dpduanpu/OncillaHardware/electronics/infrared-sensor/README.md

# Oncilla Infrared Camera

An Infrared Camera based on a Wii Sensor has been developed by Jonas Degrave for the Oncilla robot. However all work have been done through the collaborative website [123d circuits.io](http://http://123d.circuits.io/).

All schematics and PCB blueprint can be found [here](http://123d.circuits.io/circuits/47329-wii-v4-15#)
