dpduanpu/OncillaHardware/mechanics/oncilla/hip-front-new-right-2012-09-04.SLDASM

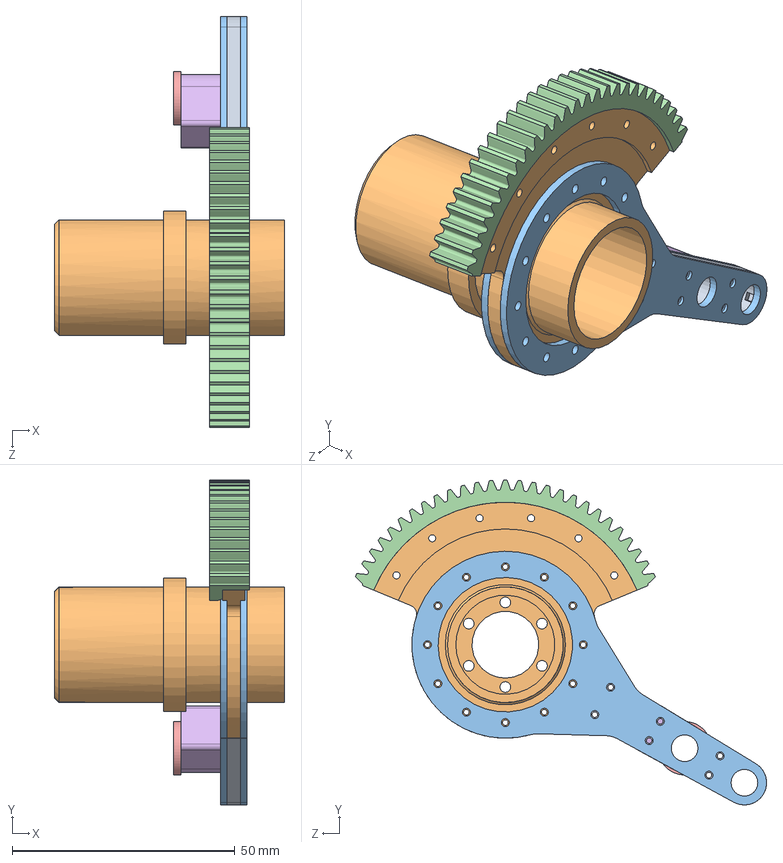
[picture p1: CAD file, 2014-03-28]
mechanics/oncilla/hip-front-new-right-2012-09-04.SLDASM
51.7 x 73.0 x 92.4 mm
abs-hip-front-2012-11-20
carbon-plat-hip-front x 2
Pom-plat-hip-front-04-03-13
Washer-d6p5-12
distancepiece_legsprings_011112_Mill_Pom
