dpduanpu/OncillaHardware/mechanics/oncilla/ASS-spring-diag-hind.sldasm

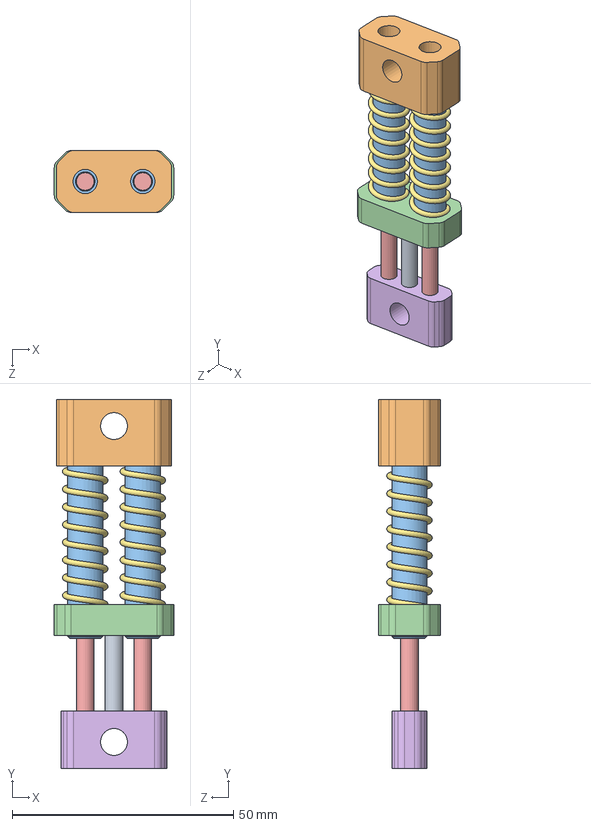
[picture p2: CAD file, 2014-03-28]
mechanics/oncilla/ASS-spring-diag-hind.sldasm
27.0 x 83.4 x 14.0 mm
al-slider-short-front
POM-cube-l2-lower
Pom1_d8-l44 x 2
double-slider
AL-D4-L50-Hind x 2
POM-cube-l2-upper
Spring_WM12-40 x 2
