dpduanpu/OncillaHardware/mechanics/oncilla/MirrorAssemL2-front.SLDASM

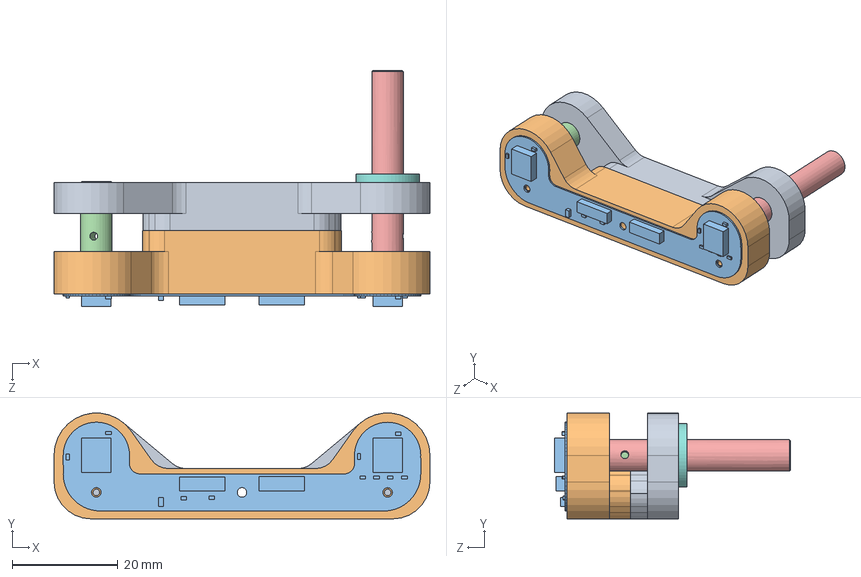
[picture p3: CAD file, 2014-03-28]
mechanics/oncilla/MirrorAssemL2-front.SLDASM
71.0 x 20.0 x 44.6 mm
Sym-POM-l2_v2-55mm-v3
Sym-ABS-l2_v2-55mm-v2
knee_encoder_front-ver-april18
pin-d6-l24
pin-d6-l33
Dia6x2p5 x 2
bush-d6-10 x 2
Washer-d6p5-12
