dpduanpu/OncillaHardware/mechanics/oncilla/Leg-Hind-Right.SLDASM

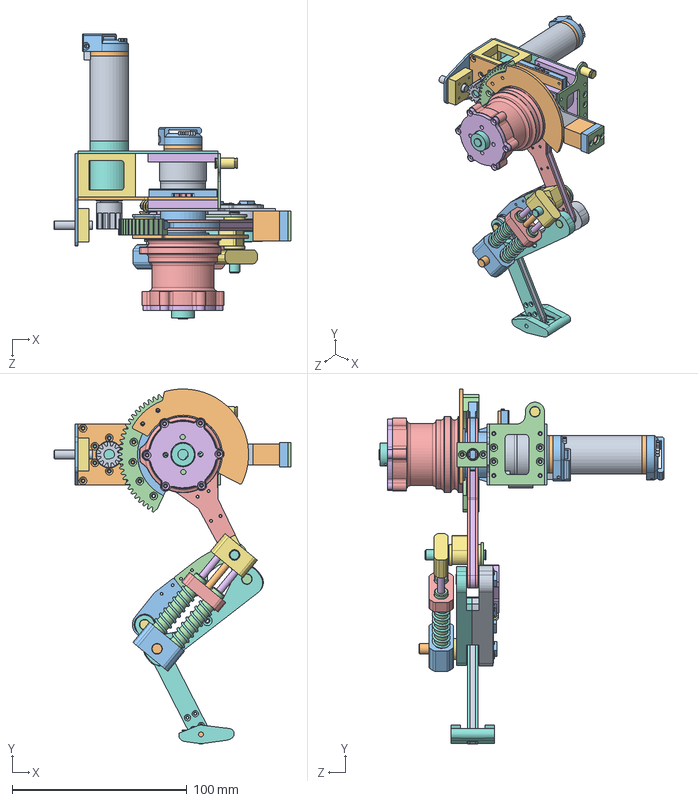
[picture p4: CAD file, 2014-03-28]
mechanics/oncilla/Leg-Hind-Right.SLDASM
135.3 x 202.9 x 162.9 mm
angle-fixation-POM-2012-11-08-bb2
angle-fixation-POM-BB-2012-11-08
carbon-1p5-cover-bb
bb-8x5x2p5 x 4
pom-holder
plate-side-4
clamp2
plate-side-1
N25_knee_motor_encoder
pom-bush-4x4
POM-fixation-abs-shoulde-rectangle
gearbox_MaxonHP22Ratio14 x 2
motor_Maxon90W4pole x 2
EncoderMotor x 2
MaxonCap_4march2013 x 2
RingGearN30
transmission-planetshell-4march2013-abs-print
LidPlanetGB
Planet_Revolving_FollowerN10h3mm x 4
Sun_DriverN10h4mm
N12_hip
Dia6x2p5 x 3
holder-encoder-hip
pcb_hip_encoder
M1-N12
SlipRing2
al_d6_1 x 2
Sym-l2-hind-65mm-v4
Sym-l2-hind-v4-65mm-inside
pin-d6-l33
knee_encoder_hind-ver-april18th
pin-d6-l24
bush-d6-10 x 2
bush-MDZB6-4-misumi x 2
Washer-d6p5-12 x 4
foot-print-mod1
Spring_RSF-1096R x 2
d3-l20
Part1-knee-mod3-hind
Part2-knee-mod3-hind
part2-knee-mod1
part4-knee-mod1 x 2
Spring_DF-1670
d5l35
lock washer for shafts_din x 2
washer-m3-6-3-1 x 4
abs-hip-front-2012-11-20
Hip_gear
carbon-plate-hip-hind x 2
Pom-plat-hip-hind-04-03-13
distancepiece_legsprings_011112_Mill_Pom
l3-sandwich-hind x 2
l3-sandwich-POM-hind
al-slider-short-front
POM-cube-l2-lower
Pom1_d8-l44 x 2
double-slider
AL-D4-L50-Hind x 2
POM-cube-l2-upper
Spring_WM12-40 x 2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
