dpduanpu/OncillaHardware/mechanics/oncilla/Assem1-knee-mod2-front.SLDASM

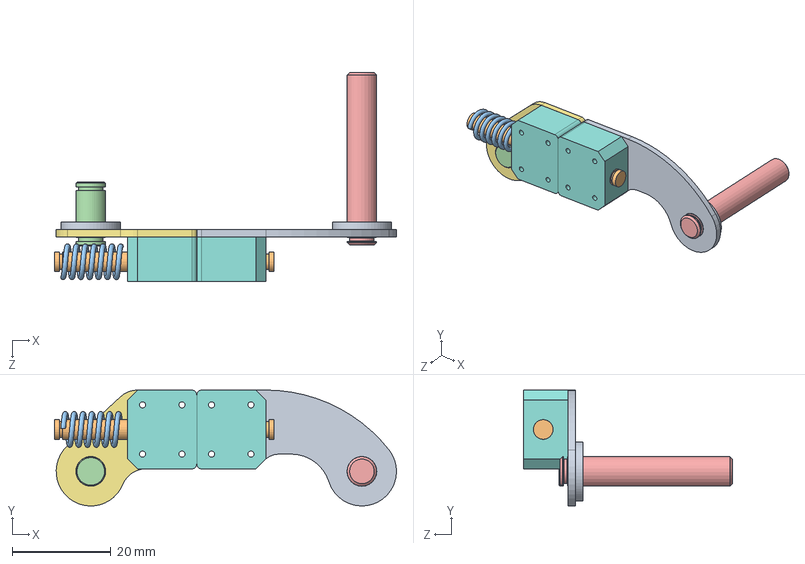
[picture p5: CAD file, 2014-03-28]
mechanics/oncilla/Assem1-knee-mod2-front.SLDASM
69.4 x 23.5 x 42.4 mm
Part2-knee-mod3-front
part2-knee-mod1
Spring_DF-1670
al_d6_1
d5l35
lock washer for shafts_din x 5
Part1-knee-mod3-front
part4-knee-mod1 x 2
Washer-d6p5-12 x 2
