dpduanpu/OncillaHardware/mechanics/oncilla/Assem1^ASS-spring-diag-hind.SLDASM

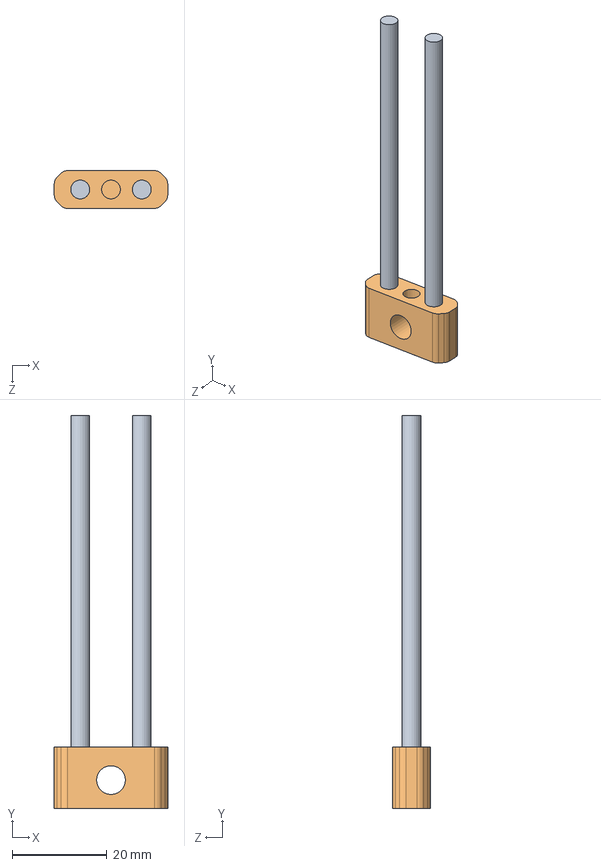
[picture p6: CAD file, 2014-03-28]
mechanics/oncilla/Assem1^ASS-spring-diag-hind.SLDASM
24.0 x 83.0 x 8.00 mm
AL-D4-L50-Hind x 2
POM-cube-l2-upper
