dpduanpu/OncillaHardware/mechanics/oncilla/hip-front-new-left-2012-09-04.SLDASM

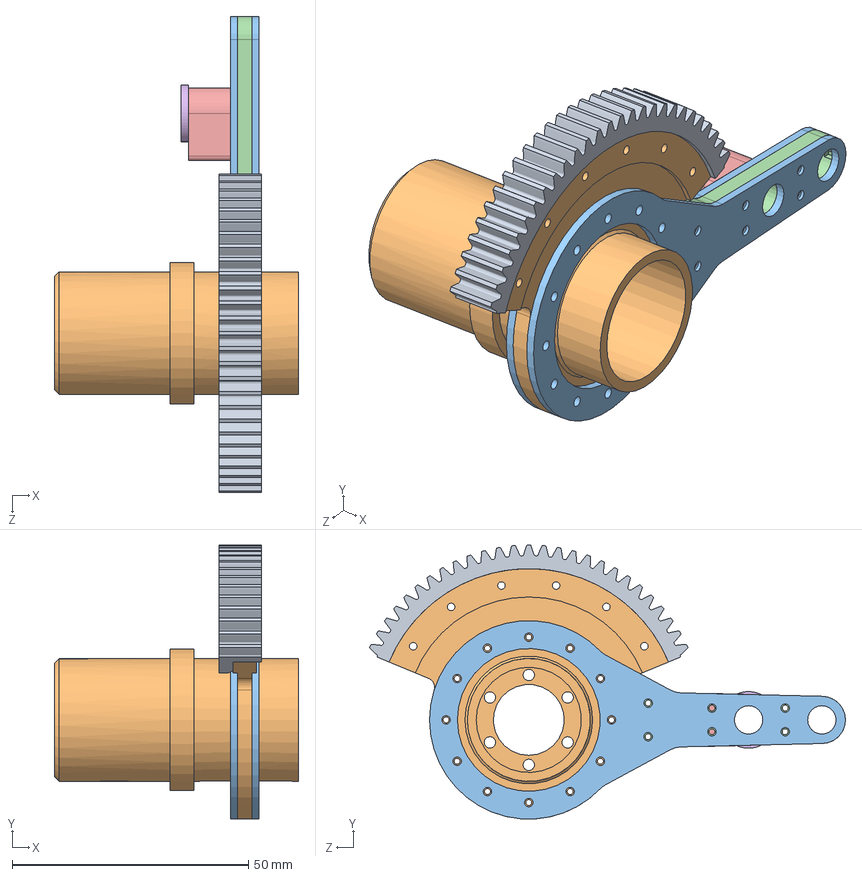
[picture p7: CAD file, 2014-03-28]
mechanics/oncilla/hip-front-new-left-2012-09-04.SLDASM
51.7 x 58.0 x 100.7 mm
abs-hip-front-2012-11-20
carbon-plat-hip-front x 2
Hip_gear
Pom-plat-hip-front-04-03-13
distancepiece_legsprings_011112_Mill_Pom
Washer-d6p5-12
