dpduanpu/OncillaHardware/mechanics/oncilla/clamp_new.SLDASM

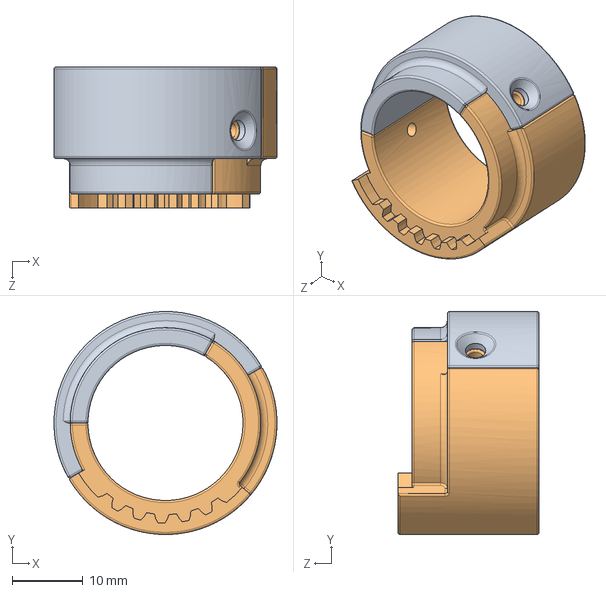
[picture p8: CAD file, 2014-03-28]
mechanics/oncilla/clamp_new.SLDASM
31.6 x 31.6 x 20.0 mm
clamp_lower
clamp_upper
