dpduanpu/OncillaHardware/mechanics/oncilla/bb-fixation-diagonal1.sldasm

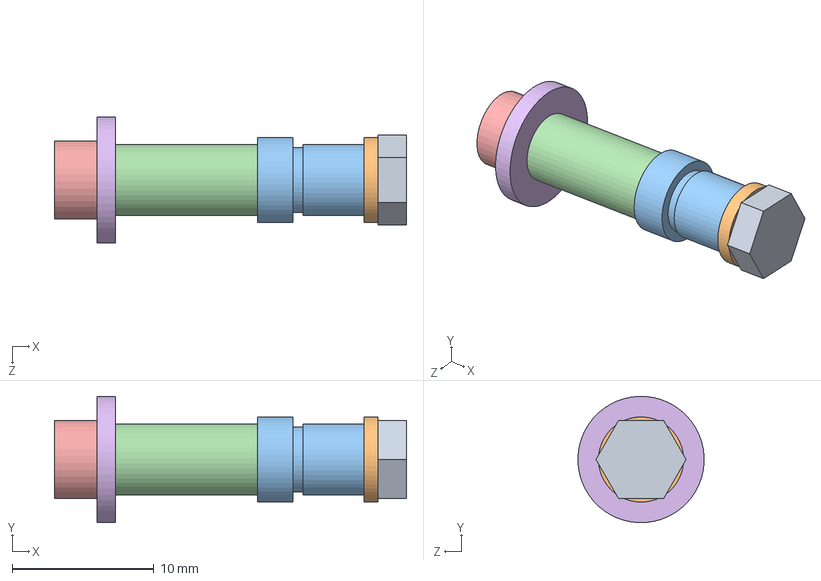
[picture p9: CAD file, 2014-03-28]
mechanics/oncilla/bb-fixation-diagonal1.sldasm
24.8 x 8.90 x 8.89 mm
m3-shorthead
washer-m3-6-3-1
d5-d6-alu-b2p5-b5
axis-hip-l10-PM-20120918
M3L14-BN3-DIN912-ISO4762
washer-m3-douter8p9-width1p3
