dpduanpu/OncillaHardware/mechanics/oncilla/force-setup.SLDASM

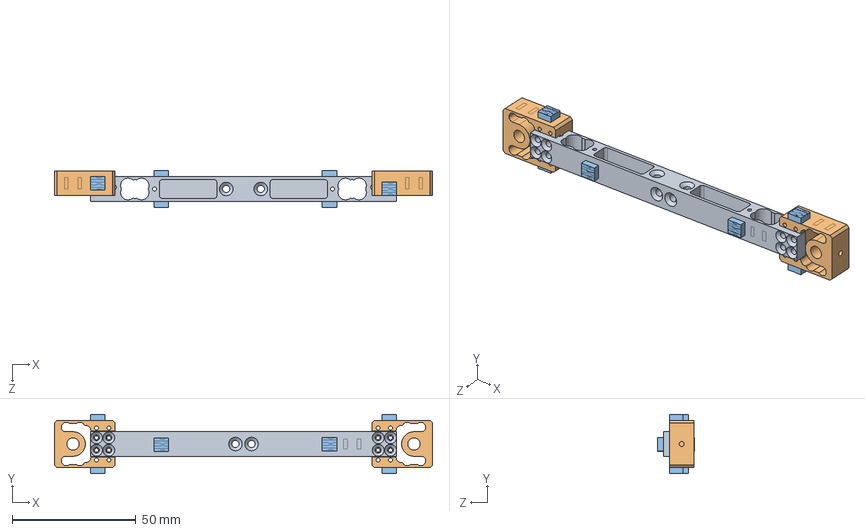
[picture p10: CAD file, 2014-03-28]
mechanics/oncilla/force-setup.SLDASM
153.0 x 24.0 x 15.0 mm
load-cell-alu-beam-force-horizontal-2012-08-25
load-cell-alu-y-force-beam x 2
fr4-0p8-pcb-bridge-force-sensor x 8
