dpduanpu/OncillaHardware/mechanics/oncilla/carbon-l3-sandwich.SLDASM

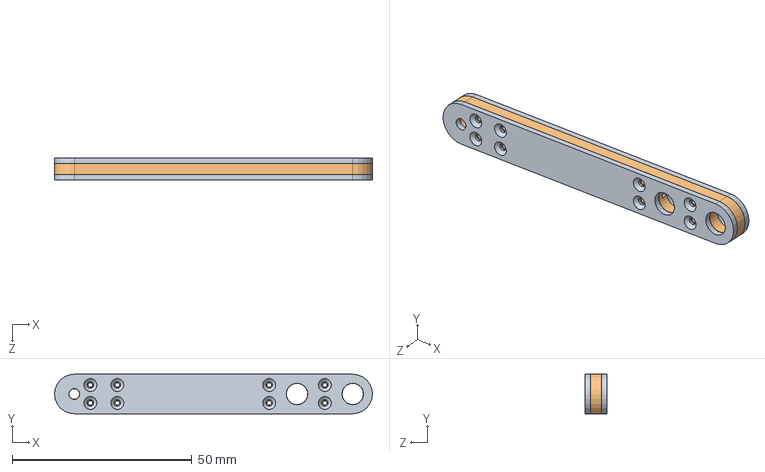
[picture p11: CAD file, 2014-03-28]
mechanics/oncilla/carbon-l3-sandwich.SLDASM
88.5 x 11.0 x 6.00 mm
l3-sandwich x 2
l3-sandwich_pom
