dpduanpu/OncillaHardware/mechanics/oncilla/hip-hind-new-right-2012-09-05.SLDASM

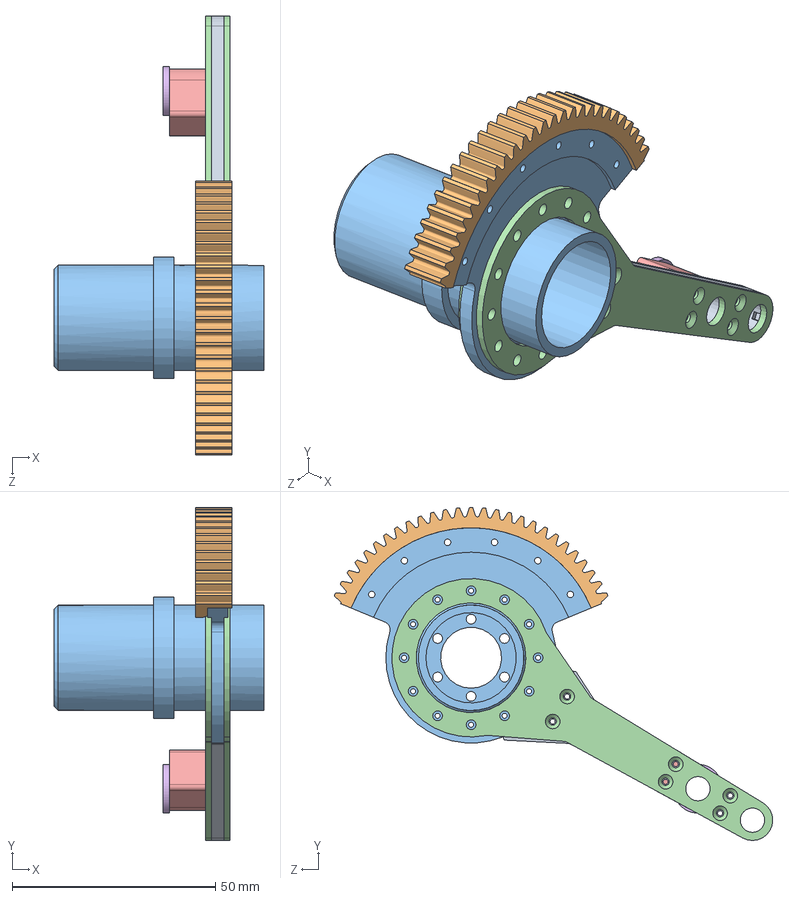
[picture p12: CAD file, 2014-03-28]
mechanics/oncilla/hip-hind-new-right-2012-09-05.SLDASM
51.7 x 82.0 x 108.0 mm
abs-hip-front-2012-11-20
Hip_gear
carbon-plate-hip-hind x 2
Pom-plat-hip-hind-04-03-13
distancepiece_legsprings_011112_Mill_Pom
Washer-d6p5-12
