dpduanpu/OncillaHardware/mechanics/oncilla/MotorGearbox_Maxon90W22HP14.SLDASM

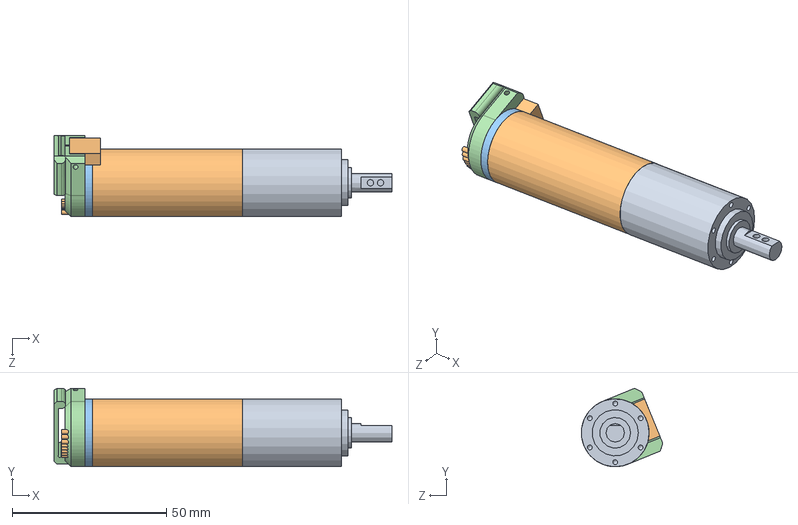
[picture p13: CAD file, 2014-03-28]
mechanics/oncilla/MotorGearbox_Maxon90W22HP14.SLDASM
109.6 x 25.4 x 26.4 mm
gearbox_MaxonHP22Ratio14
motor_Maxon90W4pole
EncoderMotor
MaxonCap_4march2013
