dpduanpu/OncillaHardware/mechanics/oncilla/force-assembly-front.SLDASM

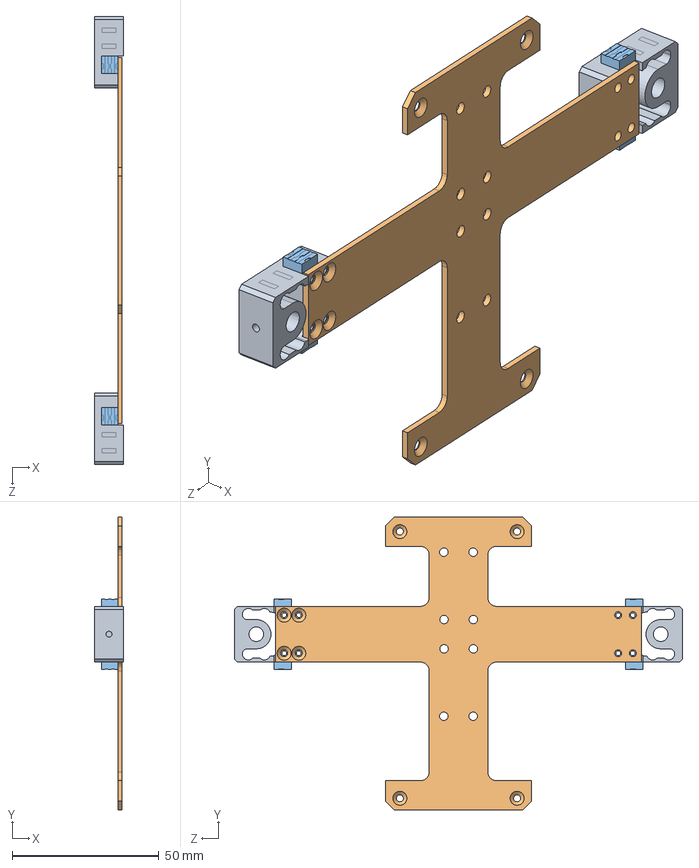
[picture p14: CAD file, 2014-03-28]
mechanics/oncilla/force-assembly-front.SLDASM
10.0 x 100.0 x 153.0 mm
load-cell-alu-y-force-beam-outside x 2
Part55-front
fr4-0p8-pcb-bridge-force-sensor x 4
