dpduanpu/OncillaHardware/mechanics/oncilla/Assem1-knee-mod1-hind.SLDASM

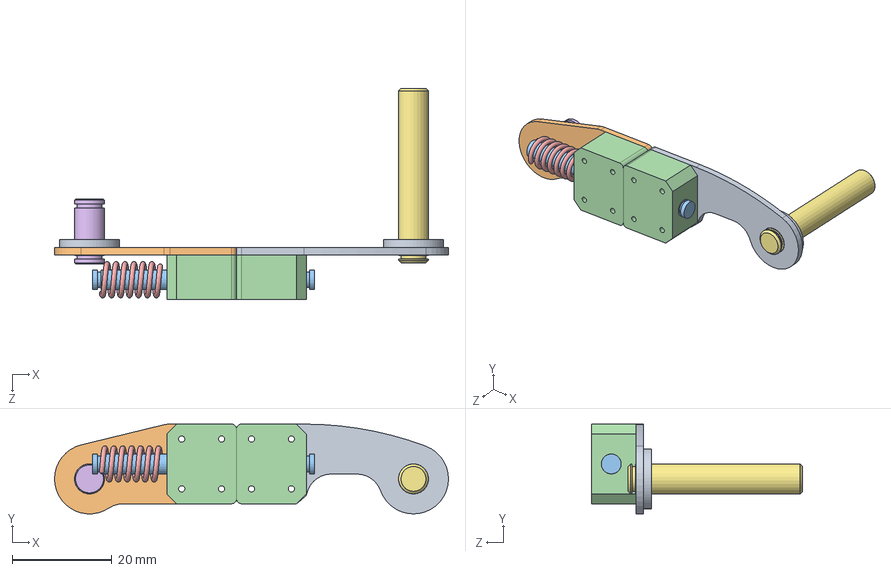
[picture p15: CAD file, 2014-03-28]
mechanics/oncilla/Assem1-knee-mod1-hind.SLDASM
79.0 x 18.0 x 42.4 mm
Part2-knee-mod3-hind
Part1-knee-mod3-hind
part2-knee-mod1
part4-knee-mod1 x 2
Spring_DF-1670
al_d6_1
d5l35
lock washer for shafts_din x 4
Washer-d6p5-12 x 2
