dpduanpu/OncillaHardware/mechanics/oncilla/ShoulderRHL.sldasm

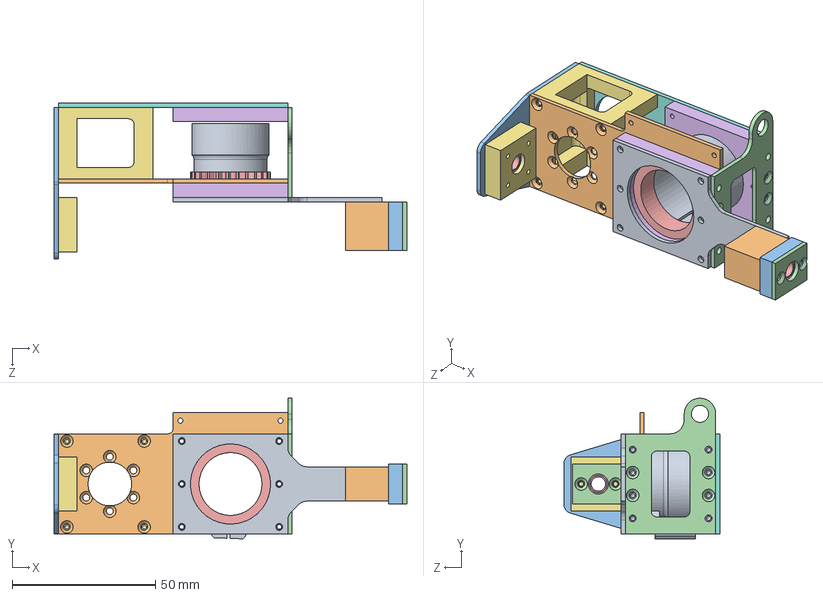
[picture p16: CAD file, 2014-03-28]
mechanics/oncilla/ShoulderRHL.sldasm
123.3 x 49.2 x 54.5 mm
angle-fixation-POM-2012-11-08-bb2
angle-fixation-POM-BB-2012-11-08
carbon-1p5-cover-bb
bb-8x5x2p5 x 4
pom-holder
plate-side-4
clamp2
plate-side-1
N25_knee_motor_encoder
pom-bush-4x4
POM-fixation-abs-shoulde-rectangle
