dpduanpu/OncillaHardware/mechanics/oncilla/trunk-assembly.SLDASM

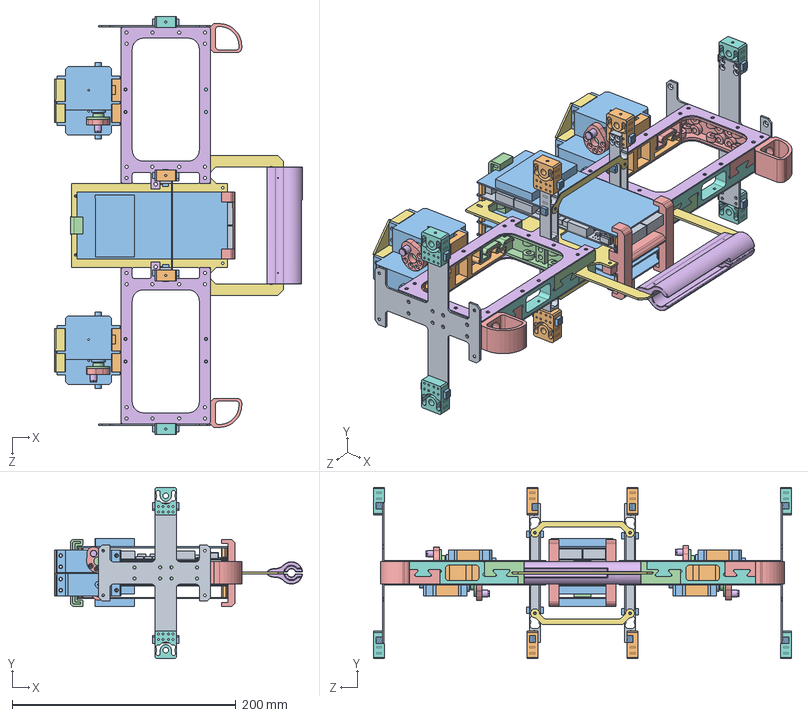
[picture p17: CAD file, 2014-03-28]
mechanics/oncilla/trunk-assembly.SLDASM
221.7 x 153.0 x 374.0 mm
load-cell-alu-beam-force-horizontal-2012-08-25 x 2
load-cell-alu-y-force-beam x 4
fr4-0p8-pcb-bridge-force-sensor x 24
abs-connector-mid-front-hind x 2
abs-column-outside x 2
al-back-left x 4
frame-temp
load-cell-alu-y-force-beam-outside x 4
Part55-front x 2
abs-servo-connectors-z-version2 x 2
kondo-krs-2350-ics-asp-2012-02-16 x 4
horn-servo-puppy x 4
holder-ServoHorn-03052012-abs x 4
al_d5_8p5 x 4
Mirrorabs-servo-connectors-z-version2-down x 2
NOTMirrorabs_zwing x 2
hex-standoff-m2p5-15SLDPRT x 10
simple_motordrive x 4
POM-support-PCB
abs-pcb-holder-top-2012-11-16
handle6_withBattery
carbon-thin-stripes-2012-05-09 x 2
