dpduanpu/OncillaHardware/mechanics/oncilla/hip-hind-new-left-2012-09-05.SLDASM

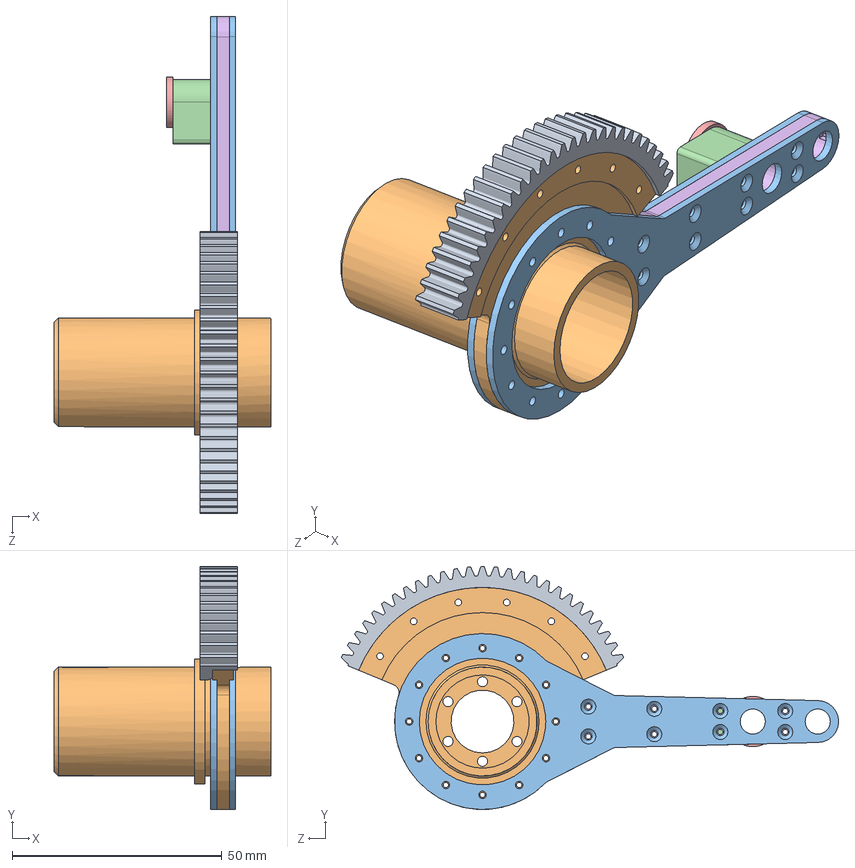
[picture p18: CAD file, 2014-03-28]
mechanics/oncilla/hip-hind-new-left-2012-09-05.SLDASM
51.7 x 58.0 x 118.7 mm
abs-hip-front-2012-11-20
Hip_gear
carbon-plate-hip-hind x 2
distancepiece_legsprings_011112_Mill_Pom
Washer-d6p5-12
Pom-plat-hip-hind-04-03-13
