dpduanpu/OncillaHardware/mechanics/oncilla/Leg-Fore-Right.SLDASM

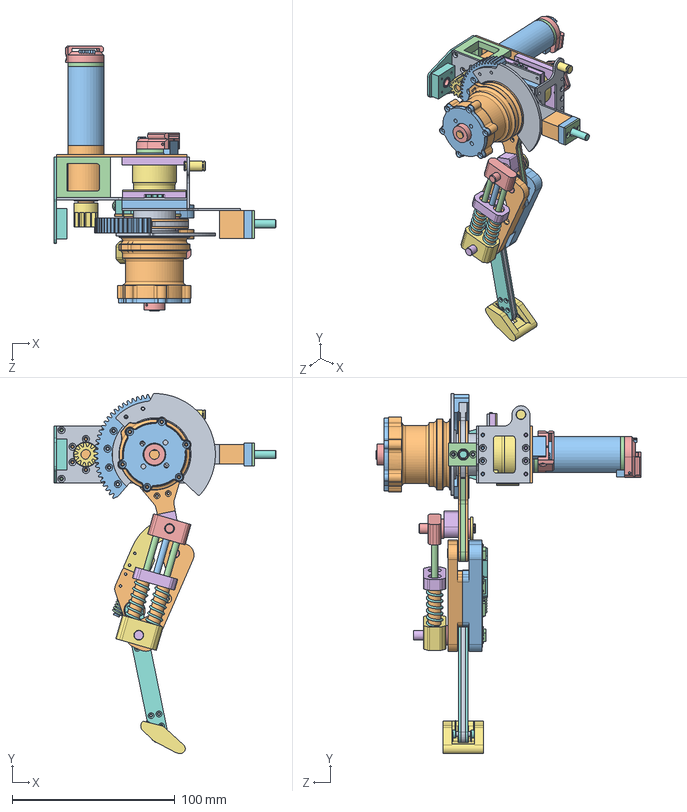
[picture p20: CAD file, 2014-03-28]
mechanics/oncilla/Leg-Fore-Right.SLDASM
136.3 x 221.4 x 162.9 mm
plate-side-1
gearbox_MaxonHP22Ratio14 x 2
motor_Maxon90W4pole x 2
EncoderMotor x 2
MaxonCap_4march2013 x 2
pom-bush-4x4
clamp2
plate-side-4
pom-holder
Dia6x2p5 x 3
holder-encoder-hip
pcb_hip_encoder
M1-N12
angle-fixation-POM-2012-11-08-bb2
angle-fixation-POM-BB-2012-11-08
carbon-1p5-cover-bb
bb-8x5x2p5 x 4
N25_knee_motor_encoder
N12_hip
axis-l25-dia5
RingGearN30
transmission-planetshell-4march2013-abs-print
LidPlanetGB
Planet_Revolving_FollowerN10h3mm x 4
Sun_DriverN10h4mm
SlipRing2
al_d6_1 x 2
POM-fixation-abs-shoulde-rectangle
abs-hip-front-2012-11-20
carbon-plat-hip-front x 2
Pom-plat-hip-front-04-03-13
Washer-d6p5-12 x 4
distancepiece_legsprings_011112_Mill_Pom
foot-print-mod1
Spring_RSF-1096R x 2
d3-l20
Part1-knee-mod3-front
part2-knee-mod1
Spring_DF-1670
d5l35
lock washer for shafts_din x 4
Part2-knee-mod3-front
part4-knee-mod1 x 2
washer-m3-6-3-1 x 4
Sym-POM-l2_v2-55mm-v3
Sym-ABS-l2_v2-55mm-v2
knee_encoder_front-ver-april18
pin-d6-l24
pin-d6-l33
bush-d6-10 x 2
l3-sandwich x 2
l3-sandwich_pom
POM-D8-L34 x 2
AL-D4-L29-front
AL-D4-L50-front x 2
POM-cube-l2-upper
double-slider
POM-cube-l2-lower
Spring_RDF-1799 x 2
cableshield
