dpduanpu/OncillaHardware/mechanics/oncilla/Assem3-servo-with-horn.sldasm

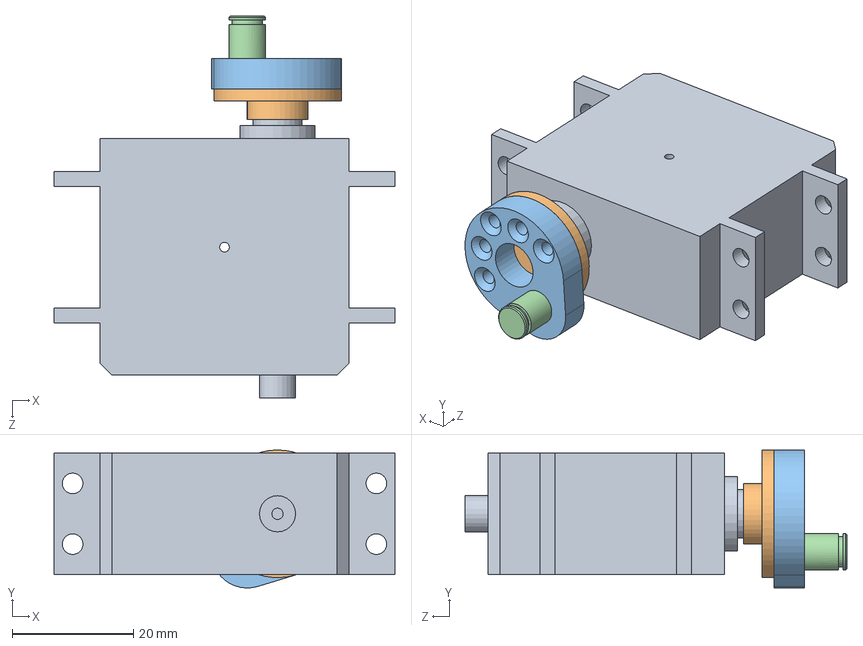
[picture p21: CAD file, 2014-03-28]
mechanics/oncilla/Assem3-servo-with-horn.sldasm
56.1 x 22.7 x 62.9 mm
kondo-krs-2350-ics-asp-2012-02-16
horn-servo-puppy
holder-ServoHorn-03052012-abs
al_d5_8p5
