dpduanpu/OncillaHardware/mechanics/oncilla/RB110-assembly.SLDASM

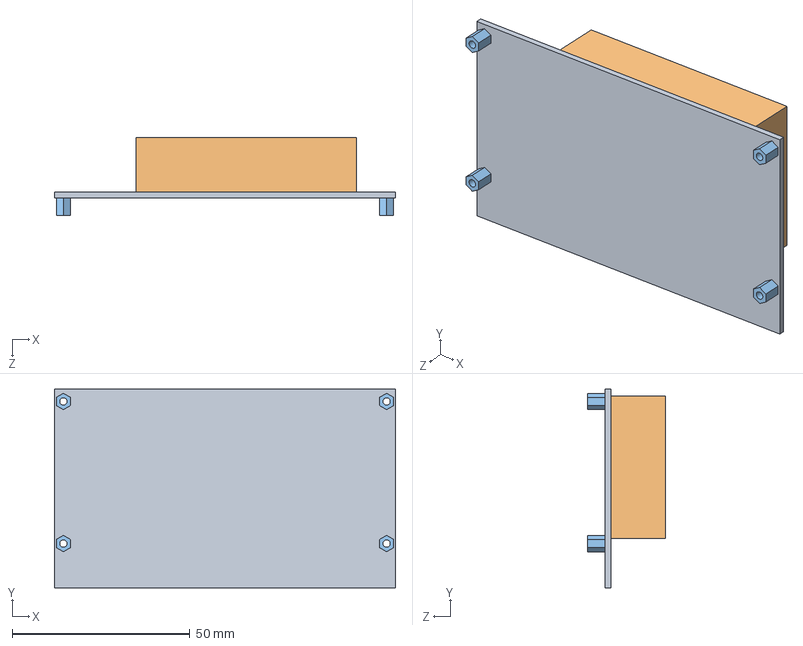
[picture p22: CAD file, 2014-03-28]
mechanics/oncilla/RB110-assembly.SLDASM
96.0 x 56.0 x 22.0 mm
BaseBoardRB110
GraCaRB110
DistancePieceM2p5D5L5mm x 4
