dpduanpu/OncillaHardware/mechanics/oncilla/l3-sandwich-hind.SLDASM

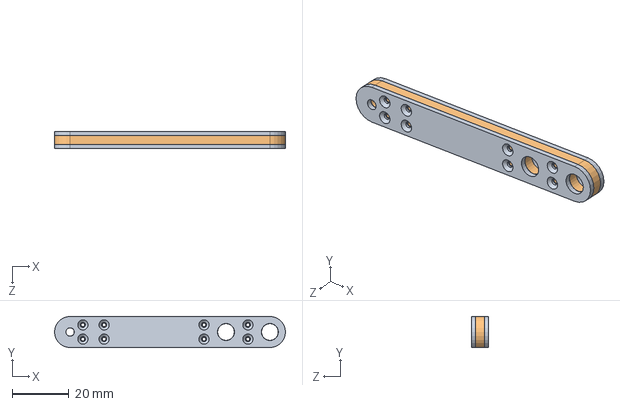
[picture p23: CAD file, 2014-03-28]
mechanics/oncilla/l3-sandwich-hind.SLDASM
81.5 x 11.0 x 6.00 mm
l3-sandwich-hind x 2
l3-sandwich-POM-hind
