dpduanpu/OncillaHardware/mechanics/oncilla/MirrorAssemL2-hind-print1.SLDASM

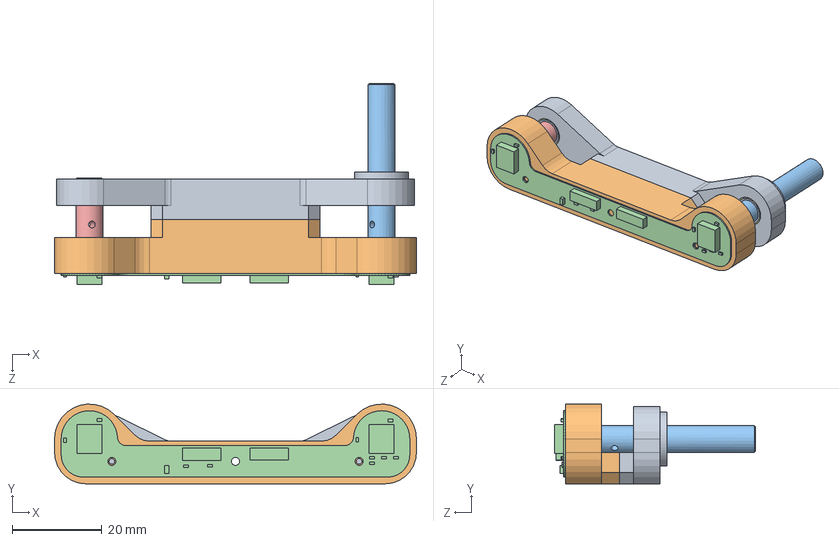
[picture p24: CAD file, 2014-03-28]
mechanics/oncilla/MirrorAssemL2-hind-print1.SLDASM
80.5 x 17.7 x 44.6 mm
Sym-l2-hind-65mm-v4
Sym-l2-hind-v4-65mm-inside
pin-d6-l33
knee_encoder_hind-ver-april18th
pin-d6-l24
bush-d6-10 x 2
bush-MDZB6-4-misumi x 2
Dia6x2p5 x 2
Washer-d6p5-12
