dpduanpu/OncillaHardware/mechanics/oncilla/hip-encoder.SLDASM

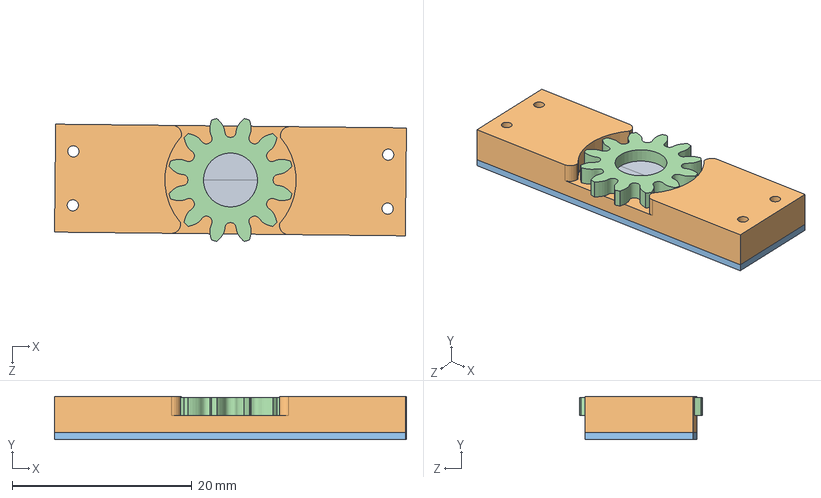
[picture p26: CAD file, 2014-03-28]
mechanics/oncilla/hip-encoder.SLDASM
39.1 x 4.80 x 13.7 mm
Dia6x2p5
holder-encoder-hip
pcb_hip_encoder
M1-N12
