dpduanpu/OncillaHardware/mechanics/oncilla/Assem1-knee-mod1-hind-mirror.SLDASM

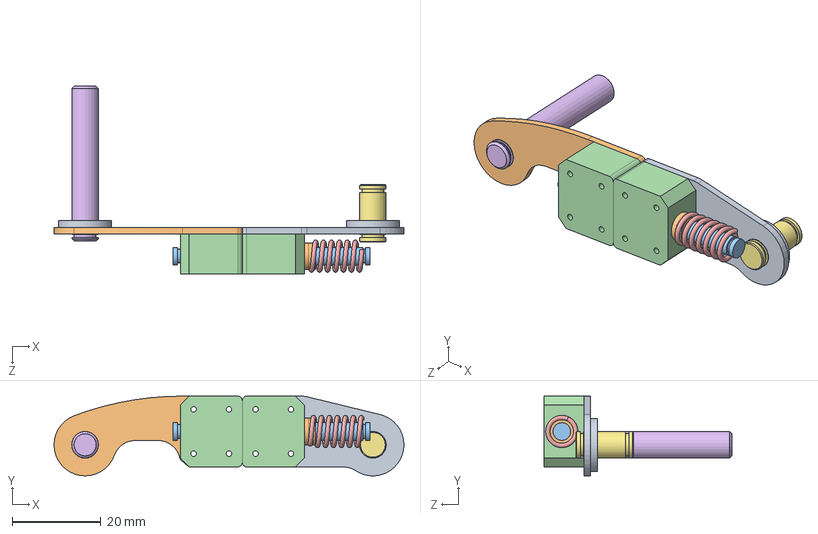
[picture p27: CAD file, 2014-03-28]
mechanics/oncilla/Assem1-knee-mod1-hind-mirror.SLDASM
79.0 x 18.0 x 42.4 mm
Part1-knee-mod3-hind
Part2-knee-mod3-hind
part2-knee-mod1
part4-knee-mod1 x 2
Spring_DF-1670
d5l35
al_d6_1
lock washer for shafts_din x 2
Washer-d6p5-12 x 2
washer-m3-6-3-1 x 4
