dpduanpu/OncillaHardware/mechanics/oncilla/ASS-spring-diag-front_Left.SLDASM

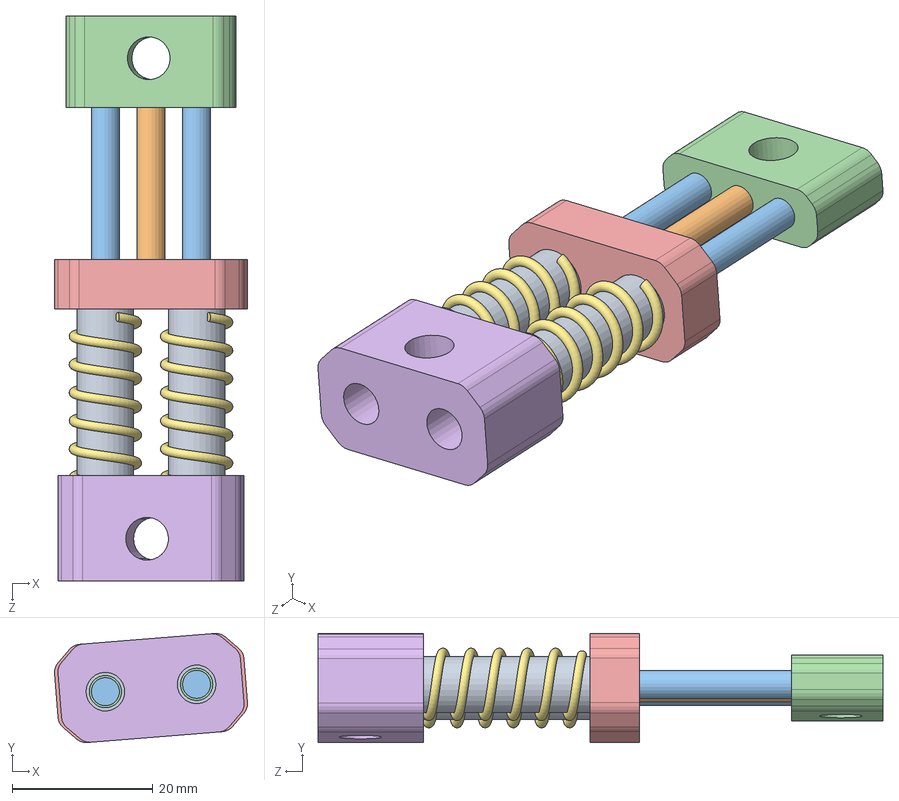
[picture p28: CAD file, 2014-03-28]
mechanics/oncilla/ASS-spring-diag-front_Left.SLDASM
27.4 x 15.5 x 80.3 mm
POM-D8-L34 x 2
AL-D4-L29-front
AL-D4-L50-front x 2
POM-cube-l2-upper
double-slider
POM-cube-l2-lower
Spring_RDF-1799 x 2
