dpduanpu/OncillaHardware/mechanics/oncilla/trunk-handle.SLDASM

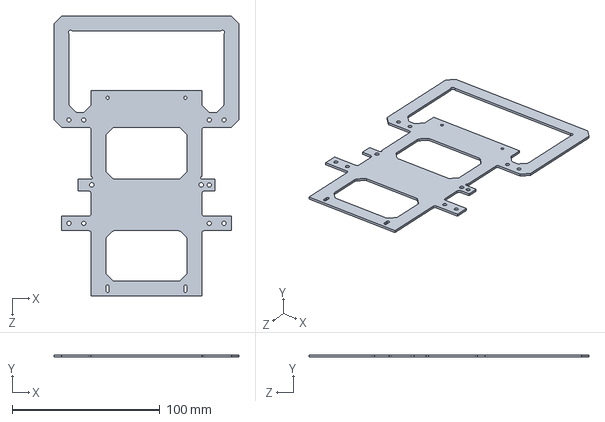
[picture p29: CAD file, 2014-03-28]
mechanics/oncilla/trunk-handle.SLDASM
125.0 x 1.60 x 189.6 mm
