dpduanpu/OncillaHardware/mechanics/oncilla/Foot_assembly.sldasm

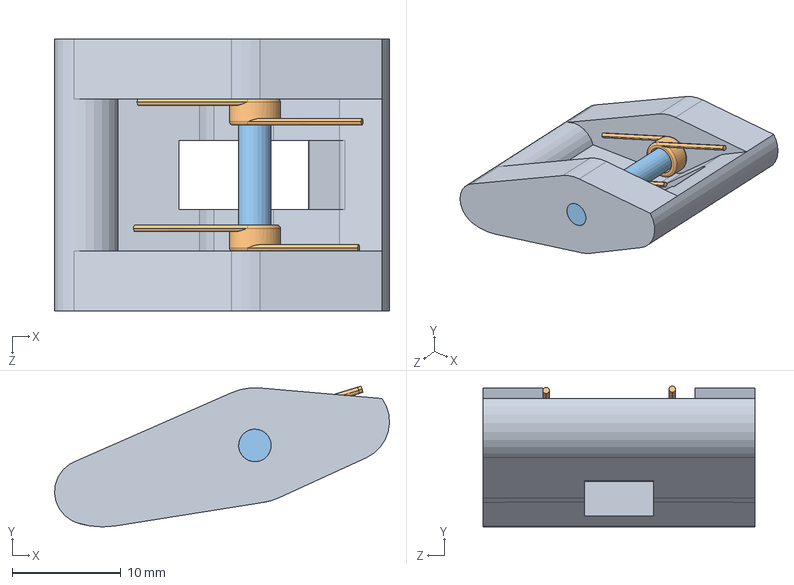
[picture p30: CAD file, 2014-03-28]
mechanics/oncilla/Foot_assembly.sldasm
30.8 x 13.0 x 25.0 mm
foot-print-mod1
Spring_RSF-1096R x 2
d3-l20
