dpduanpu/OncillaHardware/mechanics/oncilla/AssemL2-hind-print.SLDASM

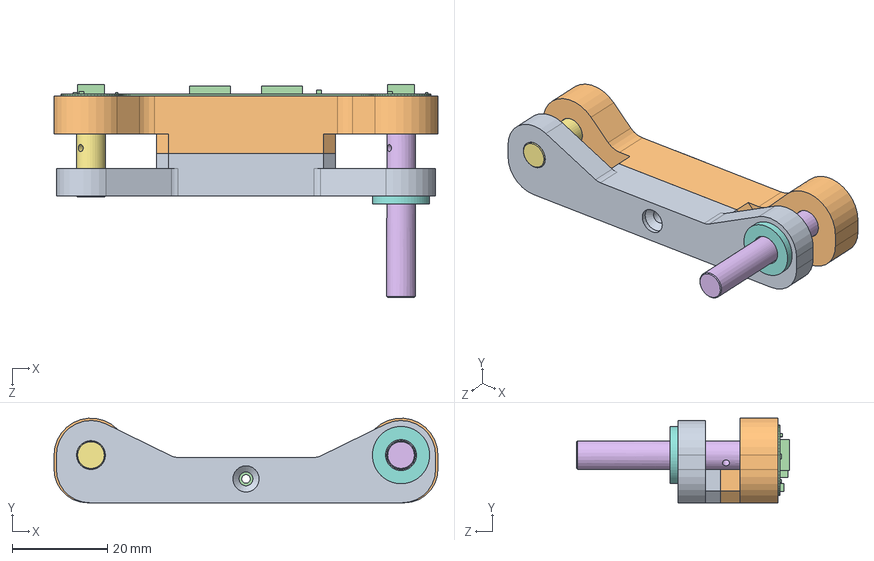
[picture p31: CAD file, 2014-03-28]
mechanics/oncilla/AssemL2-hind-print.SLDASM
80.5 x 17.7 x 44.6 mm
l2-hind-65mm-v4
l2-hind-v4-65mm-inside
Dia6x2p5 x 2
knee_encoder_hind-ver-april18th
bush-d6-10 x 2
pin-d6-l33
pin-d6-l24
Washer-d6p5-12
