dpduanpu/OncillaHardware/mechanics/oncilla/motordriver-v3-assembly.SLDASM

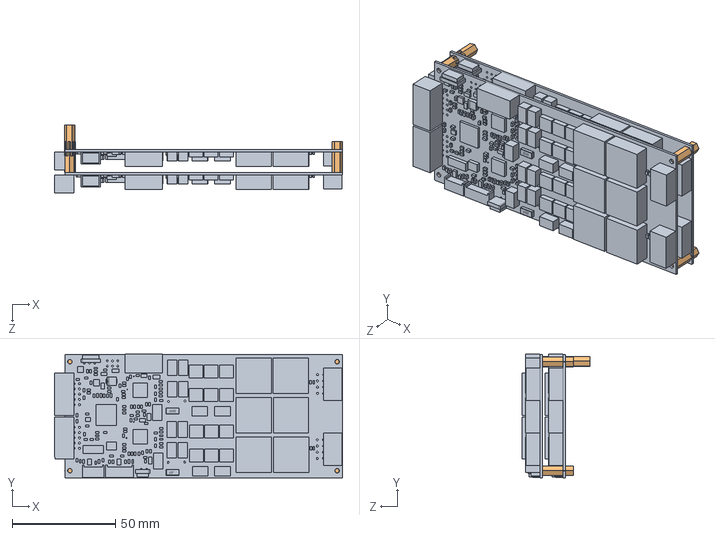
[picture p32: CAD file, 2014-03-28]
mechanics/oncilla/motordriver-v3-assembly.SLDASM
139.3 x 59.9 x 33.0 mm
motordriver_v3 x 2
hex-standoff-m2p5-15SLDPRT x 5
