dpduanpu/OncillaHardware/mechanics/oncilla/planet-GB-4to1.SLDASM

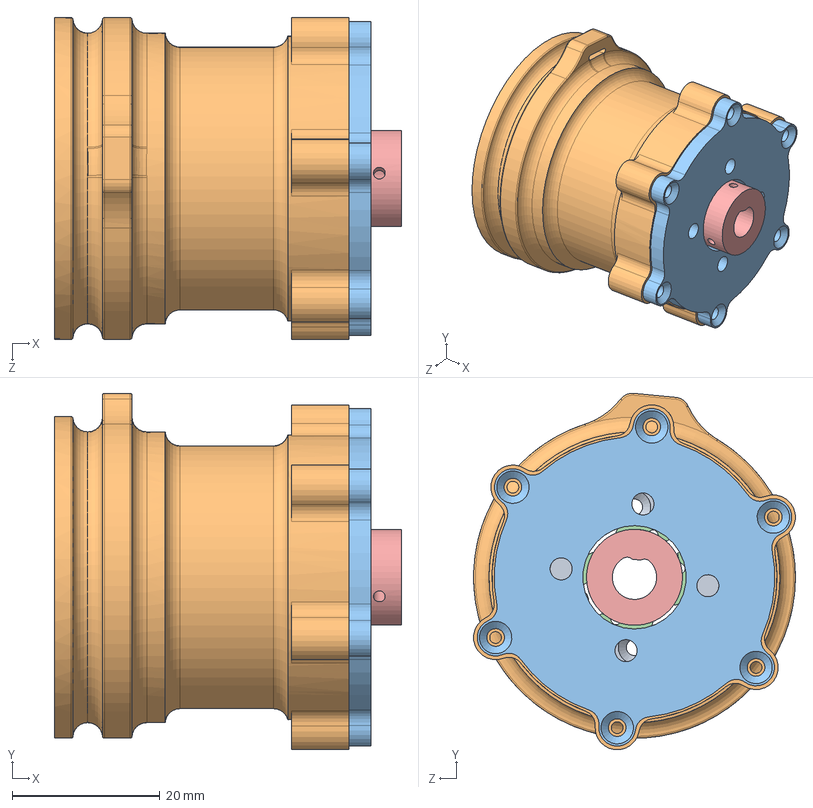
[picture p33: CAD file, 2014-03-28]
mechanics/oncilla/planet-GB-4to1.SLDASM
47.0 x 48.3 x 43.6 mm
RingGearN30
transmission-planetshell-4march2013-abs-print
LidPlanetGB
Planet_Revolving_FollowerN10h3mm x 4
Sun_DriverN10h4mm
