dpduanpu/OncillaHardware/mechanics/oncilla/pair-servo.SLDASM

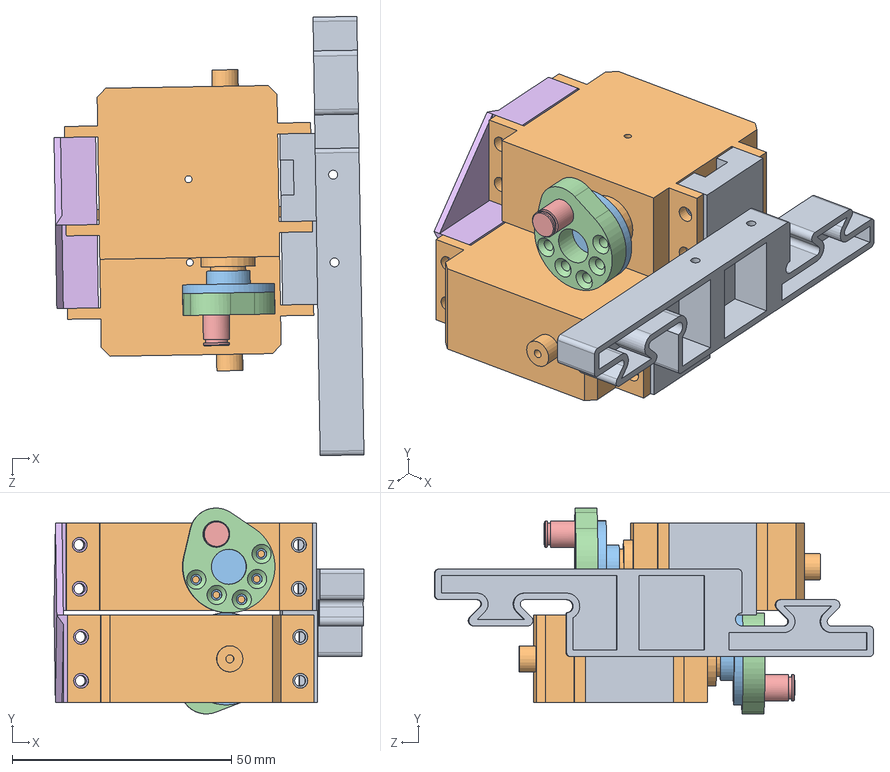
[picture p34: CAD file, 2014-03-28]
mechanics/oncilla/pair-servo.SLDASM
70.7 x 46.9 x 100.1 mm
abs-servo-connectors-z-version2
kondo-krs-2350-ics-asp-2012-02-16 x 2
horn-servo-puppy x 2
holder-ServoHorn-03052012-abs x 2
al_d5_8p5 x 2
Mirrorabs-servo-connectors-z-version2-down
