dpduanpu/OncillaHardware/mechanics/oncilla/PowerBoardAssembly.SLDASM

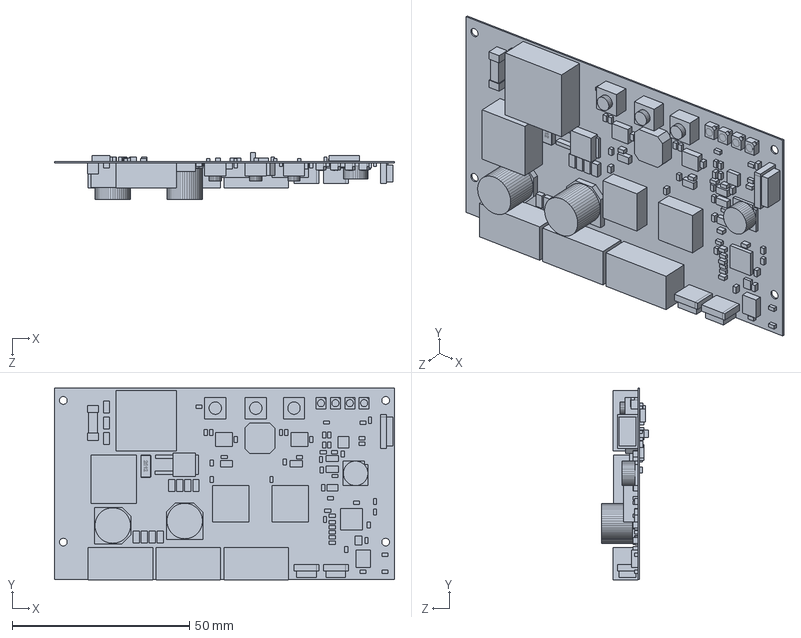
[picture p35: CAD file, 2014-03-28]
mechanics/oncilla/PowerBoardAssembly.SLDASM
96.0 x 54.2 x 13.2 mm
