dpduanpu/OncillaHardware/mechanics/oncilla/leg-FL.SLDASM

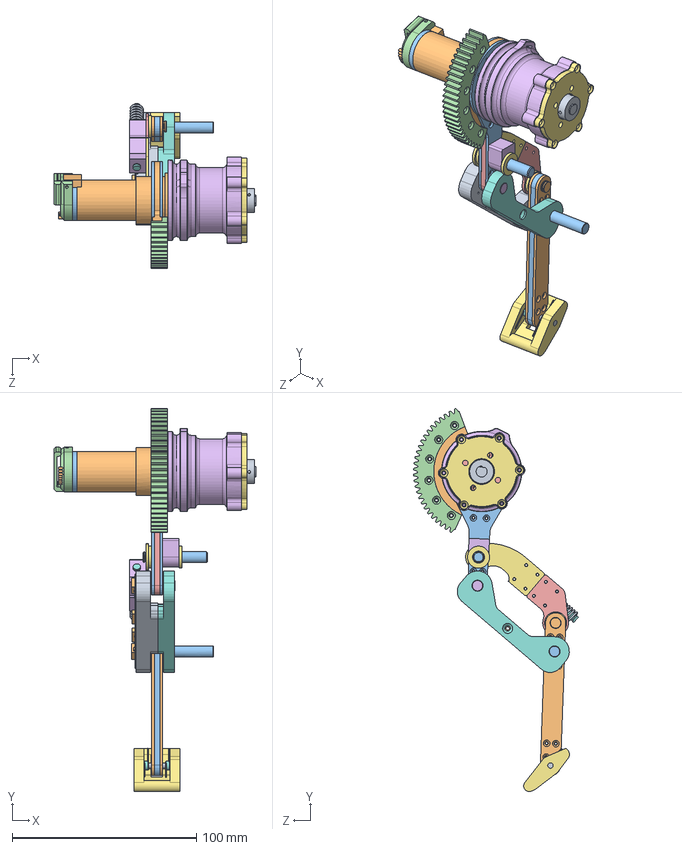
[picture p36: CAD file, 2014-03-23]
mechanics/oncilla/leg-FL.SLDASM
109.6 x 207.9 x 89.6 mm
gearbox_MaxonHP22Ratio14
motor_Maxon90W4pole
EncoderMotor
MaxonCap_4march2013
RingGearN30
transmission-planetshell-4march2013-abs-print
LidPlanetGB
Planet_Revolving_FollowerN10h3mm x 4
Sun_DriverN10h4mm
abs-hip-front-2012-11-20
carbon-plat-hip-front x 2
Hip_gear
Pom-plat-hip-front-04-03-13
distancepiece_legsprings_011112_Mill_Pom
Washer-d6p5-12 x 3
POM-l2_v2-55mm-v3
ABS-l2_v2-55mm-v2
knee_encoder_front-ver-april18
pin-d6-l33
Dia6x2p5 x 2
bush-d6-10 x 2
pin-d6-l24
Part2-knee-mod3-front
part2-knee-mod1
Spring_DF-1670
al_d6_1
d5l35
lock washer for shafts_din x 5
Part1-knee-mod3-front
part4-knee-mod1 x 2
foot-print-mod1
Spring_RSF-1096R x 2
d3-l20
l3-sandwich x 2
l3-sandwich_pom
SlipRing2
