dpduanpu/OncillaHardware/mechanics/oncilla/hip-front-new-2012-09-04.SLDASM

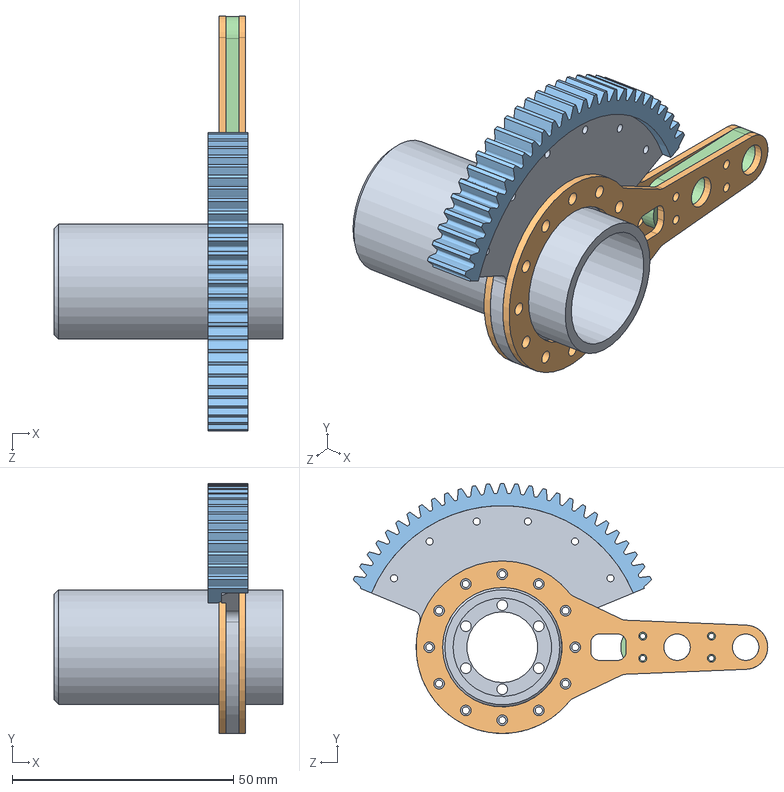
[picture p37: CAD file, 2014-03-23]
mechanics/oncilla/hip-front-new-2012-09-04.SLDASM
51.7 x 56.5 x 93.7 mm
abs-hip-front-2012-09-04
carbon-plat-hip-front x 2
hip-front-fudder
