dpduanpu/OncillaHardware/mechanics/oncilla/kondo-krs-2350-ics-asp-2012-02-16.SLDPRT

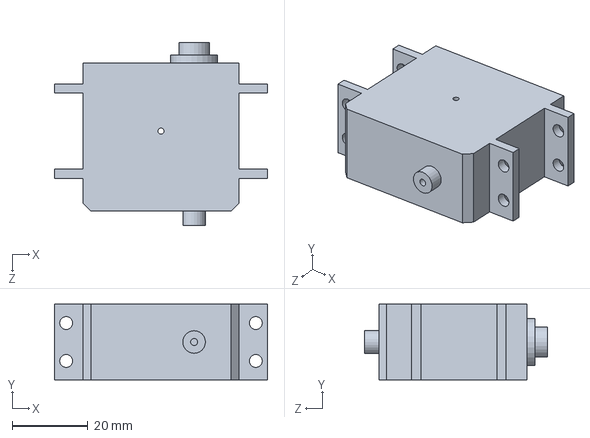
[picture p38: CAD file, 2014-03-28]
mechanics/oncilla/kondo-krs-2350-ics-asp-2012-02-16.SLDPRT
56.1 x 20.0 x 48.1 mm
