dpduanpu/OncillaHardware/mechanics/oncilla/abs-cover-inside.SLDPRT

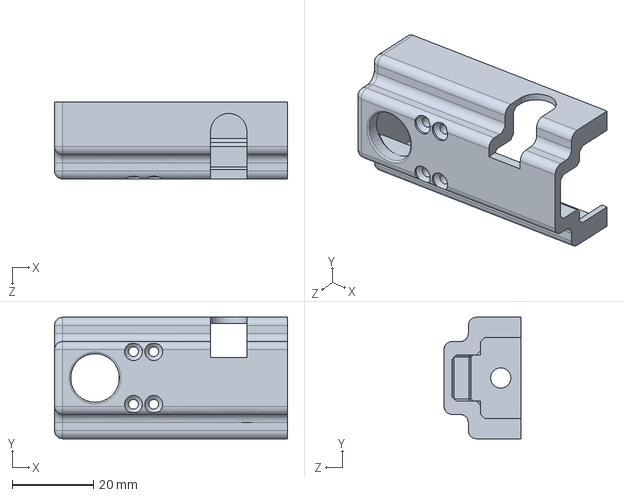
[picture p39: CAD file, 2014-03-28]
mechanics/oncilla/abs-cover-inside.SLDPRT
57.5 x 30.0 x 19.0 mm
