dpduanpu/OncillaHardware/mechanics/oncilla/Part55-front.SLDPRT

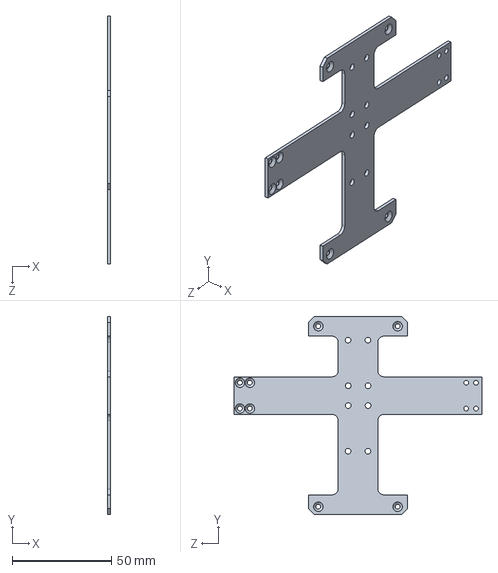
[picture p40: CAD file, 2014-03-28]
mechanics/oncilla/Part55-front.SLDPRT
1.50 x 100.0 x 125.0 mm
