dpduanpu/OncillaHardware/mechanics/oncilla/abs-column-outside.SLDPRT

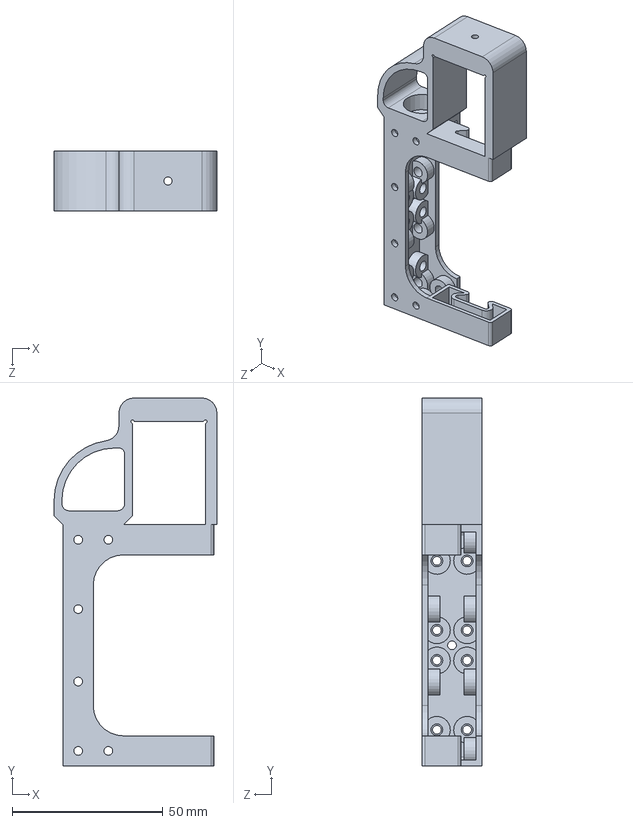
[picture p41: CAD file, 2014-03-28]
mechanics/oncilla/abs-column-outside.SLDPRT
54.0 x 122.0 x 20.0 mm
