dpduanpu/OncillaHardware/mechanics/oncilla/Pom-plat-hip-front-04-03-13.SLDPRT

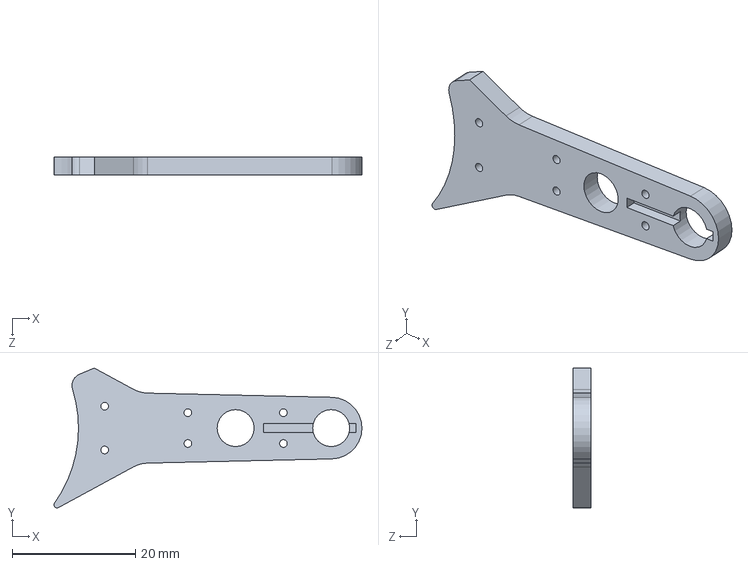
[picture p42: CAD file, 2014-03-28]
mechanics/oncilla/Pom-plat-hip-front-04-03-13.SLDPRT
50.0 x 22.7 x 3.00 mm
