dpduanpu/OncillaHardware/mechanics/oncilla/l2-hind-v4-65mm-inside.SLDPRT

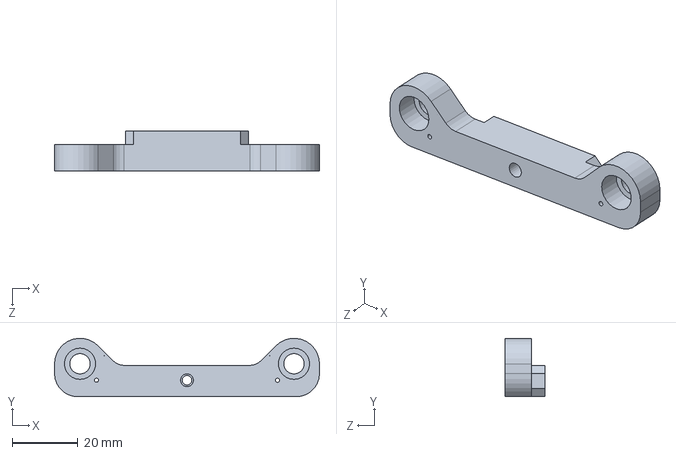
[picture p43: CAD file, 2014-03-28]
mechanics/oncilla/l2-hind-v4-65mm-inside.SLDPRT
80.5 x 17.7 x 12.0 mm
