dpduanpu/OncillaHardware/mechanics/oncilla/Sym-POM-l2_v2-55mm-v3.SLDPRT

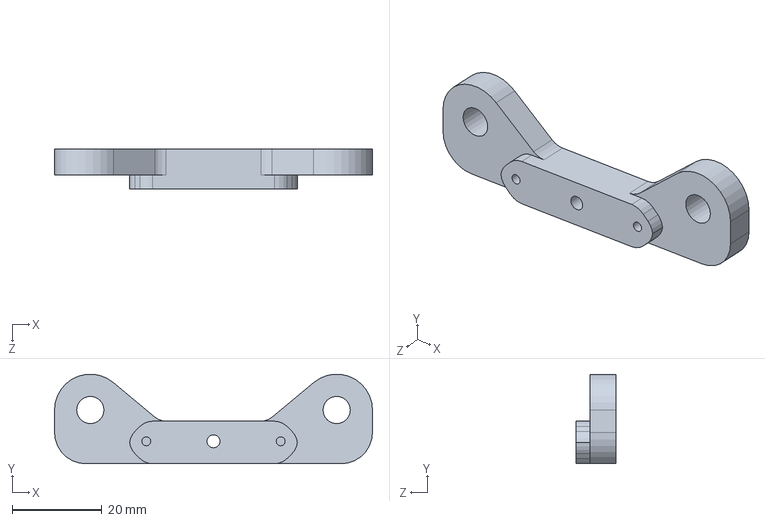
[picture p44: CAD file, 2014-03-28]
mechanics/oncilla/Sym-POM-l2_v2-55mm-v3.SLDPRT
71.0 x 20.0 x 9.00 mm
