dpduanpu/OncillaHardware/mechanics/oncilla/al-back-left.SLDPRT

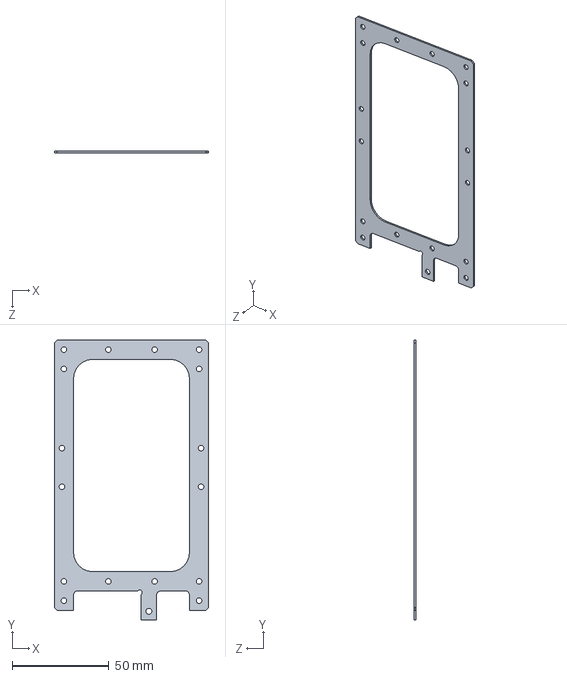
[picture p45: CAD file, 2014-03-28]
mechanics/oncilla/al-back-left.SLDPRT
80.0 x 145.0 x 1.00 mm
