dpduanpu/OncillaHardware/mechanics/oncilla/Mirrorabs-servo-connectors-z-version2-down.SLDPRT

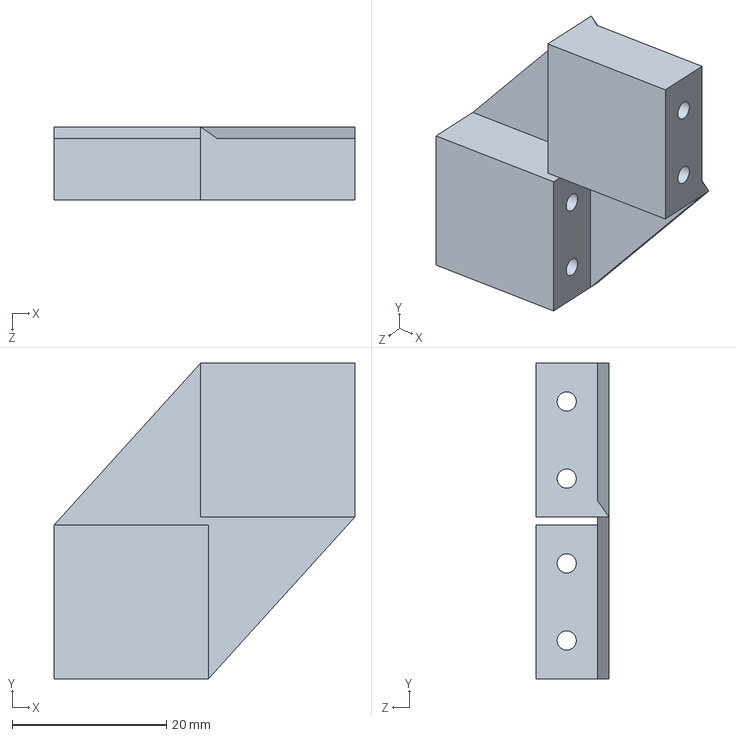
[picture p46: CAD file, 2014-03-28]
mechanics/oncilla/Mirrorabs-servo-connectors-z-version2-down.SLDPRT
39.0 x 41.0 x 9.50 mm
