dpduanpu/OncillaHardware/mechanics/oncilla/Sym-l2-hind-65mm-v4.SLDPRT

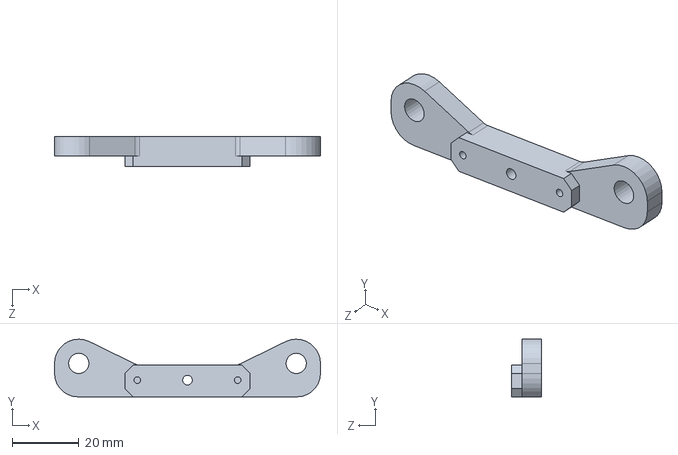
[picture p47: CAD file, 2014-03-28]
mechanics/oncilla/Sym-l2-hind-65mm-v4.SLDPRT
79.5 x 17.2 x 9.00 mm
