dpduanpu/OncillaHardware/mechanics/oncilla/Pom-plat-hip-hind-04-03-13.SLDPRT

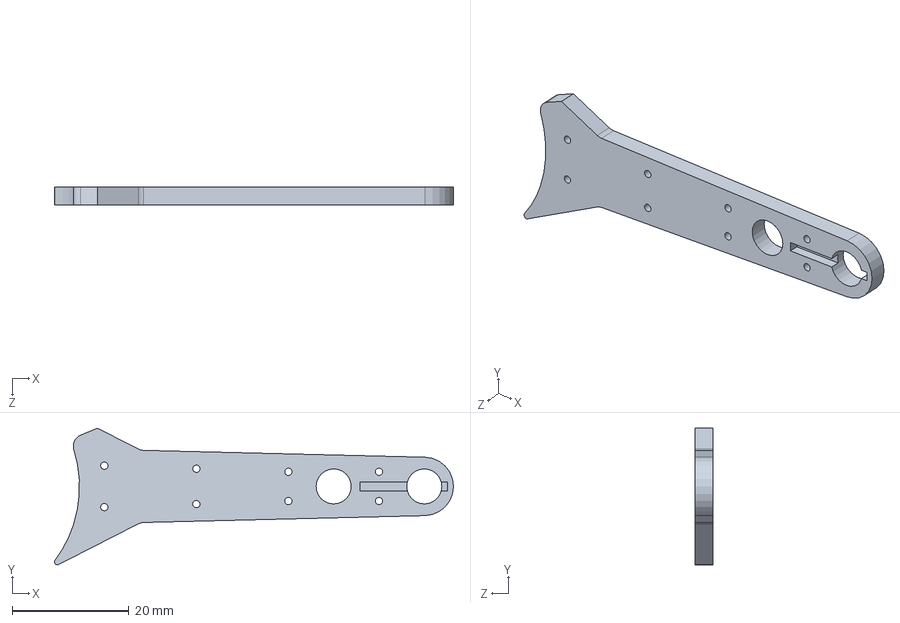
[picture p48: CAD file, 2014-03-28]
mechanics/oncilla/Pom-plat-hip-hind-04-03-13.SLDPRT
68.3 x 23.4 x 3.00 mm
