dpduanpu/OncillaHardware/mechanics/oncilla/NOTMirrorabs_zwing.SLDPRT

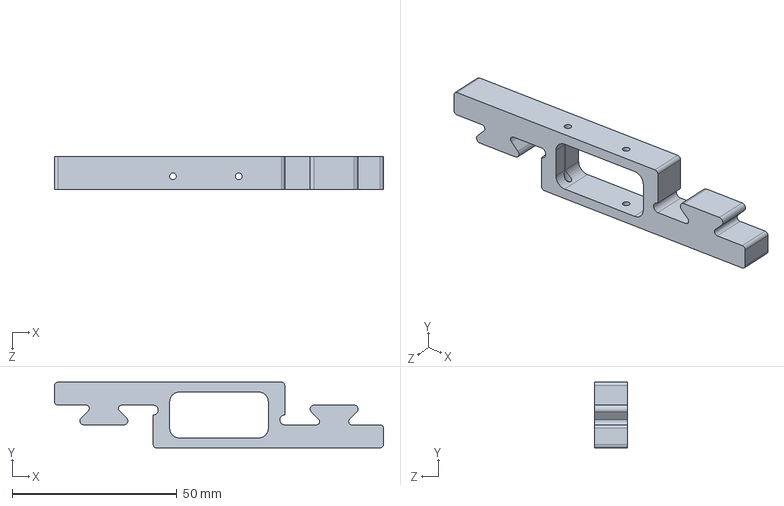
[picture p49: CAD file, 2014-03-28]
mechanics/oncilla/NOTMirrorabs_zwing.SLDPRT
100.0 x 20.0 x 10.0 mm
