dpduanpu/OncillaHardware/mechanics/oncilla/GraCaRB110.SLDPRT

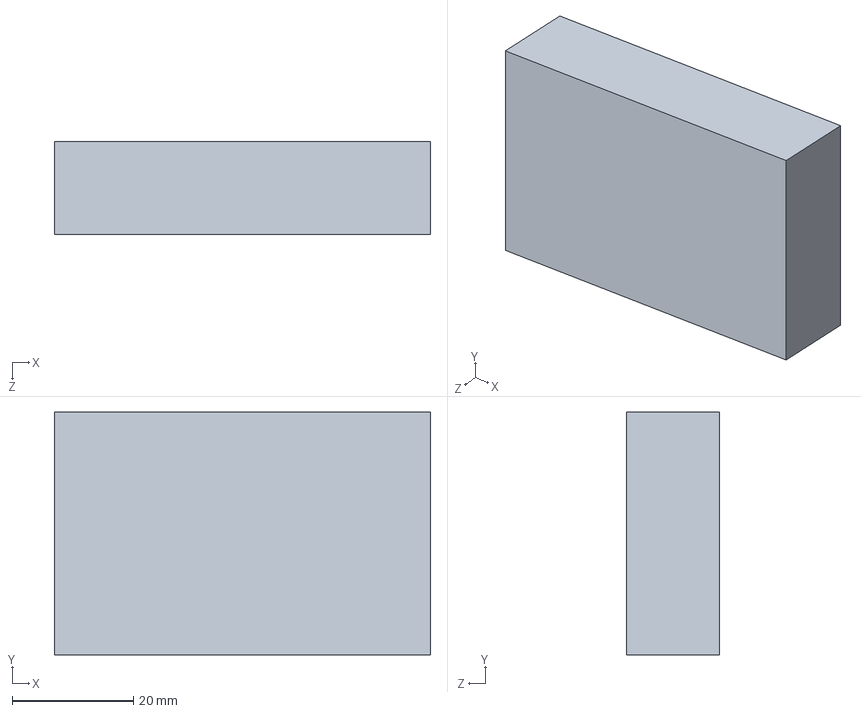
[picture p50: CAD file, 2014-03-28]
mechanics/oncilla/GraCaRB110.SLDPRT
62.0 x 40.1 x 15.4 mm
