dpduanpu/OncillaHardware/mechanics/oncilla/POM-support-PCB.SLDPRT

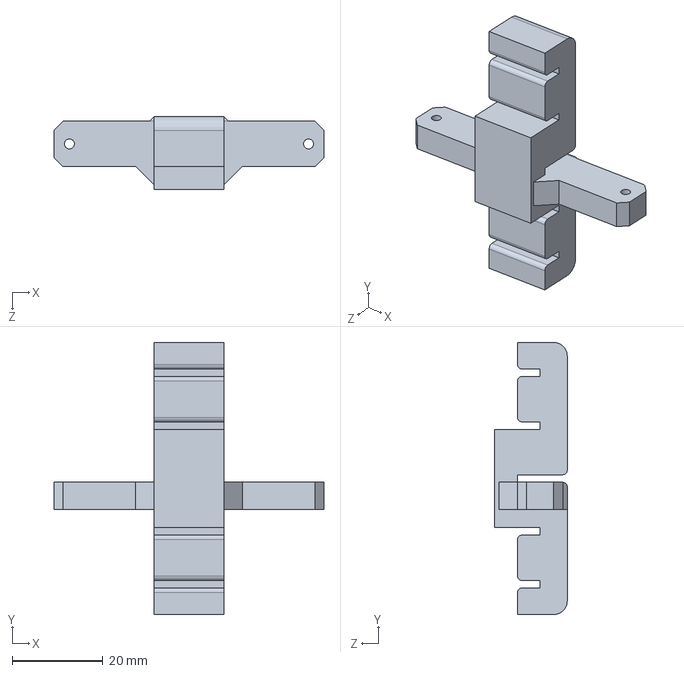
[picture p51: CAD file, 2014-03-28]
mechanics/oncilla/POM-support-PCB.SLDPRT
59.5 x 60.0 x 16.0 mm
