dpduanpu/OncillaHardware/mechanics/oncilla/abs-hip-front-2012-11-20.SLDPRT

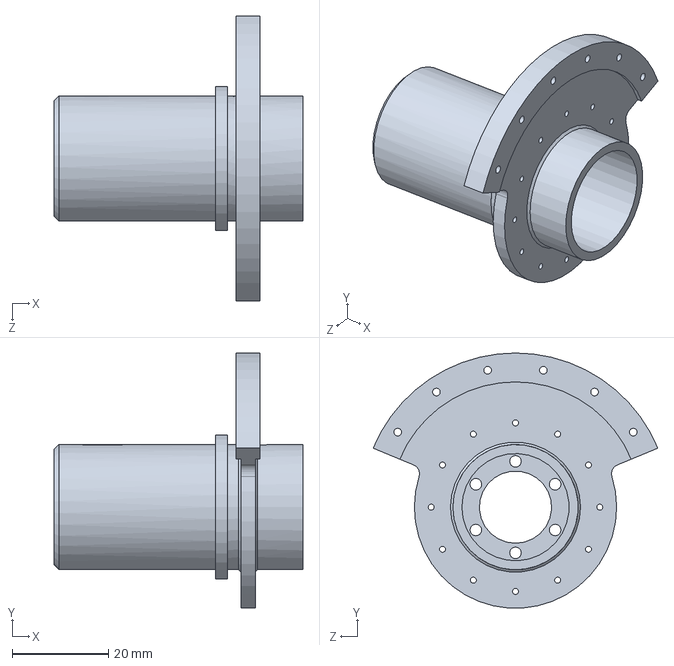
[picture p52: CAD file, 2014-03-28]
mechanics/oncilla/abs-hip-front-2012-11-20.SLDPRT
51.7 x 52.9 x 59.1 mm
