dpduanpu/OncillaHardware/mechanics/oncilla/battery_Kokam-LiPoly1800mAh(30c)Pack3s_11,1V.SLDPRT

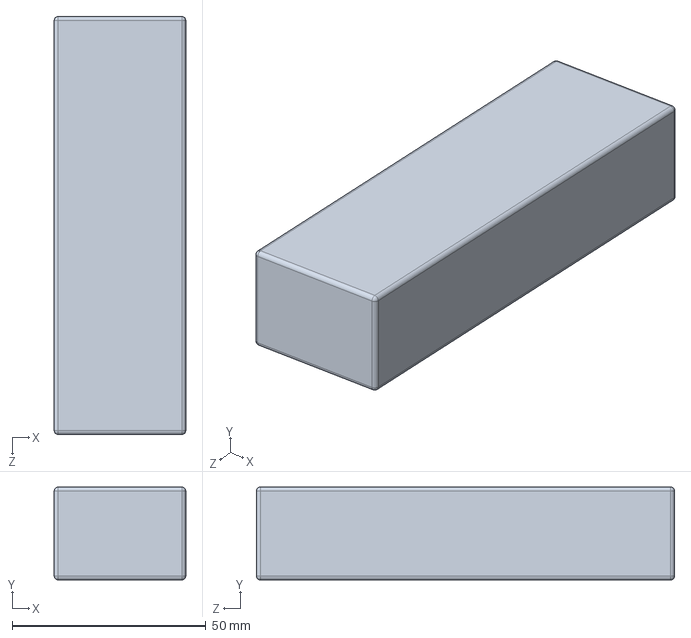
[picture p53: CAD file, 2014-03-28]
mechanics/oncilla/battery_Kokam-LiPoly1800mAh(30c)Pack3s_11,1V.SLDPRT
34.0 x 24.0 x 108.0 mm
