dpduanpu/OncillaHardware/mechanics/oncilla/RingGearN30.SLDPRT

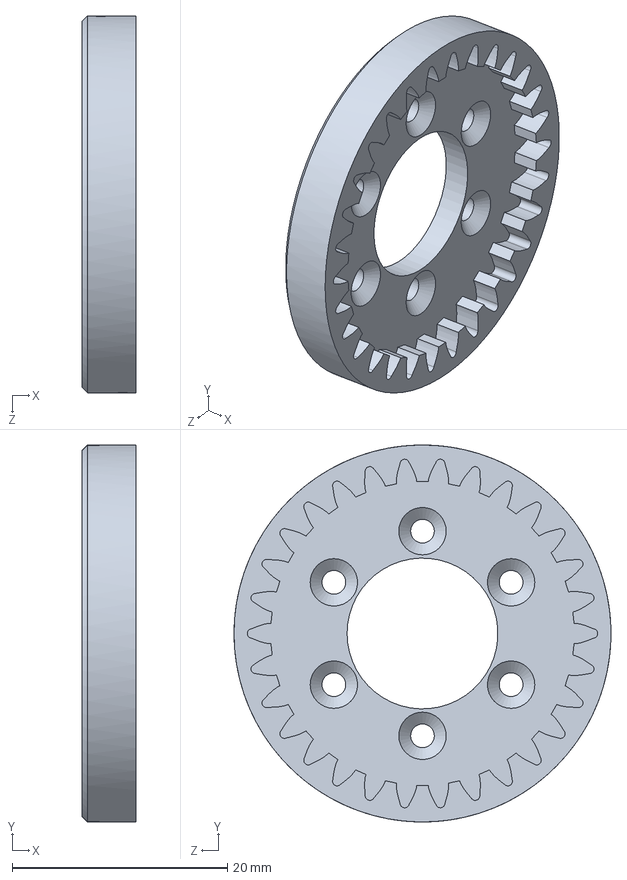
[picture p54: CAD file, 2014-03-28]
mechanics/oncilla/RingGearN30.SLDPRT
5.00 x 35.0 x 35.0 mm
