dpduanpu/OncillaHardware/mechanics/oncilla/ABS-l2_v2-55mm-v2.SLDPRT

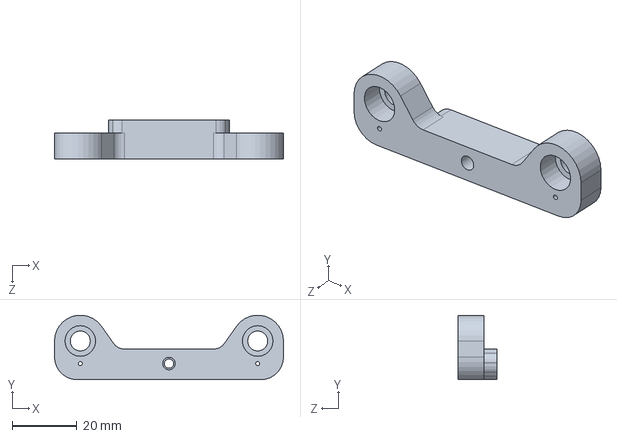
[picture p55: CAD file, 2014-03-28]
mechanics/oncilla/ABS-l2_v2-55mm-v2.SLDPRT
71.0 x 20.0 x 12.0 mm
