dpduanpu/OncillaHardware/mechanics/oncilla/Part1-knee-mod3-hind.SLDPRT

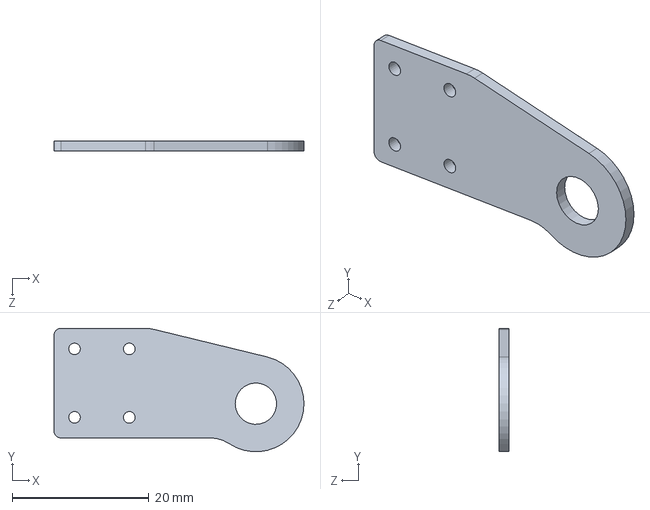
[picture p56: CAD file, 2014-03-23]
mechanics/oncilla/Part1-knee-mod3-hind.SLDPRT
36.5 x 18.0 x 1.50 mm
