dpduanpu/OncillaHardware/mechanics/oncilla/holder-ServoHorn-03052012-abs.SLDPRT

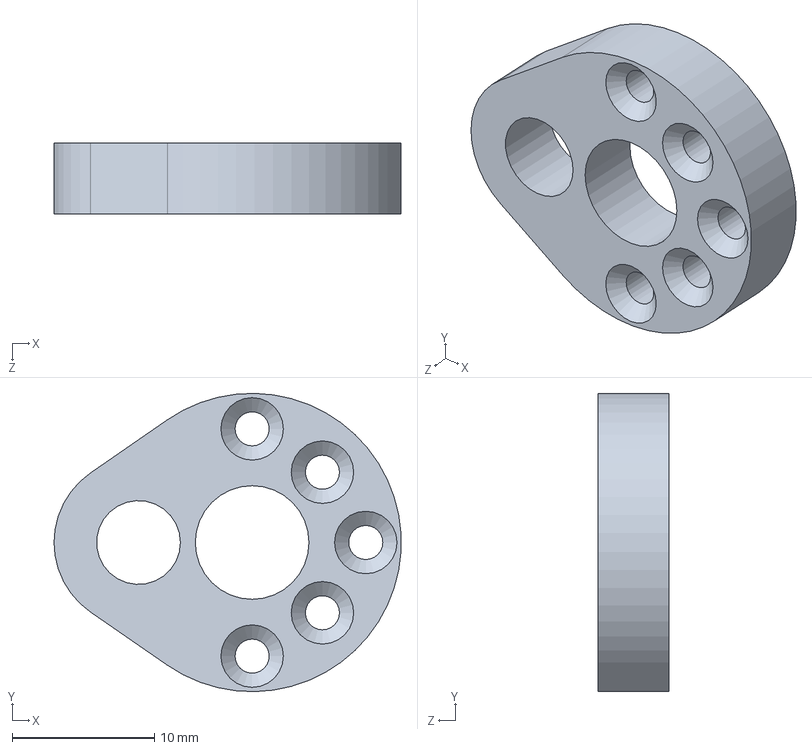
[picture p57: CAD file, 2014-03-23]
mechanics/oncilla/holder-ServoHorn-03052012-abs.SLDPRT
24.4 x 21.0 x 5.00 mm
