dpduanpu/OncillaHardware/mechanics/oncilla/part2-knee-mod1.SLDPRT

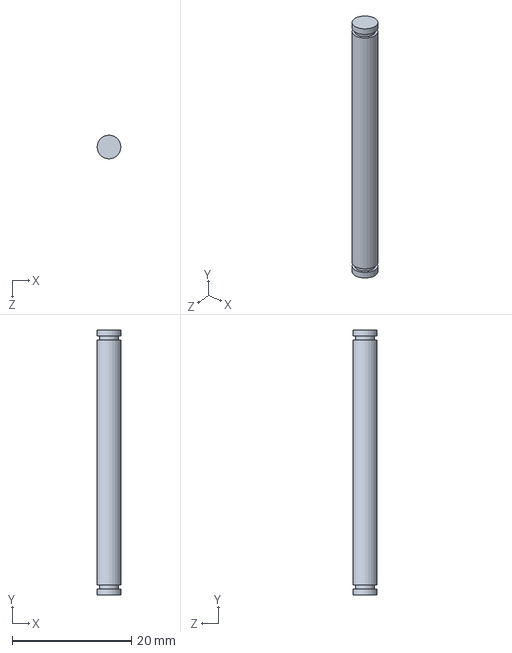
[picture p58: CAD file, 2014-03-23]
mechanics/oncilla/part2-knee-mod1.SLDPRT
4.00 x 44.5 x 4.00 mm
