dpduanpu/OncillaHardware/mechanics/oncilla/Hip_gear.SLDPRT

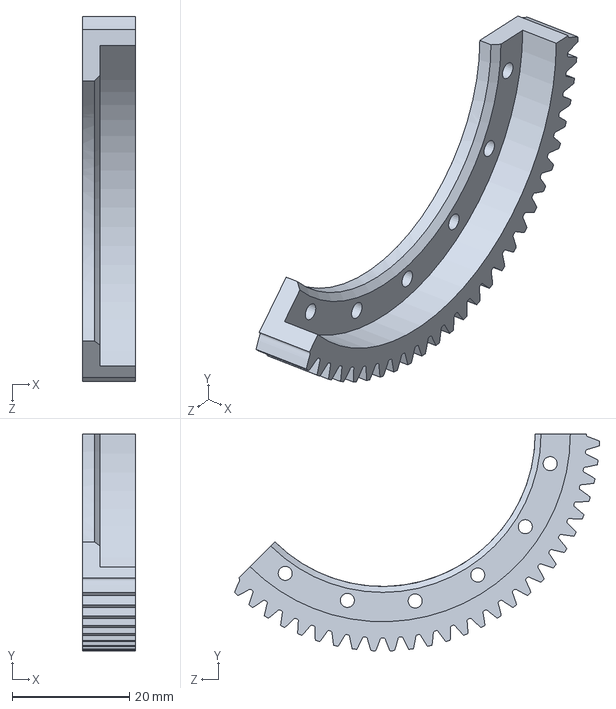
[picture p59: CAD file, 2014-03-23]
mechanics/oncilla/Hip_gear.SLDPRT
9.00 x 37.0 x 62.3 mm
