dpduanpu/OncillaHardware/mechanics/oncilla/carbon-plate-hip-hind.SLDPRT

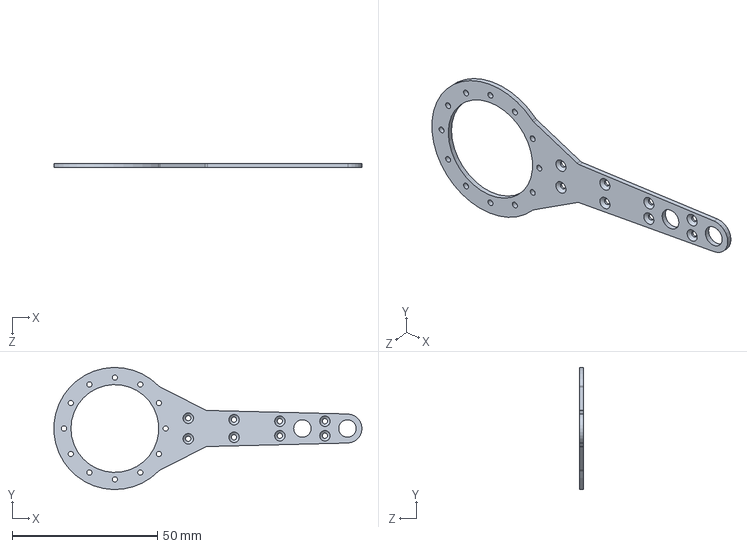
[picture p60: CAD file, 2014-03-23]
mechanics/oncilla/carbon-plate-hip-hind.SLDPRT
105.9 x 42.0 x 1.50 mm
