dpduanpu/OncillaHardware/mechanics/oncilla/al_d6_1.SLDPRT

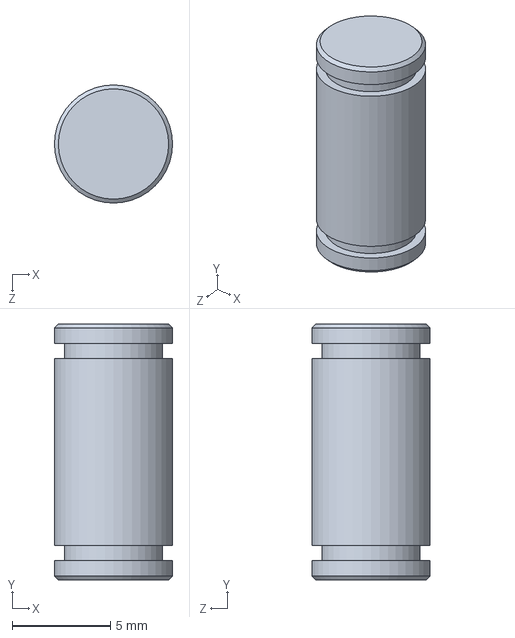
[picture p61: CAD file, 2014-03-23]
mechanics/oncilla/al_d6_1.SLDPRT
6.00 x 13.0 x 6.00 mm
