dpduanpu/OncillaHardware/mechanics/oncilla/carbon-plat-hip-front.SLDPRT

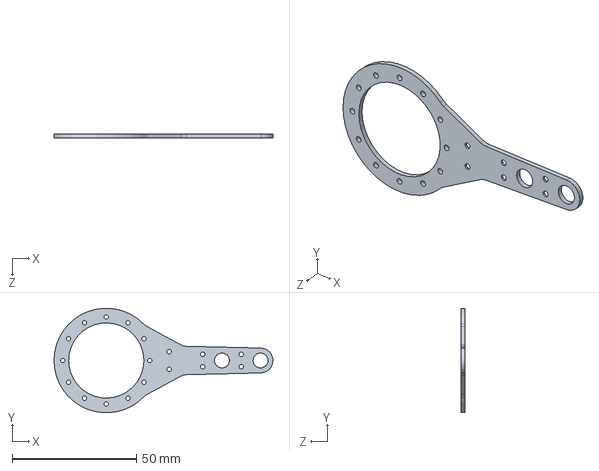
[picture p62: CAD file, 2014-03-23]
mechanics/oncilla/carbon-plat-hip-front.SLDPRT
88.0 x 41.9 x 1.50 mm
