dpduanpu/OncillaHardware/mechanics/oncilla/d5l35.SLDPRT

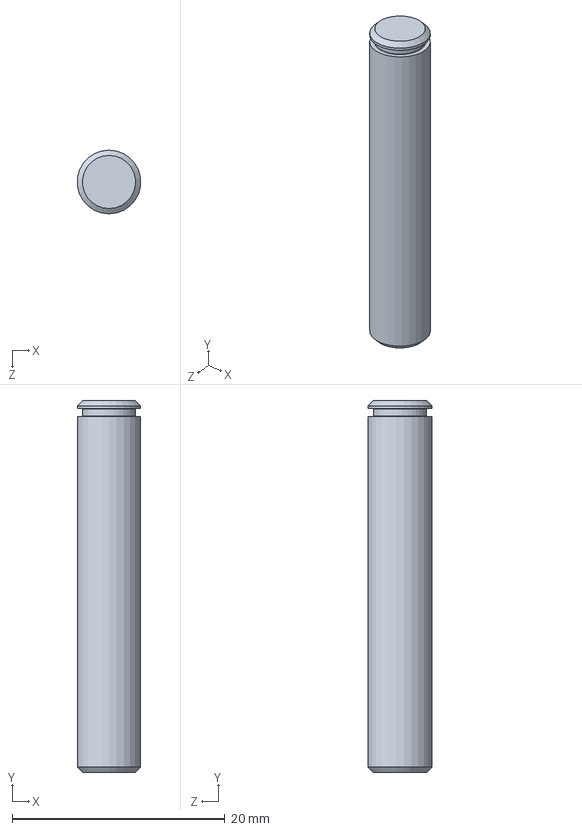
[picture p63: CAD file, 2014-03-23]
mechanics/oncilla/d5l35.SLDPRT
5.96 x 35.0 x 6.00 mm
