dpduanpu/OncillaHardware/mechanics/oncilla/Spring_RDF-1799.SLDPRT

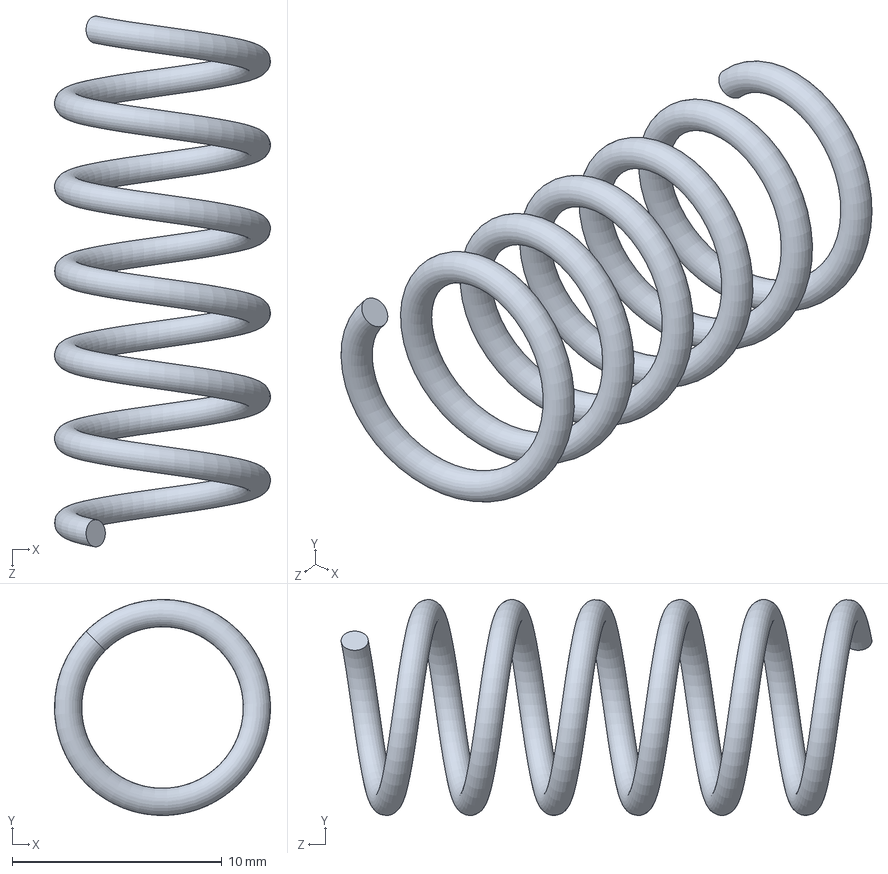
[picture p64: CAD file, 2014-03-23]
mechanics/oncilla/Spring_RDF-1799.SLDPRT
10.3 x 10.3 x 25.3 mm
