dpduanpu/OncillaHardware/mechanics/oncilla/DistancePieceM2p5D5L5mm.SLDPRT

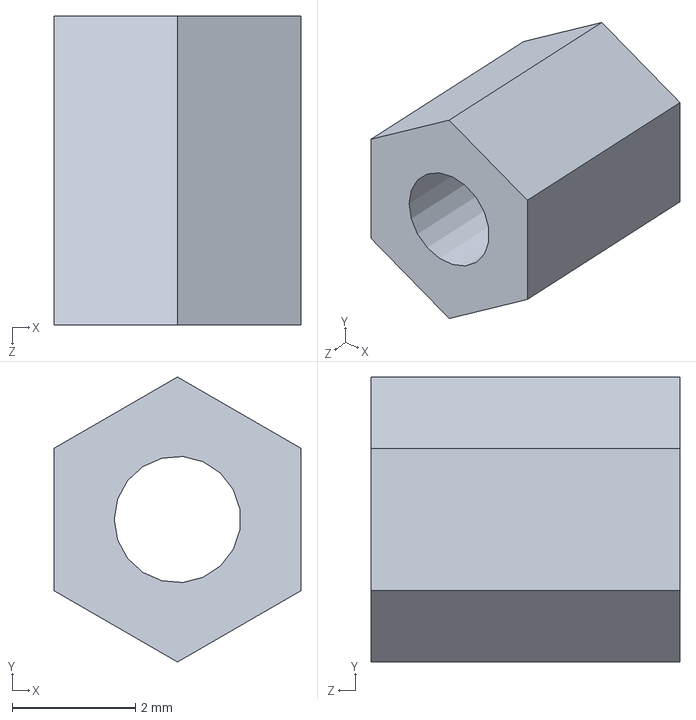
[picture p65: CAD file, 2014-03-23]
mechanics/oncilla/DistancePieceM2p5D5L5mm.SLDPRT
4.00 x 4.62 x 5.00 mm
