dpduanpu/OncillaHardware/mechanics/oncilla/Spring_DF-1670.SLDPRT

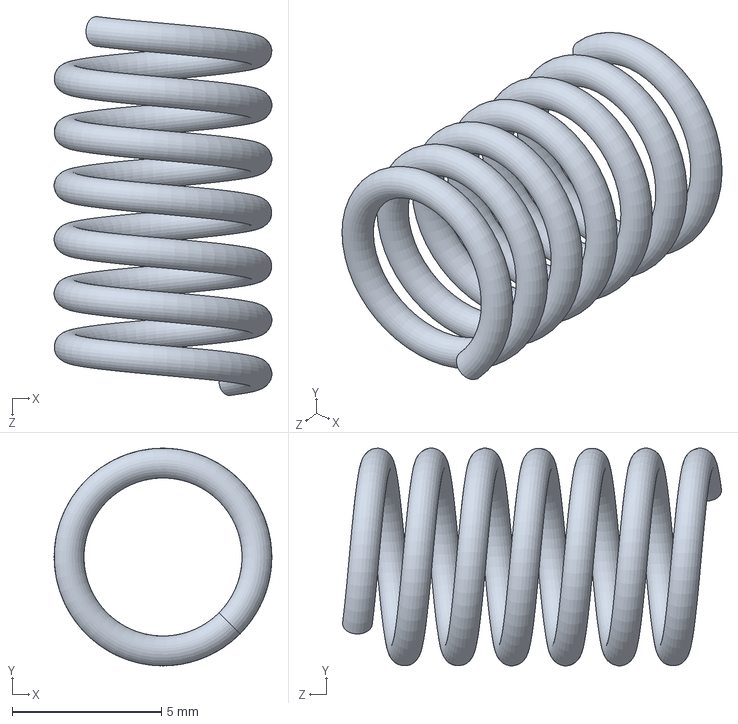
[picture p66: CAD file, 2014-03-23]
mechanics/oncilla/Spring_DF-1670.SLDPRT
7.29 x 7.29 x 12.7 mm
