dpduanpu/OncillaHardware/mechanics/oncilla/handle6_withBattery.SLDPRT

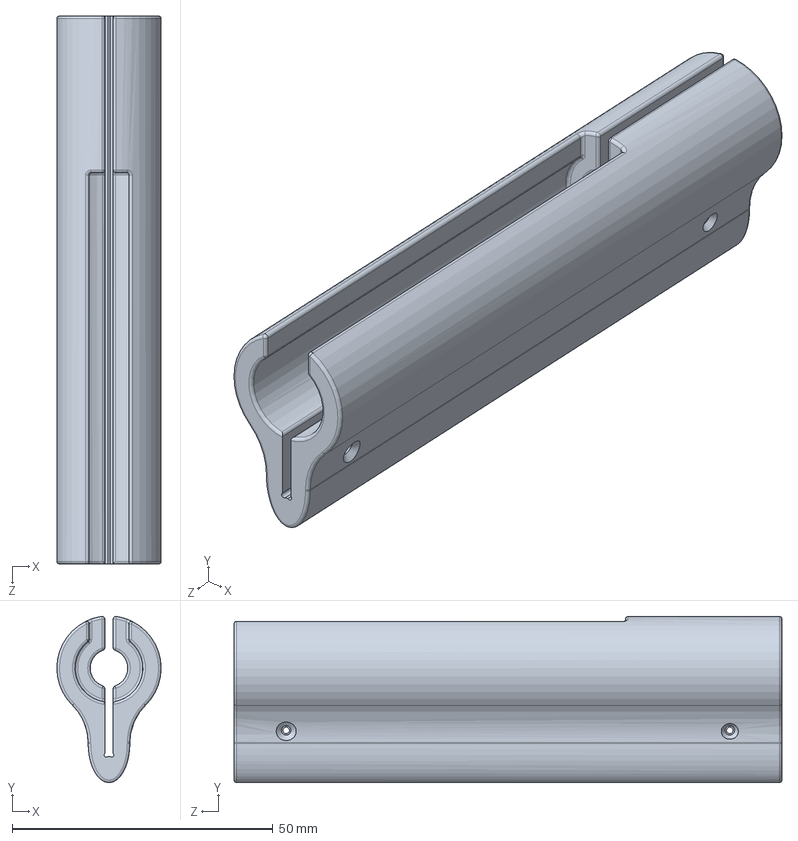
[picture p67: CAD file, 2014-03-23]
mechanics/oncilla/handle6_withBattery.SLDPRT
20.0 x 31.8 x 105.0 mm
