dpduanpu/OncillaHardware/mechanics/oncilla/carbon-thin-stripes-2012-05-09.SLDPRT

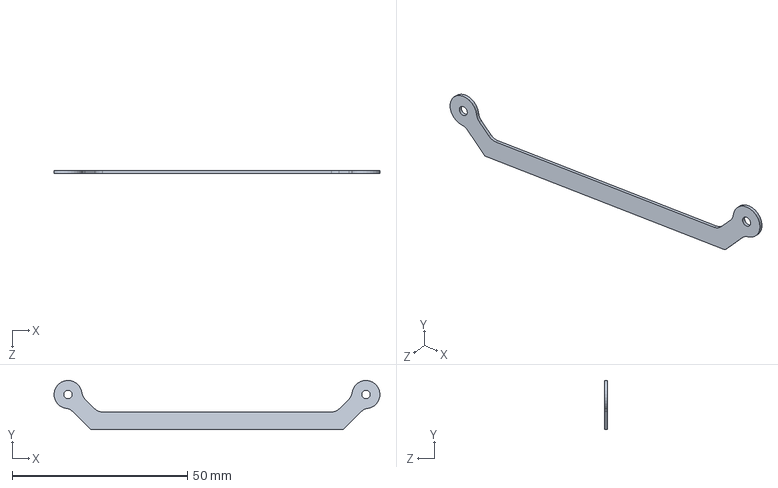
[picture p68: CAD file, 2014-03-23]
mechanics/oncilla/carbon-thin-stripes-2012-05-09.SLDPRT
93.0 x 14.0 x 0.8 mm
