dpduanpu/OncillaHardware/mechanics/oncilla/abs-pcb-holder-top-2012-11-16.SLDPRT

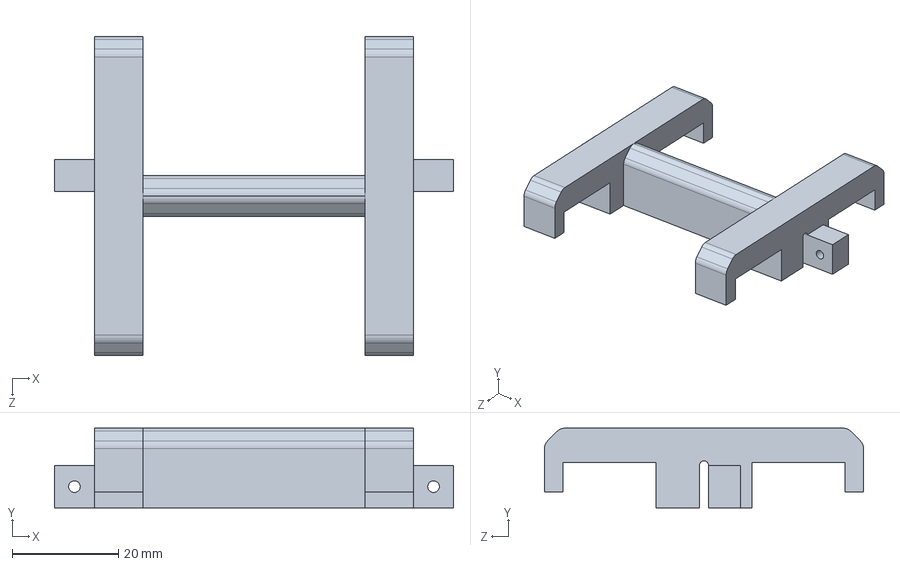
[picture p69: CAD file, 2014-03-23]
mechanics/oncilla/abs-pcb-holder-top-2012-11-16.SLDPRT
75.0 x 15.0 x 60.0 mm
