dpduanpu/OncillaHardware/mechanics/oncilla/d3-l20.SLDPRT

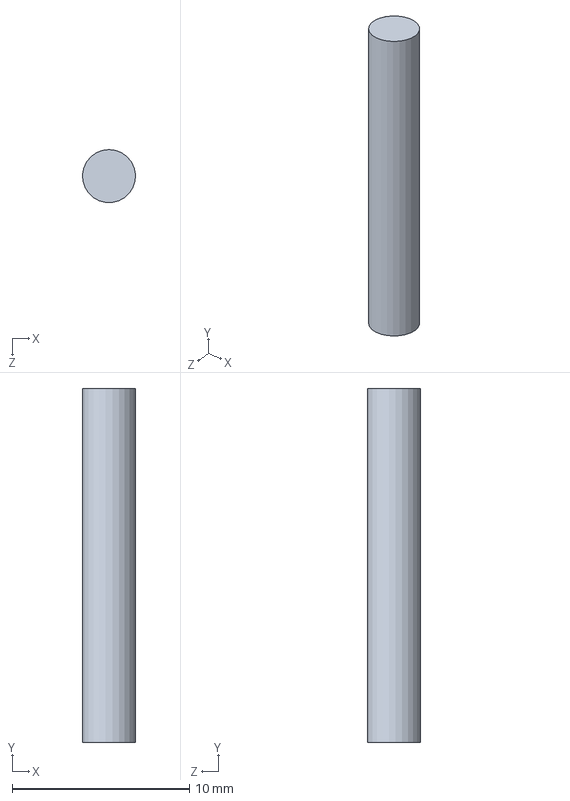
[picture p70: CAD file, 2014-03-23]
mechanics/oncilla/d3-l20.SLDPRT
2.99 x 20.0 x 2.99 mm
