dpduanpu/OncillaHardware/mechanics/oncilla/Part2-knee-mod3-hind.SLDPRT

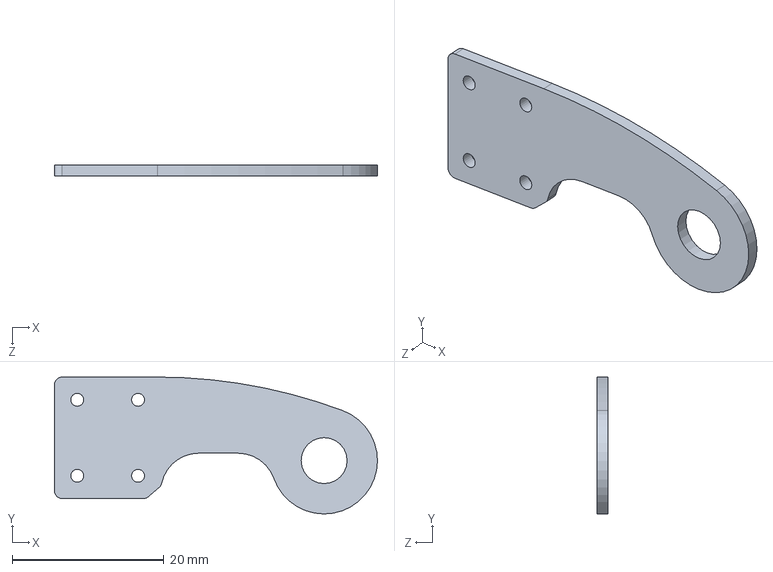
[picture p71: CAD file, 2014-03-23]
mechanics/oncilla/Part2-knee-mod3-hind.SLDPRT
42.5 x 18.0 x 1.50 mm
