dpduanpu/OncillaHardware/mechanics/oncilla/l3-sandwich.SLDPRT

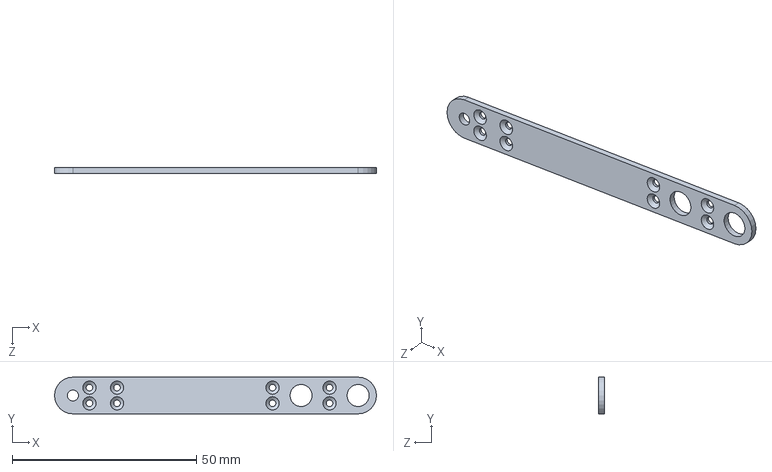
[picture p72: CAD file, 2014-03-23]
mechanics/oncilla/l3-sandwich.SLDPRT
87.5 x 10.0 x 1.50 mm
