dpduanpu/OncillaHardware/mechanics/oncilla/l3-sandwich_pom.SLDPRT

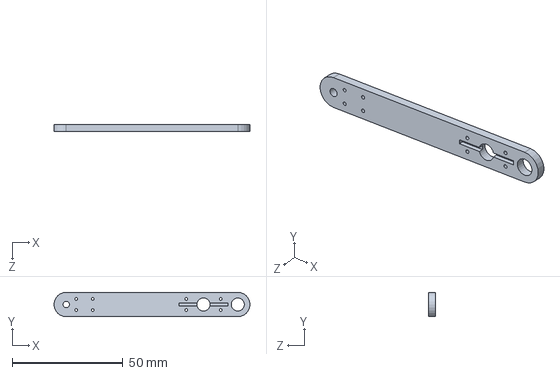
[picture p73: CAD file, 2014-03-23]
mechanics/oncilla/l3-sandwich_pom.SLDPRT
88.5 x 11.0 x 3.00 mm
