dpduanpu/OncillaHardware/mechanics/oncilla/POM-cube-l2-upper.SLDPRT

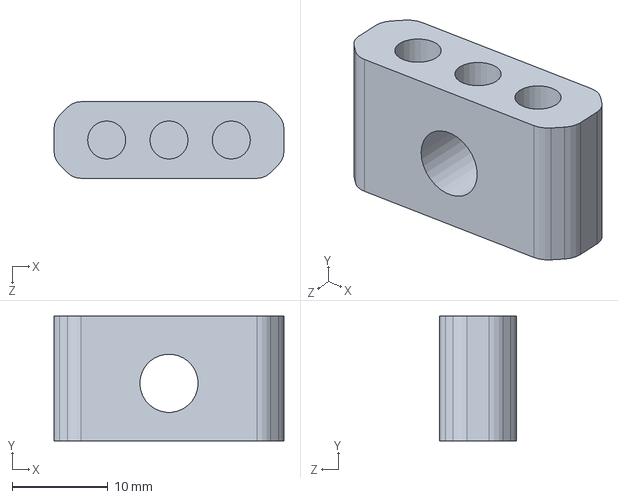
[picture p74: CAD file, 2014-03-23]
mechanics/oncilla/POM-cube-l2-upper.SLDPRT
24.0 x 13.0 x 8.00 mm
