dpduanpu/OncillaHardware/mechanics/oncilla/LidPlanetGB.SLDPRT

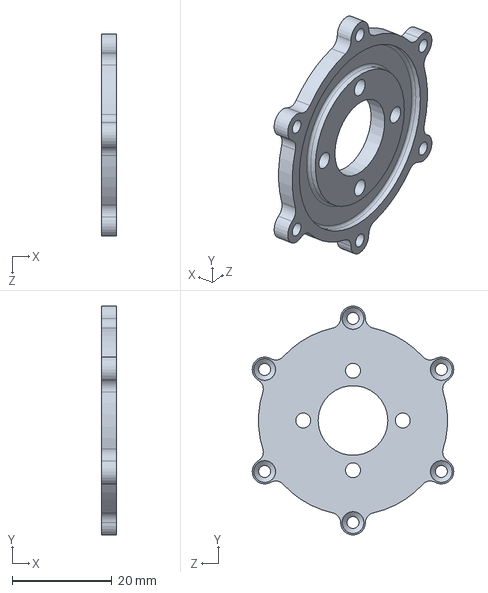
[picture p75: CAD file, 2014-03-23]
mechanics/oncilla/LidPlanetGB.SLDPRT
3.00 x 46.0 x 40.5 mm
