dpduanpu/OncillaHardware/mechanics/oncilla/motordriver_v3.SLDPRT

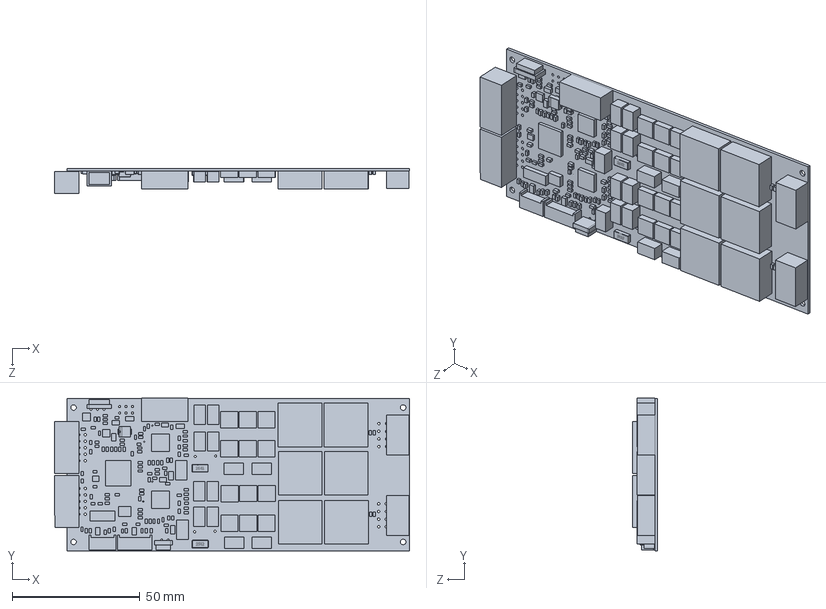
[picture p76: CAD file, 2014-03-23]
mechanics/oncilla/motordriver_v3.SLDPRT
139.2 x 59.9 x 9.92 mm
