dpduanpu/OncillaHardware/mechanics/oncilla/l3-sandwich-POM-hind.SLDPRT

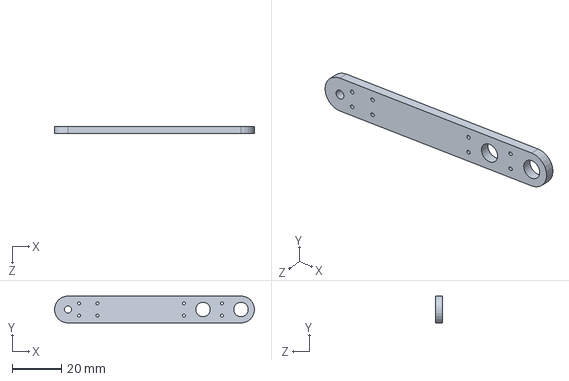
[picture p77: CAD file, 2014-03-23]
mechanics/oncilla/l3-sandwich-POM-hind.SLDPRT
81.5 x 11.0 x 3.00 mm
