dpduanpu/OncillaHardware/mechanics/oncilla/d5-d6-alu-b2p5-b5.SLDPRT

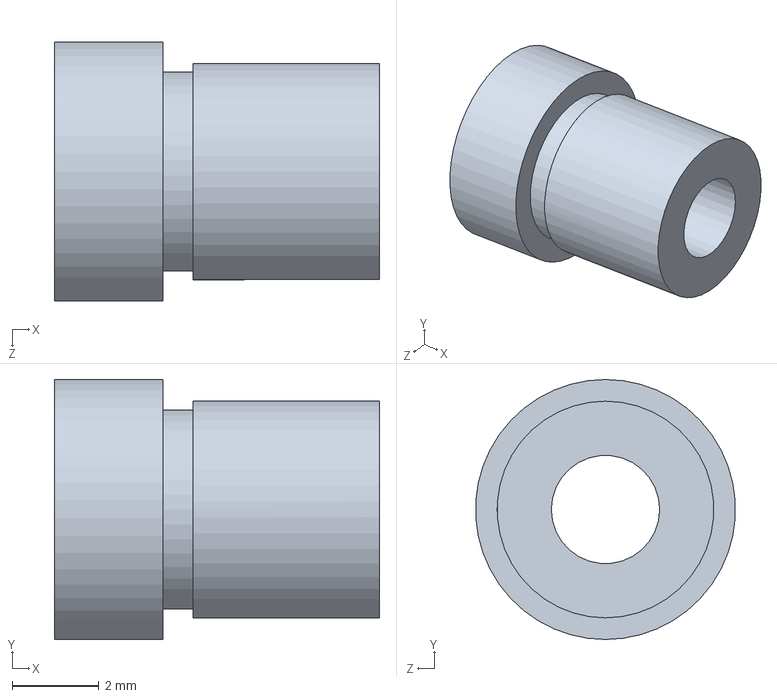
[picture p78: CAD file, 2014-03-23]
mechanics/oncilla/d5-d6-alu-b2p5-b5.SLDPRT
7.50 x 6.00 x 5.99 mm
