dpduanpu/OncillaHardware/mechanics/oncilla/al-slider-short-front.SLDPRT

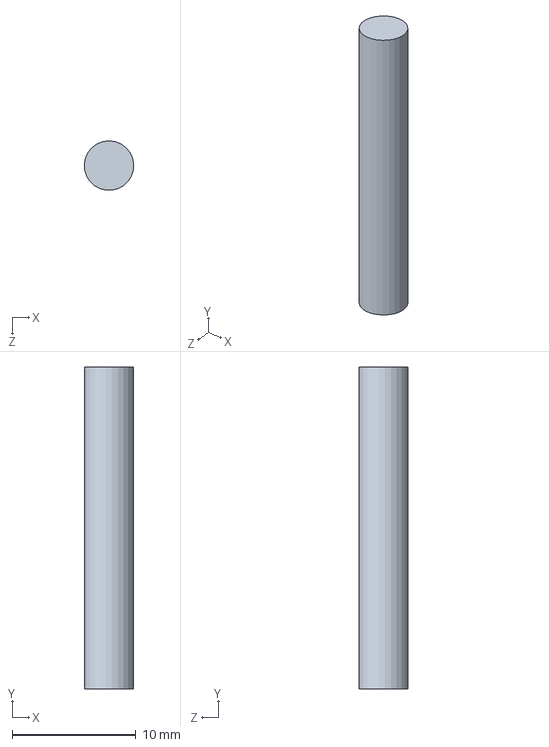
[picture p79: CAD file, 2014-03-23]
mechanics/oncilla/al-slider-short-front.SLDPRT
3.99 x 26.0 x 3.98 mm
