dpduanpu/OncillaHardware/mechanics/oncilla/N12_M1.05.SLDPRT

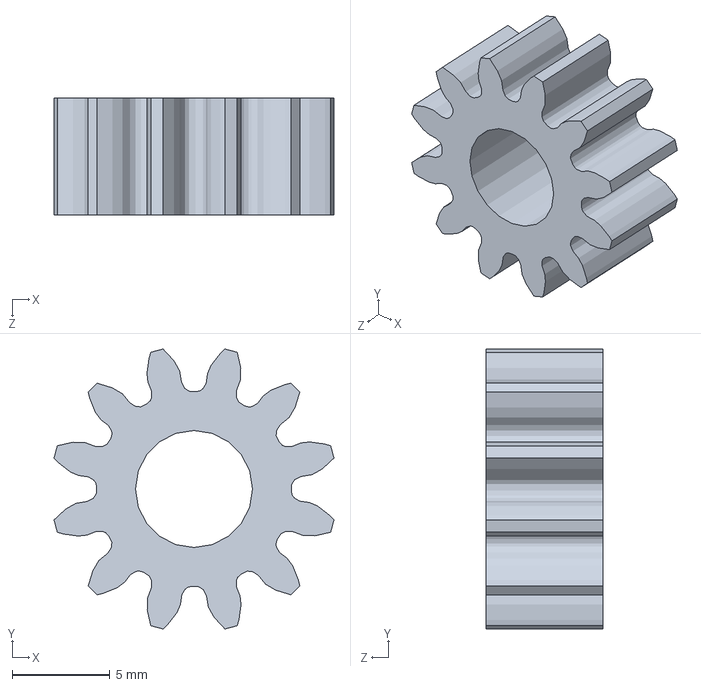
[picture p80: CAD file, 2014-03-23]
mechanics/oncilla/N12_M1.05.SLDPRT
14.4 x 14.4 x 6.00 mm
