dpduanpu/OncillaHardware/mechanics/oncilla/POM-cube-l2-lower.SLDPRT

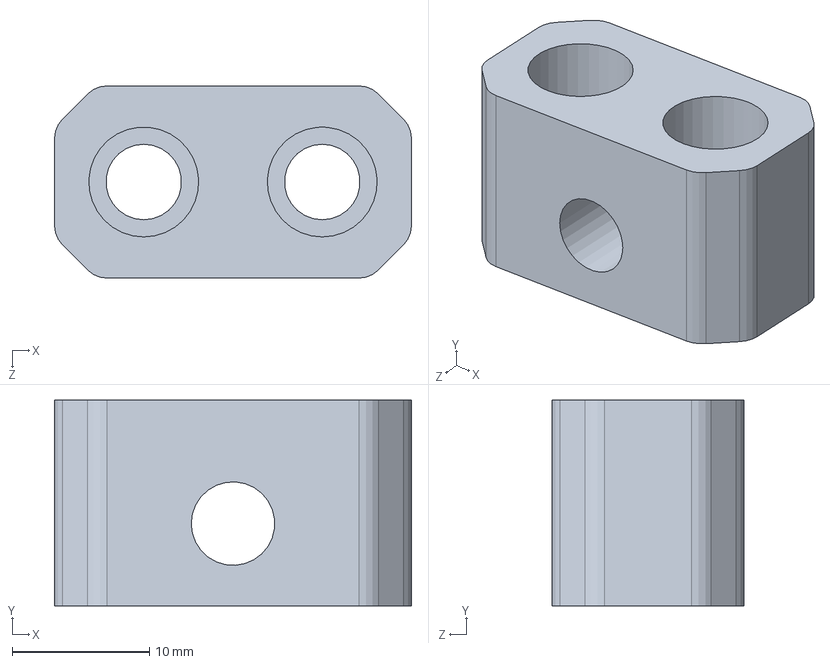
[picture p81: CAD file, 2014-03-23]
mechanics/oncilla/POM-cube-l2-lower.SLDPRT
26.0 x 15.0 x 14.0 mm
