dpduanpu/OncillaHardware/mechanics/oncilla/60s.SLDPRT

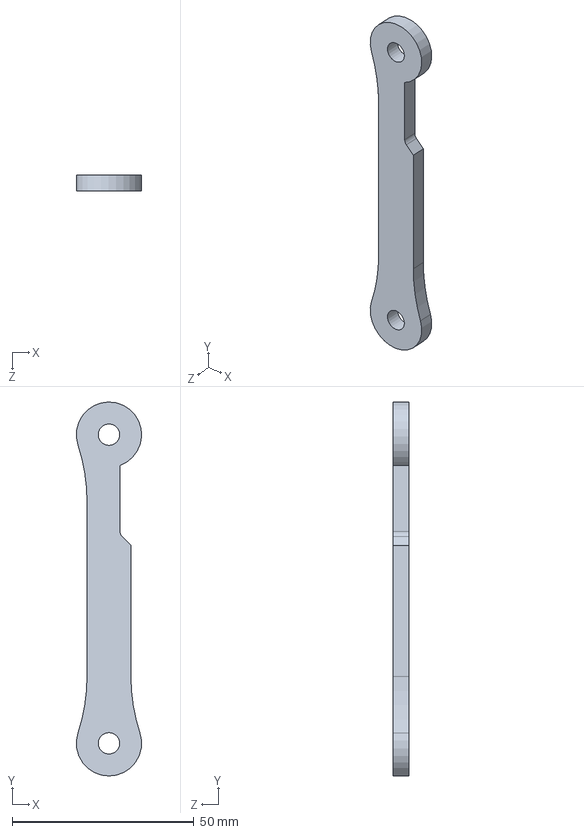
[picture p82: CAD file, 2014-03-23]
mechanics/oncilla/60s.SLDPRT
18.0 x 103.0 x 4.50 mm
