dpduanpu/OncillaHardware/mechanics/oncilla/Pom1_d8-l44.SLDPRT

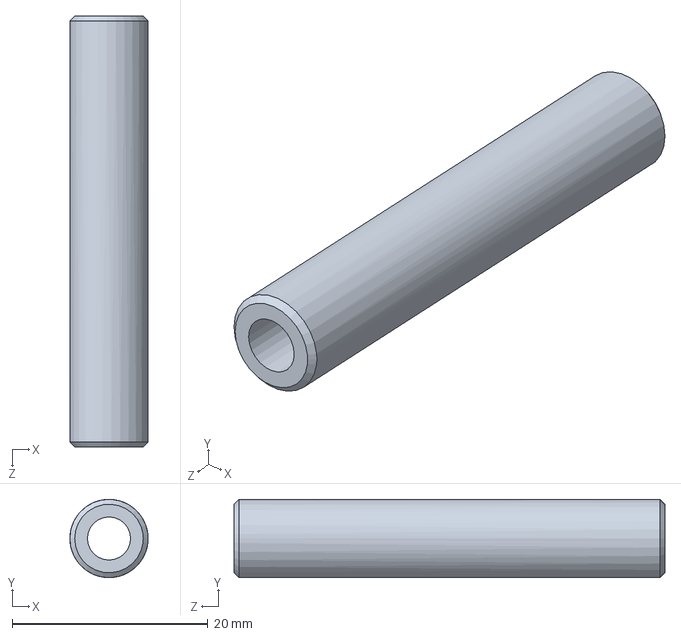
[picture p83: CAD file, 2014-03-23]
mechanics/oncilla/Pom1_d8-l44.SLDPRT
8.00 x 7.99 x 44.0 mm
