dpduanpu/OncillaHardware/mechanics/oncilla/m3-shorthead.SLDPRT

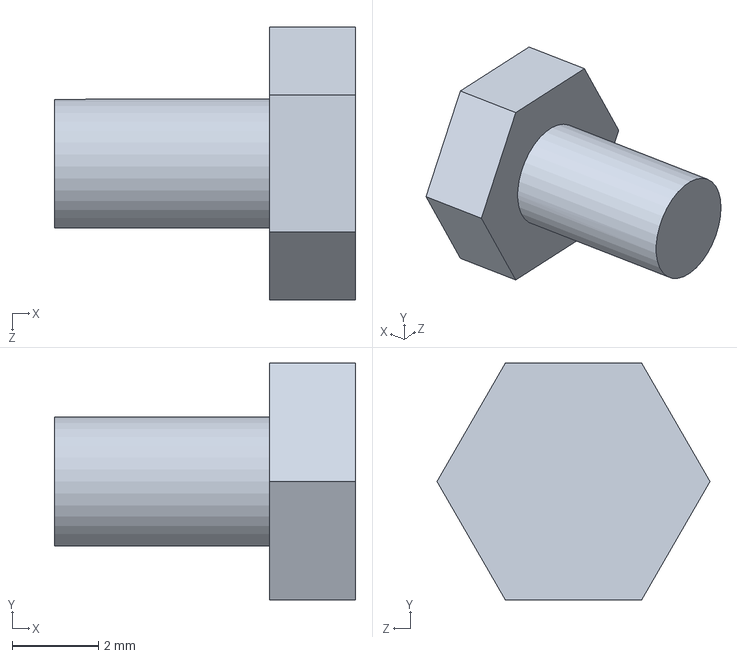
[picture p84: CAD file, 2014-03-23]
mechanics/oncilla/m3-shorthead.SLDPRT
7.00 x 5.50 x 6.35 mm
