dpduanpu/OncillaHardware/mechanics/oncilla/pin-d6-l24.SLDPRT

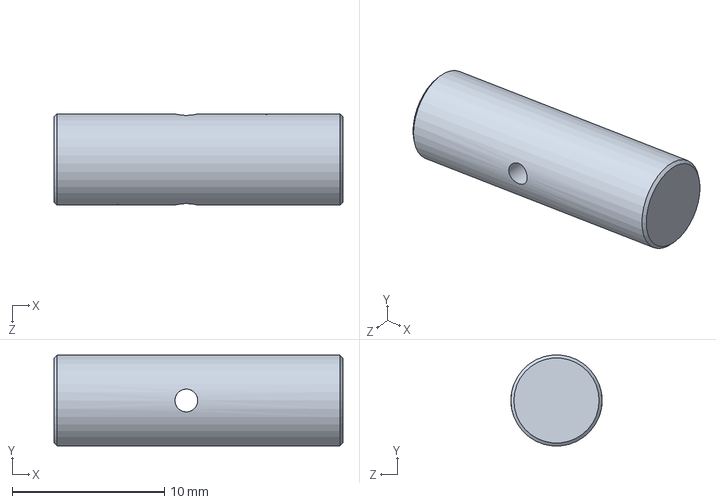
[picture p85: CAD file, 2014-03-23]
mechanics/oncilla/pin-d6-l24.SLDPRT
19.0 x 5.97 x 6.00 mm
