dpduanpu/OncillaHardware/mechanics/oncilla/POM-D8-L34.SLDPRT

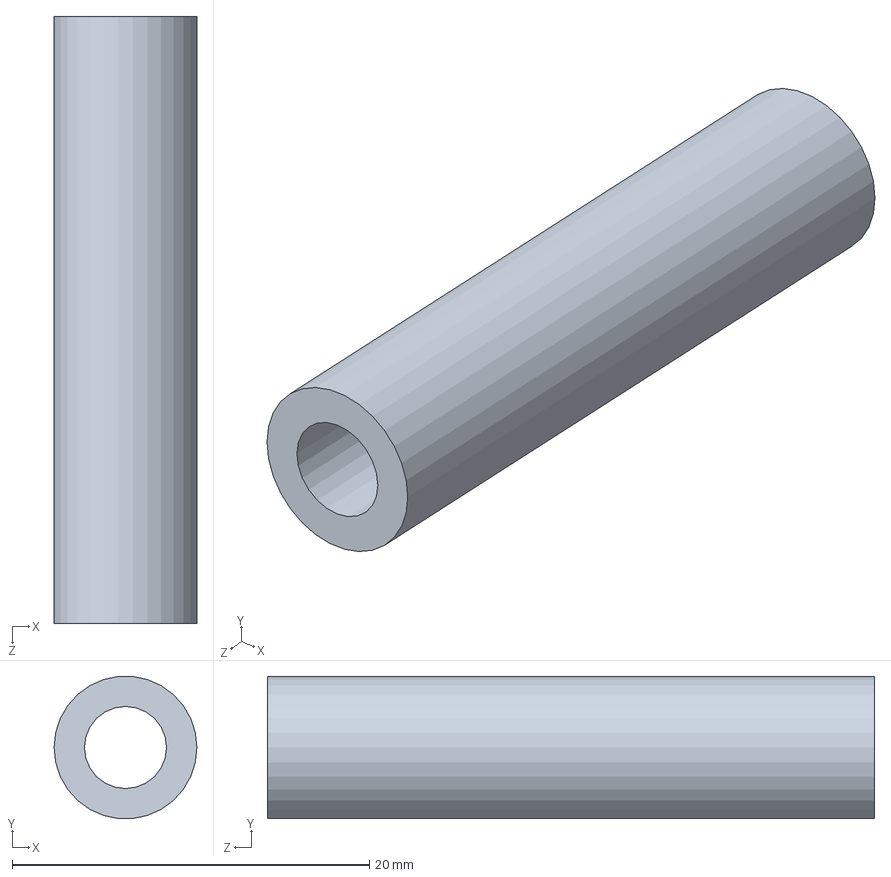
[picture p86: CAD file, 2014-03-23]
mechanics/oncilla/POM-D8-L34.SLDPRT
8.00 x 7.96 x 34.0 mm
