dpduanpu/OncillaHardware/mechanics/oncilla/load-cell-alu-y-force-beam.SLDPRT

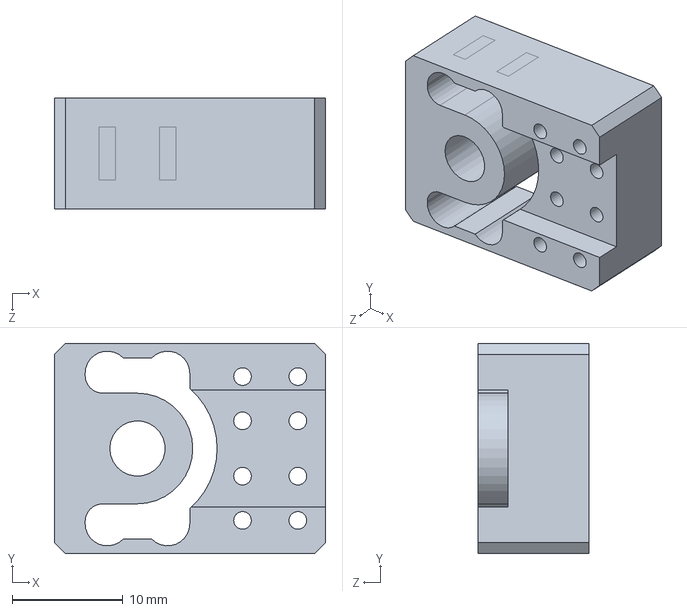
[picture p87: CAD file, 2014-03-23]
mechanics/oncilla/load-cell-alu-y-force-beam.SLDPRT
24.5 x 19.0 x 10.0 mm
