dpduanpu/OncillaHardware/mechanics/oncilla/Part2-knee-mod3-front.SLDPRT

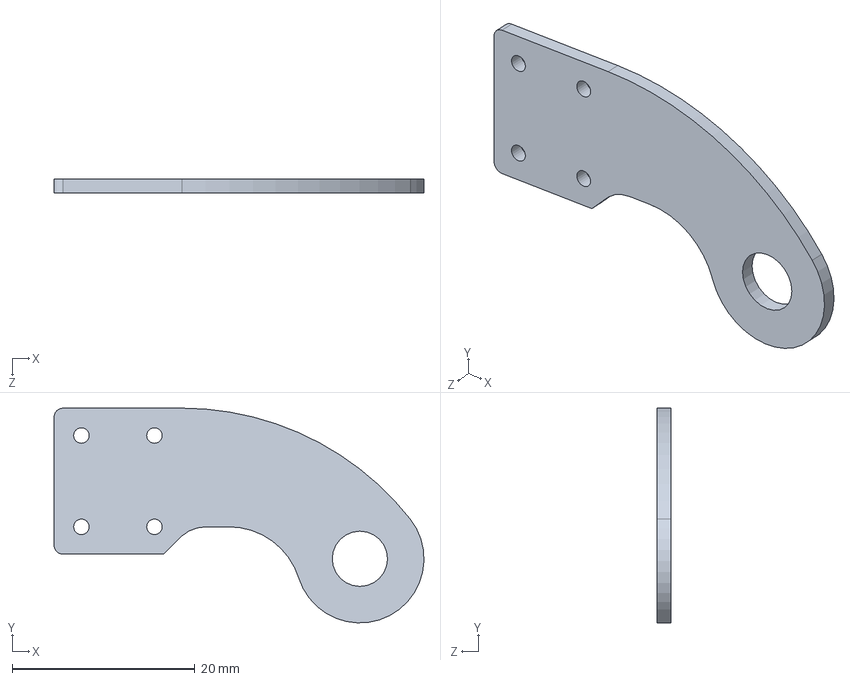
[picture p88: CAD file, 2014-03-23]
mechanics/oncilla/Part2-knee-mod3-front.SLDPRT
40.5 x 23.5 x 1.50 mm
