dpduanpu/OncillaHardware/mechanics/oncilla/AL-D4-L50-Hind.SLDPRT

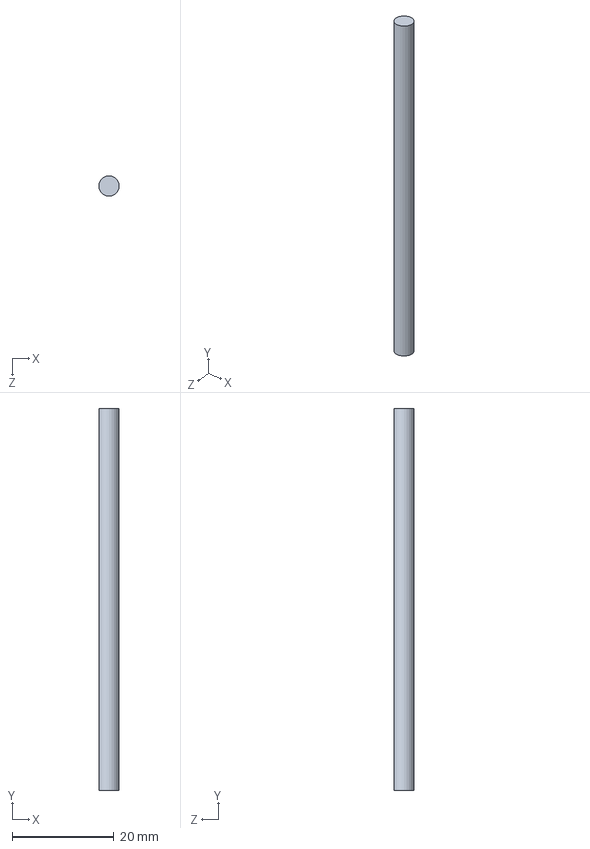
[picture p89: CAD file, 2014-03-23]
mechanics/oncilla/AL-D4-L50-Hind.SLDPRT
4.00 x 75.0 x 4.00 mm
