dpduanpu/OncillaHardware/mechanics/oncilla/madenschraubeM4.SLDPRT

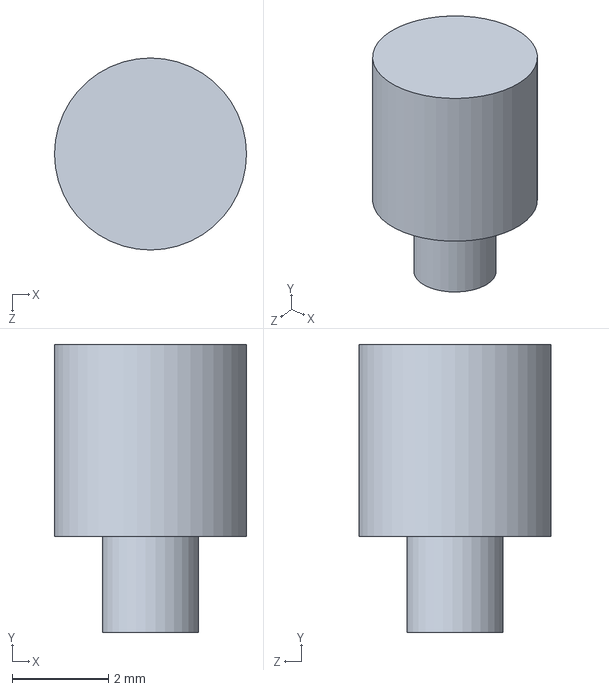
[picture p90: CAD file, 2014-03-23]
mechanics/oncilla/madenschraubeM4.SLDPRT
4.00 x 6.00 x 4.00 mm
