dpduanpu/OncillaHardware/mechanics/oncilla/transmission-planetshell-4march2013-abs-print.SLDPRT

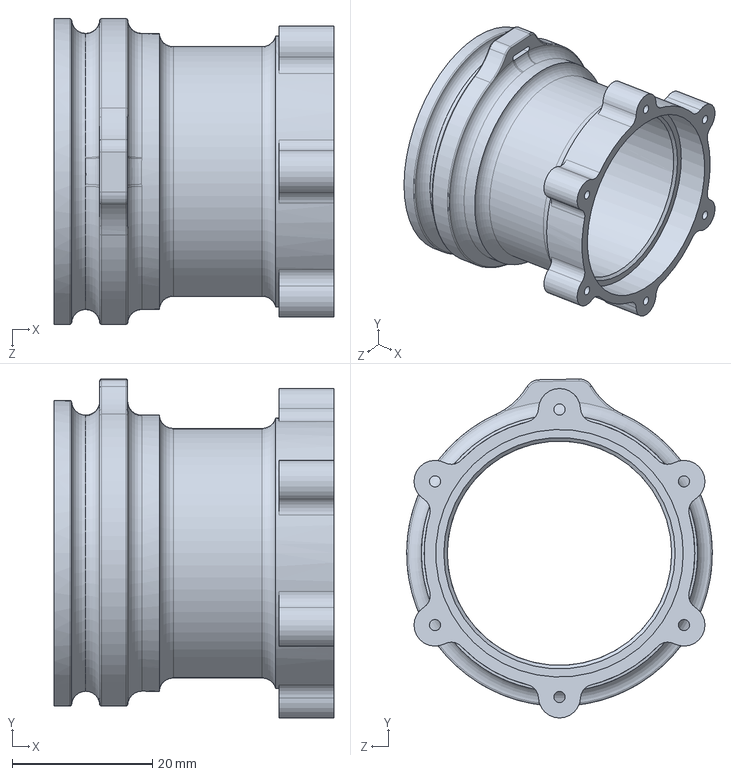
[picture p91: CAD file, 2014-03-23]
mechanics/oncilla/transmission-planetshell-4march2013-abs-print.SLDPRT
39.9 x 48.4 x 43.6 mm
