dpduanpu/OncillaHardware/mechanics/oncilla/BaseBoardRB110.SLDPRT

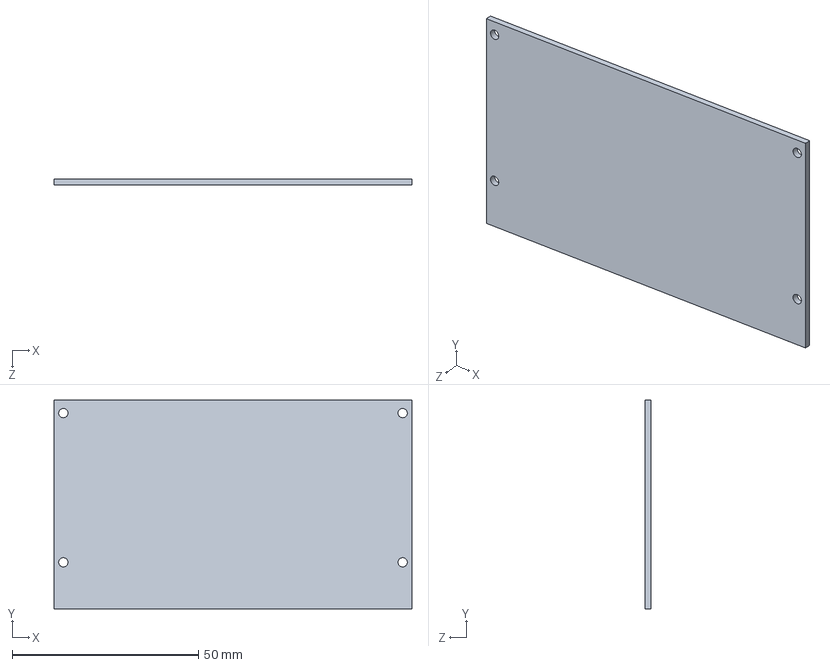
[picture p92: CAD file, 2014-03-23]
mechanics/oncilla/BaseBoardRB110.SLDPRT
96.0 x 56.0 x 1.60 mm
