dpduanpu/OncillaHardware/mechanics/oncilla/Sun_DriverN10h4mm.SLDPRT

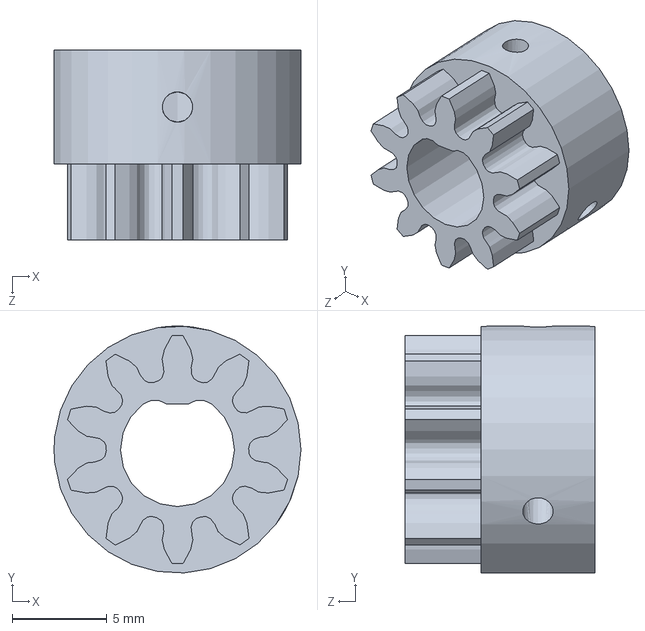
[picture p93: CAD file, 2014-03-23]
mechanics/oncilla/Sun_DriverN10h4mm.SLDPRT
13.0 x 13.0 x 10.0 mm
