dpduanpu/OncillaHardware/mechanics/oncilla/temp_N12_encoder.SLDPRT

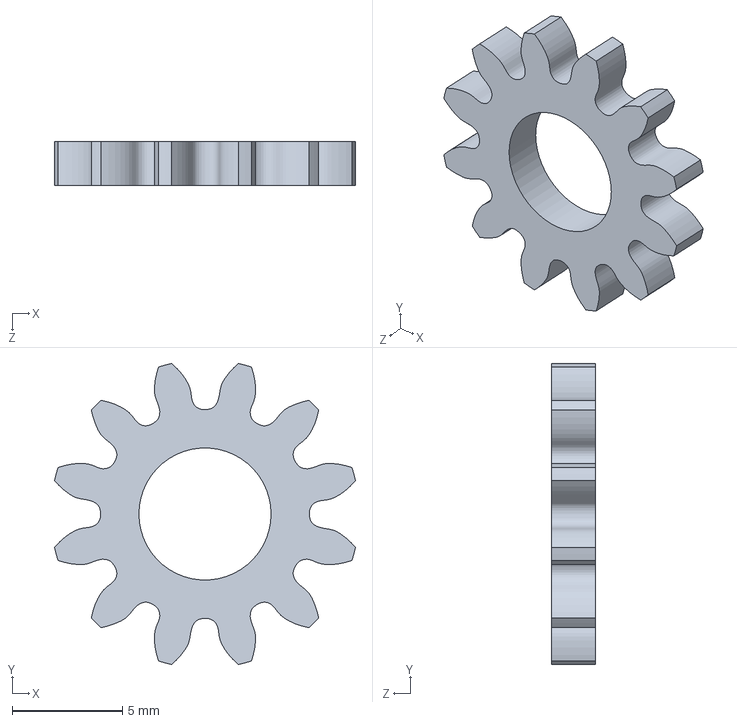
[picture p94: CAD file, 2014-03-23]
mechanics/oncilla/temp_N12_encoder.SLDPRT
13.7 x 13.7 x 2.00 mm
