dpduanpu/OncillaHardware/mechanics/oncilla/corner_bracket.SLDPRT

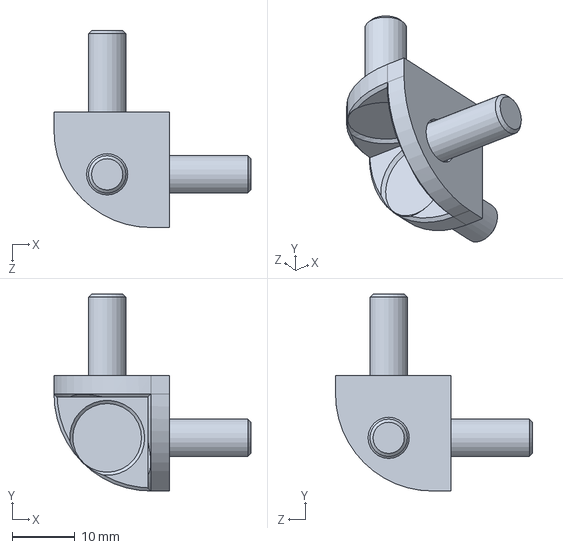
[picture p95: CAD file, 2014-03-23]
mechanics/oncilla/corner_bracket.SLDPRT
31.5 x 31.5 x 31.5 mm
