dpduanpu/OncillaHardware/mechanics/oncilla/strut_profile_20X20Rx315.SLDPRT

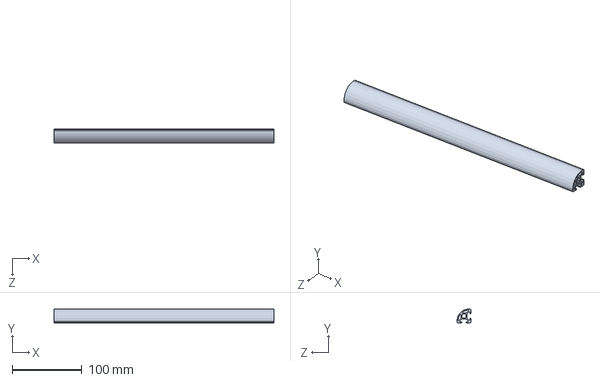
[picture p96: CAD file, 2014-03-23]
mechanics/oncilla/strut_profile_20X20Rx315.SLDPRT
315.0 x 20.0 x 20.0 mm
