dpduanpu/OncillaHardware/mechanics/oncilla/temp_Ring_Gear_Fixed01.SLDPRT

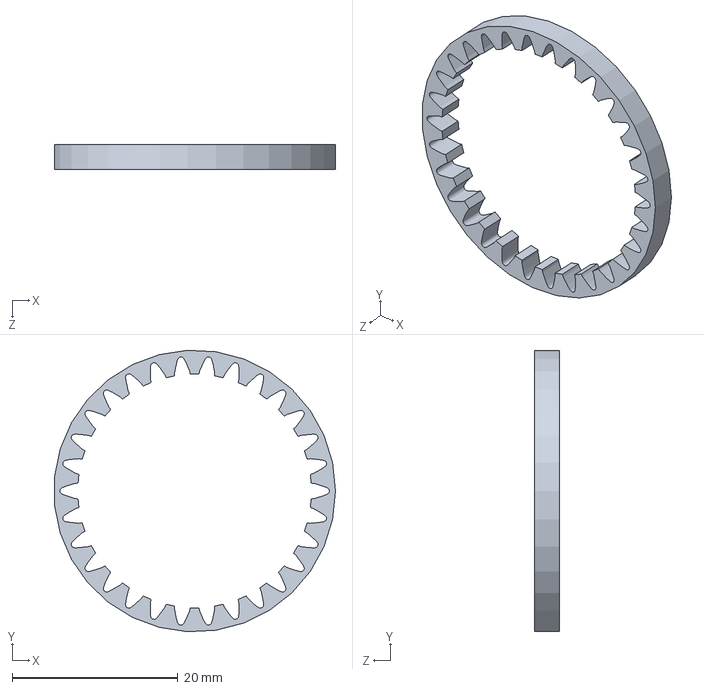
[picture p97: CAD file, 2014-03-23]
mechanics/oncilla/temp_Ring_Gear_Fixed01.SLDPRT
33.9 x 34.0 x 3.00 mm
