dpduanpu/OncillaHardware/mechanics/oncilla/strut_profile_20X20Rx295.SLDPRT

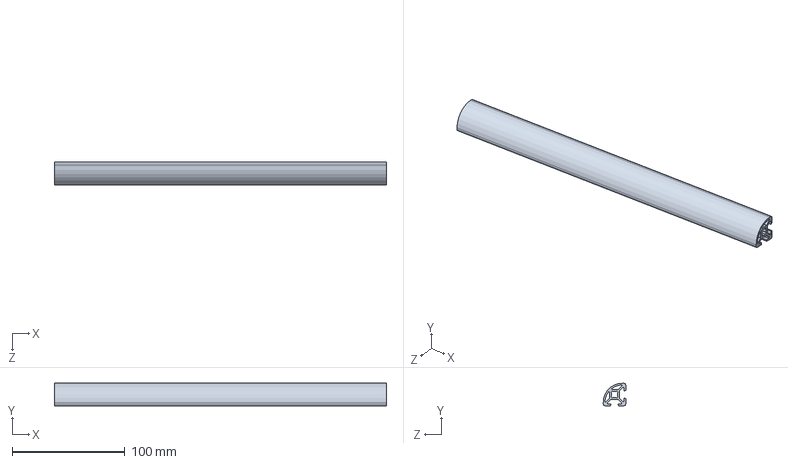
[picture p98: CAD file, 2014-03-23]
mechanics/oncilla/strut_profile_20X20Rx295.SLDPRT
295.0 x 20.0 x 20.0 mm
