dpduanpu/OncillaHardware/mechanics/oncilla/AL-D4-L50-front.SLDPRT

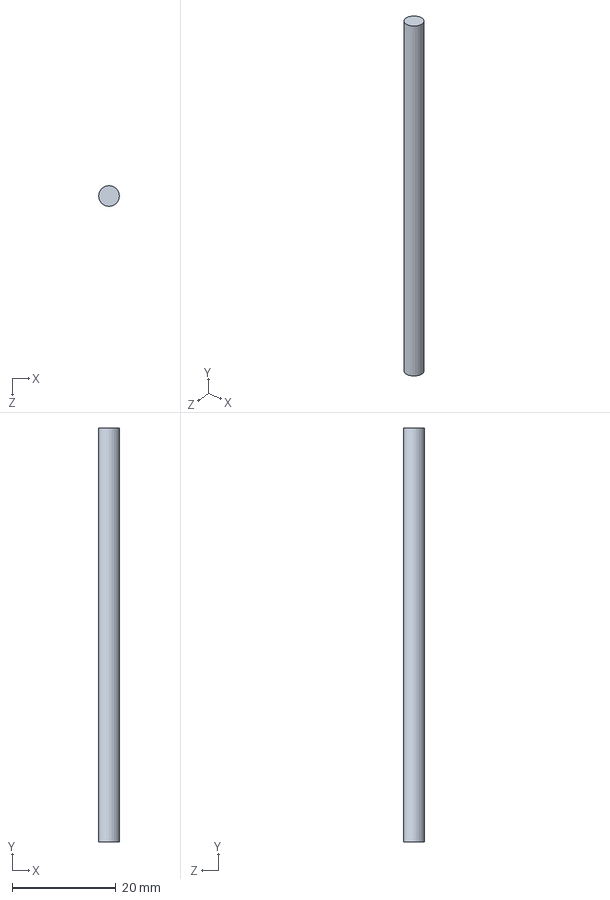
[picture p99: CAD file, 2014-03-23]
mechanics/oncilla/AL-D4-L50-front.SLDPRT
4.00 x 80.0 x 4.00 mm
