dpduanpu/OncillaHardware/mechanics/oncilla/hex-standoff-m2p5-15SLDPRT.SLDPRT

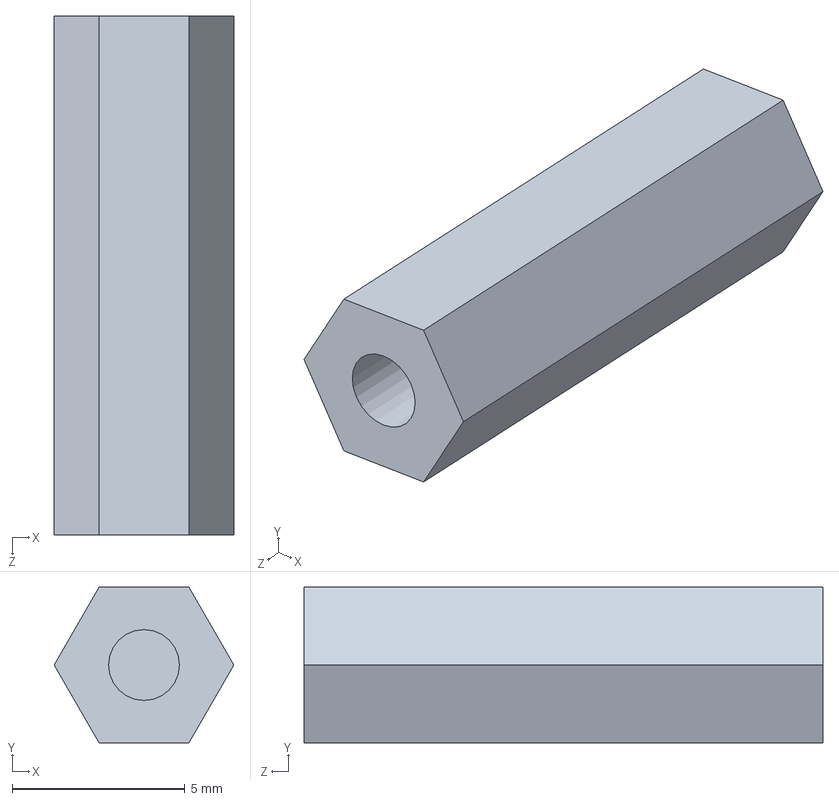
[picture p100: CAD file, 2014-03-23]
mechanics/oncilla/hex-standoff-m2p5-15SLDPRT.SLDPRT
5.20 x 4.50 x 15.0 mm
