dpduanpu/OncillaHardware/mechanics/oncilla/M3L14-BN3-DIN912-ISO4762.SLDPRT

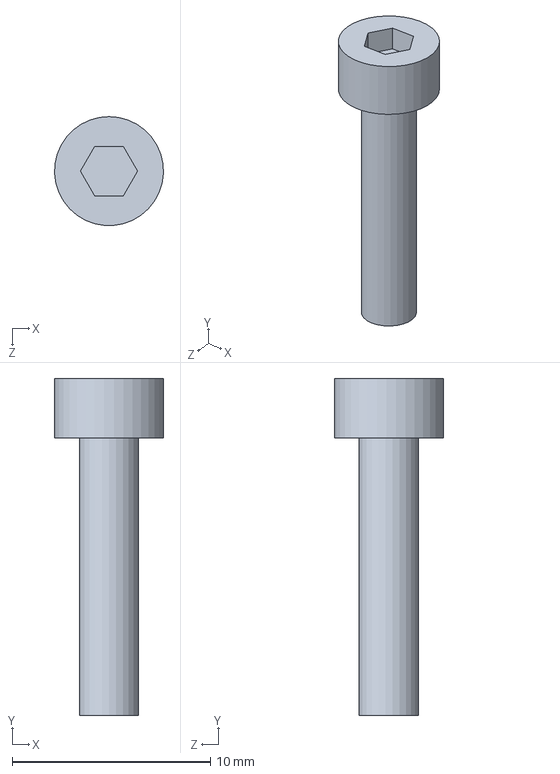
[picture p101: CAD file, 2014-03-23]
mechanics/oncilla/M3L14-BN3-DIN912-ISO4762.SLDPRT
5.49 x 17.0 x 5.49 mm
