dpduanpu/OncillaHardware/mechanics/oncilla/horn-servo-puppy.SLDPRT

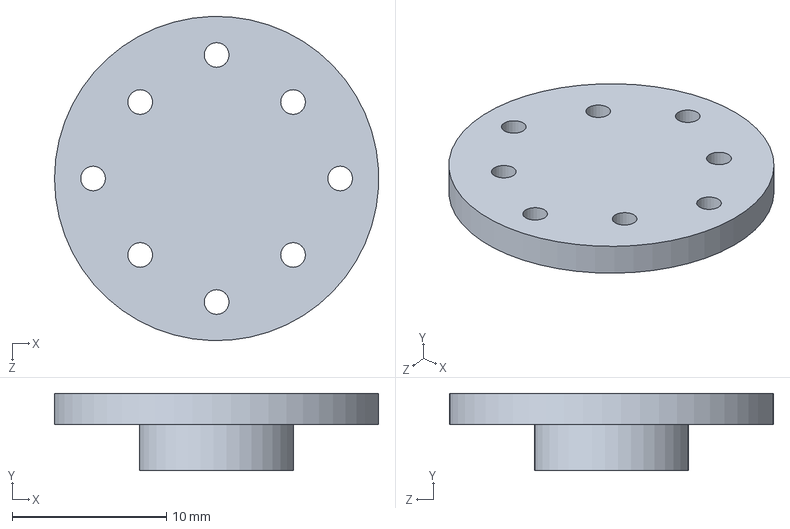
[picture p102: CAD file, 2014-03-23]
mechanics/oncilla/horn-servo-puppy.SLDPRT
21.0 x 5.00 x 21.0 mm
