dpduanpu/OncillaHardware/mechanics/oncilla/load-cell-alu-y-force-beam-outside.SLDPRT

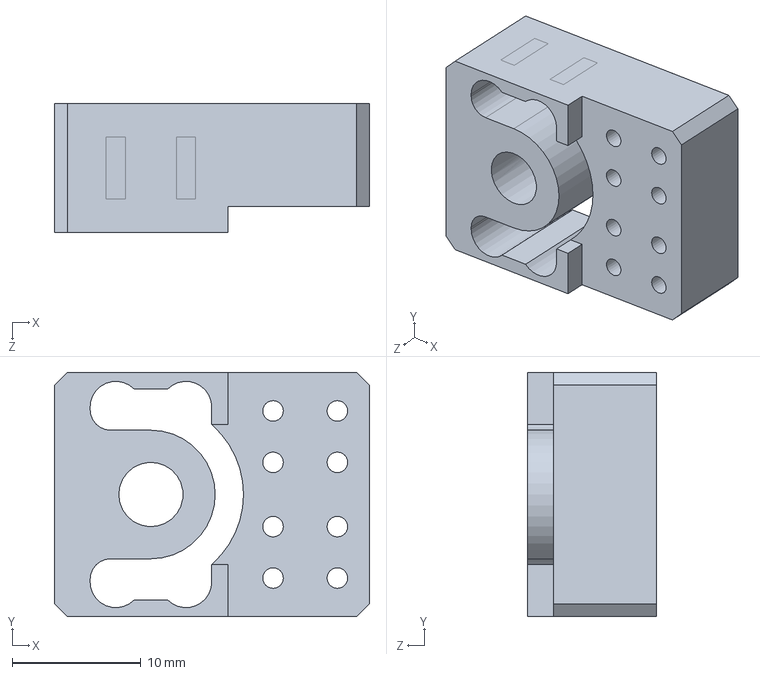
[picture p103: CAD file, 2014-03-23]
mechanics/oncilla/load-cell-alu-y-force-beam-outside.SLDPRT
24.5 x 19.0 x 10.0 mm
