dpduanpu/OncillaHardware/mechanics/oncilla/double-slider.SLDPRT

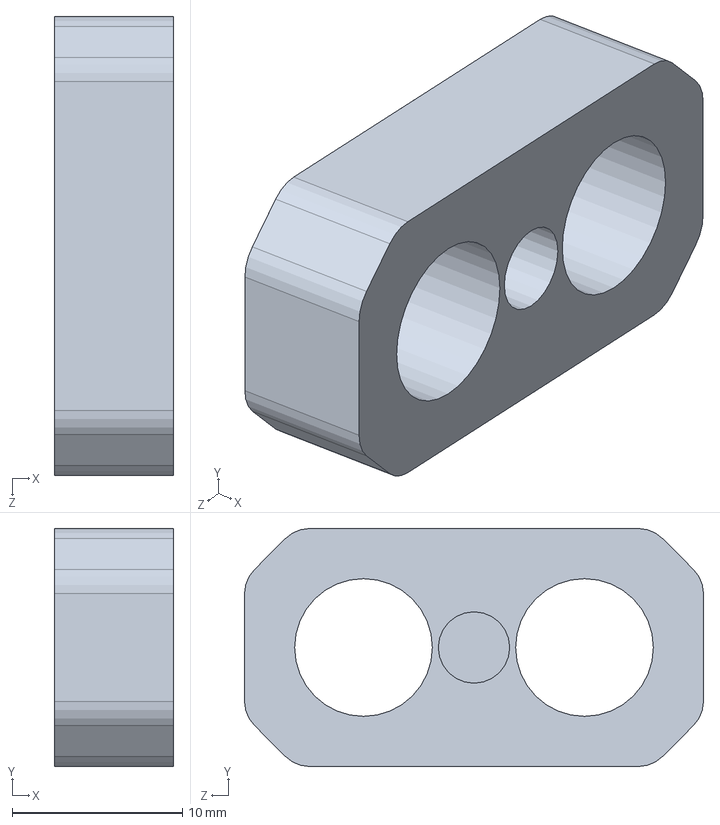
[picture p104: CAD file, 2014-03-23]
mechanics/oncilla/double-slider.SLDPRT
7.00 x 14.0 x 27.0 mm
