dpduanpu/OncillaHardware/mechanics/oncilla/Planet_Revolving_FollowerN10h3mm.SLDPRT

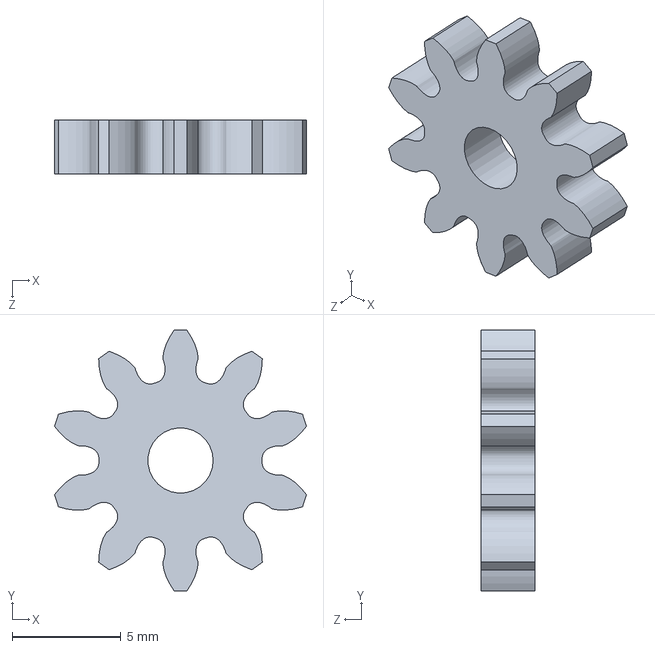
[picture p105: CAD file, 2014-03-23]
mechanics/oncilla/Planet_Revolving_FollowerN10h3mm.SLDPRT
11.6 x 12.0 x 2.50 mm
