dpduanpu/OncillaHardware/mechanics/oncilla/cableshield.SLDPRT

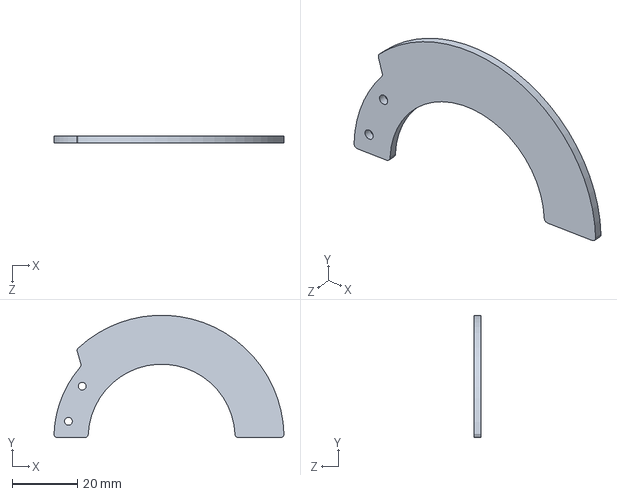
[picture p106: CAD file, 2014-03-23]
mechanics/oncilla/cableshield.SLDPRT
70.5 x 37.5 x 2.00 mm
