dpduanpu/OncillaHardware/mechanics/oncilla/part4-knee-mod1.SLDPRT

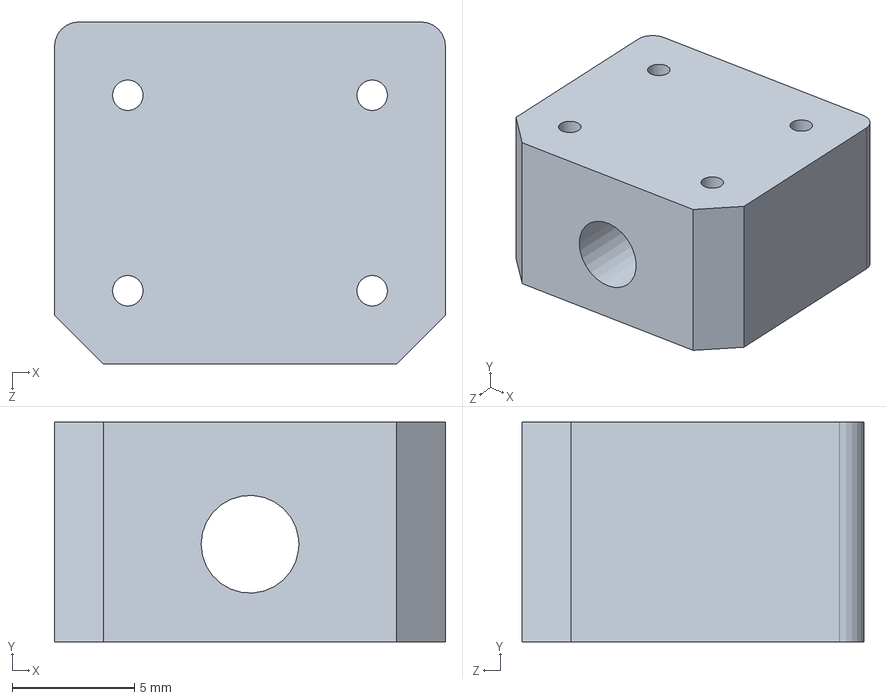
[picture p107: CAD file, 2014-03-23]
mechanics/oncilla/part4-knee-mod1.SLDPRT
16.0 x 9.00 x 14.0 mm
