dpduanpu/OncillaHardware/mechanics/oncilla/abs-connector-mid-front-hind.SLDPRT

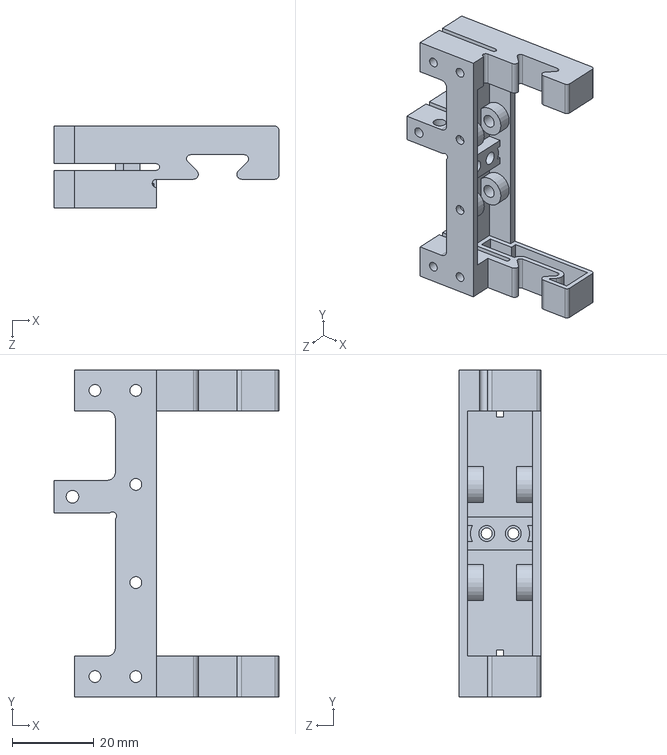
[picture p108: CAD file, 2014-03-23]
mechanics/oncilla/abs-connector-mid-front-hind.SLDPRT
55.0 x 80.0 x 20.0 mm
