dpduanpu/OncillaHardware/(list of files, cad)

Other CAD files:
mechanics/oncilla/Assem1^ASS-spring-diag-front.SLDASM
mechanics/oncilla/AssemL2-front.SLDASM
mechanics/oncilla/Leg-Hind-Left.SLDASM
mechanics/oncilla/RB110.SLDASM
mechanics/oncilla/Mirrorstrut_profile_20X20Rx295.SLDPRT
mechanics/oncilla/Sym-l2-hind-v4-65mm-inside.SLDPRT
mechanics/oncilla/Mirrorcorner_bracket.SLDPRT
mechanics/oncilla/Mirrorstrut_profile_20X20Rx240.SLDPRT
mechanics/oncilla/Sym-ABS-l2_v2-55mm-v2.SLDPRT
mechanics/oncilla/Mirrorstrut_profile_20X20_1Nx240.SLDPRT
mechanics/oncilla/PCBpowerboard.SLDPRT
mechanics/oncilla/Part3.SLDPRT
mechanics/oncilla/abs-servo-connectors-z-version2-down.SLDPRT
mechanics/oncilla/Spring_WM12-40.SLDPRT
mechanics/oncilla/l2-hind-65mm-v4.SLDPRT
mechanics/oncilla/frame-temp.SLDPRT
mechanics/oncilla/25mm-28mm-bush-misumi-10mm.SLDPRT
mechanics/oncilla/AL-D4-L29-front.SLDPRT
mechanics/oncilla/Assem1^Assem1-front.SLDPRT
mechanics/oncilla/POM-fixation-abs-shoulde-rectangle.SLDPRT
mechanics/oncilla/POM-l2_v2-55mm-v3.SLDPRT
mechanics/oncilla/Part1-knee-mod3-front.SLDPRT
mechanics/oncilla/Part120.SLDPRT
mechanics/oncilla/SlipRing2.SLDPRT
mechanics/oncilla/Spring_RSF-1096R.SLDPRT
mechanics/oncilla/Washer-d6p5-12.SLDPRT
mechanics/oncilla/abs-servo-connectors-z-version2.SLDPRT
mechanics/oncilla/al_d5_8p5.SLDPRT
mechanics/oncilla/axis-hip-l10-PM-20120918.SLDPRT
mechanics/oncilla/axis-l25-dia5.SLDPRT
mechanics/oncilla/bush-MDZB6-4-misumi.SLDPRT
mechanics/oncilla/bush-d6-10.SLDPRT
mechanics/oncilla/clamp_lower.SLDPRT
mechanics/oncilla/clamp_upper.SLDPRT
mechanics/oncilla/distancepiece_legsprings_011112_Mill_Pom.SLDPRT
mechanics/oncilla/foot-print-mod1.SLDPRT
mechanics/oncilla/fr4-0p8-pcb-bridge-force-sensor.SLDPRT
mechanics/oncilla/knee_encoder_front-ver-april18.SLDPRT
mechanics/oncilla/knee_encoder_hind-ver-april18th.SLDPRT
mechanics/oncilla/l3-sandwich-hind.SLDPRT
mechanics/oncilla/load-cell-alu-beam-force-horizontal-2012-08-25.SLDPRT
mechanics/oncilla/lock washer for shafts_din.sldprt
mechanics/oncilla/pin-d6-l33.SLDPRT
mechanics/oncilla/strut_profile_20X20Rx240.SLDPRT
mechanics/oncilla/strut_profile_20X20_1Nx240.SLDPRT
mechanics/oncilla/strut_profile_20X20_1Nx315.SLDPRT
mechanics/oncilla/washer-m3-6-3-1.SLDPRT
mechanics/oncilla/washer-m3-douter8p9-width1p3.SLDPRT
