dpduanpu/OncillaHardware/TODO.md

# To do list

Please find here a small todo list for this repository

 * Updates the power supply board schematics for the 9V output instead
   of 6V (Alexandre)
 * Checkout conformity of Mechanical design (Peter? Massimo?).
 * Adds more documentation about oncilla overall architecture
   (Alexandre). This repo should be self-containing, and not rely on
   AMARSi redmine.
 * Migrate / Mirror to official AMARSi website (Alexandre).
 * Updates SolidWork file to enable value / measure in eDrawing
   (Massimo?)
