dpduanpu/OncillaHardware/electronics/magnetic-encoders/l1/pdf/l1.PDF

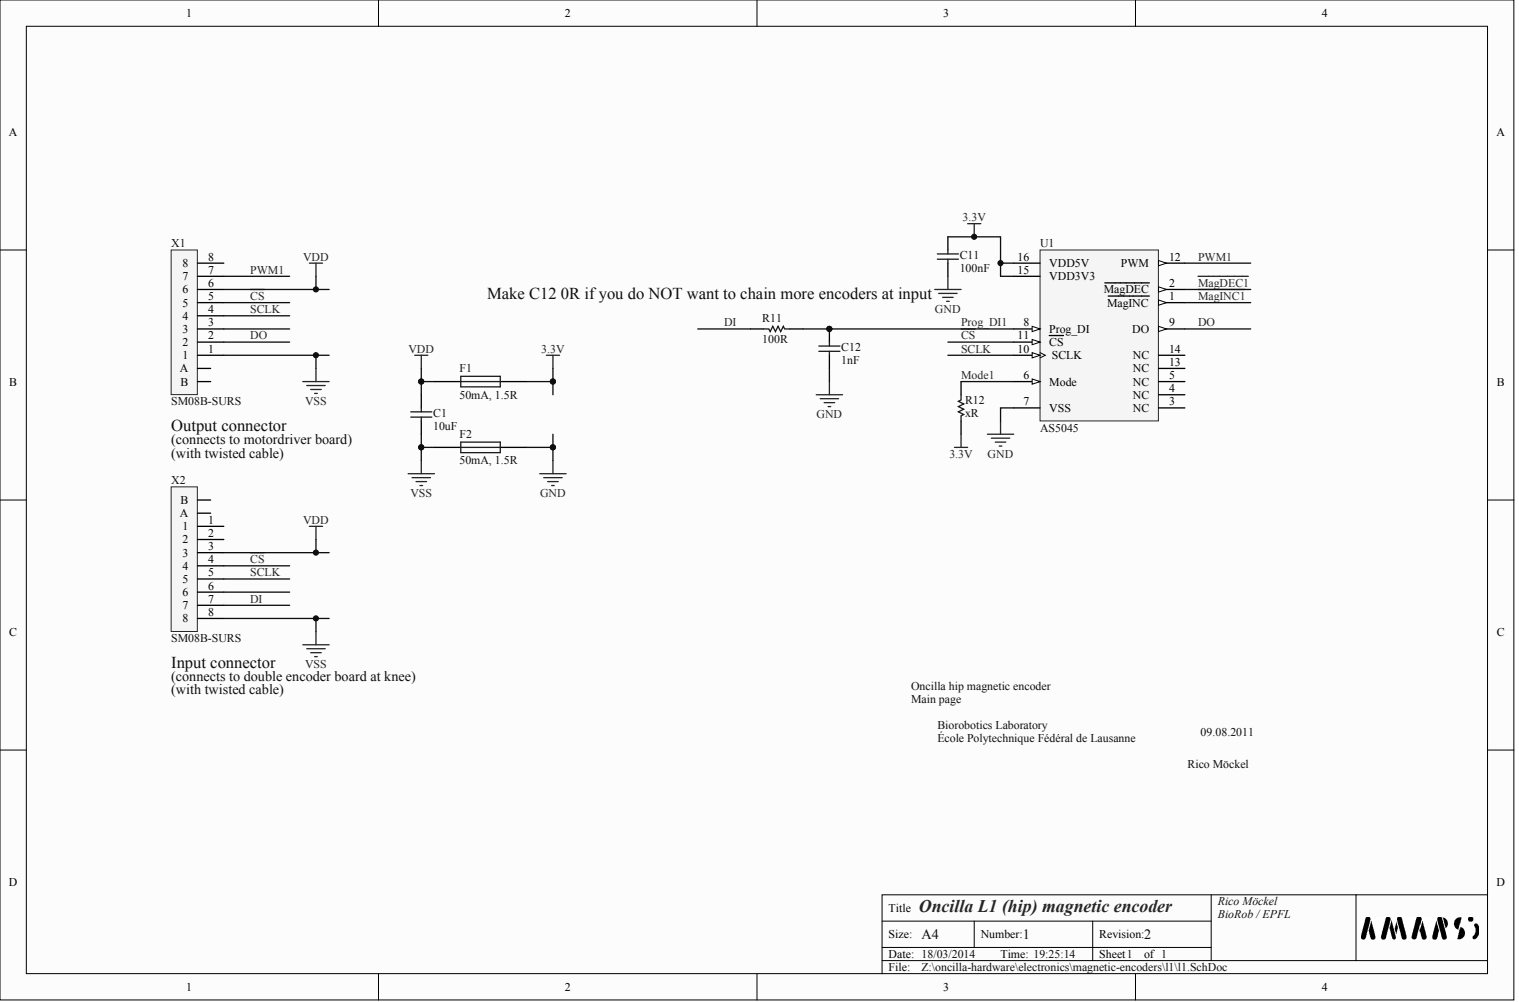
[picture p133: page 1]

Make C12 0R if you do NOT want to chain more encoders at input

SM08B-SURS
Output connector
(connects to motordriver board)
(with twisted cable)

Oncilla hip magnetic encoder
Main pag

Biorobotics Laboratory
École Polytechnique Fédéral de Lausanne

Title | Rico Möckel BioRob / EPFL

A4 Size: | Number: | Revision:
Date: 18/03/2014 Time: 19:25:14 Z:\oncilla-hardware\electronics\magnetic-encoders\l1\l1.SchDoc | | Sheet 1 of 1

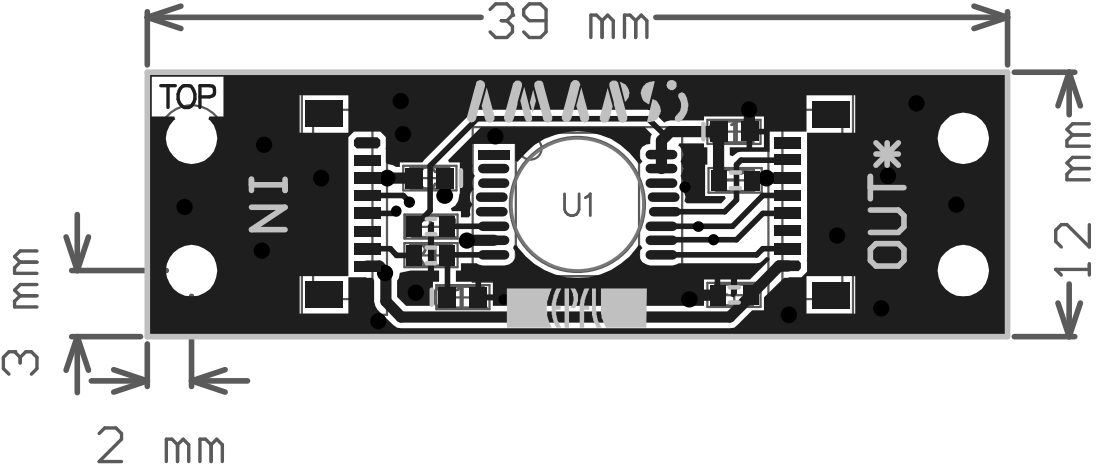
[picture p134: page 2]

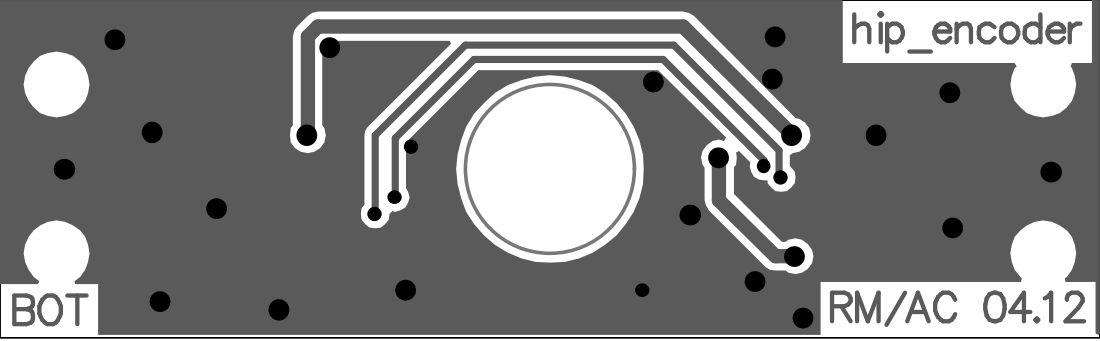
[picture p135: page 3]

Part List | Oncilla L1 (hip) magnetic encoder
Source Data From: | l1.SchDoc
Project: | | l1.PrjPcb
Variant: | | None
Report Date: 18/03/2014 | 19:25:21
Print Date: | 18-Mar-14 | 7:25:27 PM
Designator | Comment | LibRef | Footprint | Description
C1 | 10uF | Cap | CAPC1608L | Capacitor
C11 | 100nF | Cap | CAPC1608L | Capacitor
C12 | 1nF | Cap | CAPC1608L | Capacitor
F1, F2 | 50mA, 1.5R | Fuse 1 | RESC1608L | Ferrit Bead
R11 | 100R | Res1 | RESC1608L | Resistor
R12 | xR | Res1 | RESC1608L | Resistor
U1 | AS5045 | AS5045 | SSOP16 | 12 Bit Programmable Magnetic Rotary Encoder
X1, X2 | SM08B-SURS | SM08B-SURS | SM08B-SURS | wire-to-board connector
