dpduanpu/OncillaHardware/electronics/magnetic-encoders/l2-l3/pdf/l2-l3-hind.PDF

Make R13 1nF for chaining more encoders at input

Oncilla L2 and L3 (pantographic Knee) Magnetic encoder
Main pag

Biorobotics Laboratory
École Polytechnique Fédéral de Lausanne

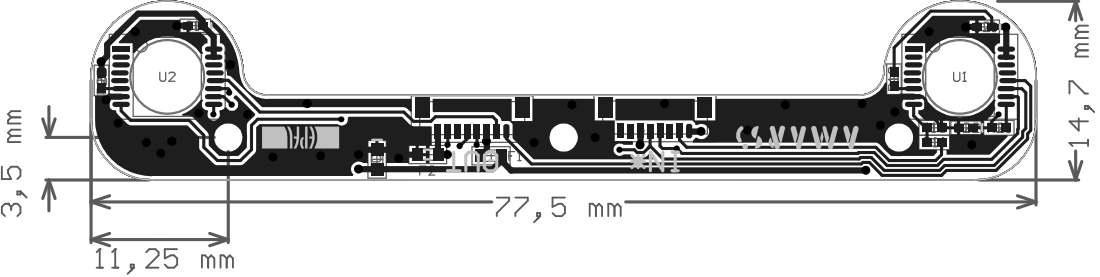
[picture p139: page 2]

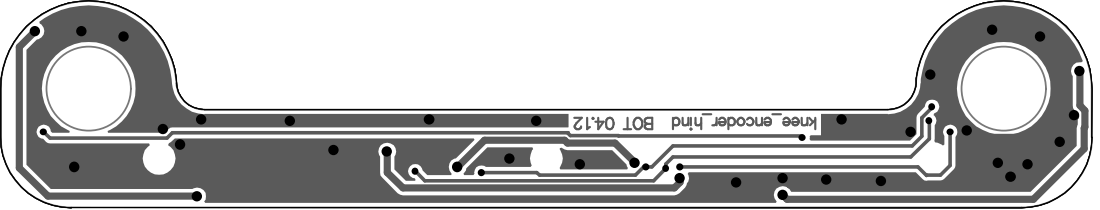
[picture p140: page 3]

Part List | <Parameter Title not found>
Source Data From: | l2-l3.SchDoc
Project: | | l2-l3.PrjPcb
Variant: | | None
Report Date: 18/03/2014 | 19:11:40
Print Date: | 18-Mar-14 | 7:11:46 PM
Designator | Comment | LibRef | Footprint | Description
C1 | 10uF | Cap | CAPC1608N | Capacitor
C11, C21 | 100nF | Cap | CAPC1005N | Capacitor
C22 | 1nF | Cap | CAPC1005N | Capacitor
F1, F2 | 50mA, 1.5R | Fuse 1 | RESC1608N | Ferrit Bead
R11, R12, R22 | xR | Res1 | RESC1005N | Resistor
R13 | 0R | Res1 | RESC1005N | Resistor
R21 | 100R | Res1 | RESC1005N | Resistor
U1, U2 | AS5045 | AS5045 | SSOP16 | 12 Bit Programmable Magnetic Rotary Encoder
X1, X2 | SM08B-SURS | SM08B-SURS | SM08B-SURS | wire-to-board connector
