dpduanpu/OncillaHardware/(list of files, drawings)

Other design files:
electronics/load-cell-drivers/load-cell.PcbDoc
electronics/load-cell-drivers/load-cell.PrjPCB
electronics/load-cell-drivers/load-cell.SchDoc
electronics/magnetic-encoders/l1/l1.PcbDoc
electronics/magnetic-encoders/l1/l1.PrjPcb
electronics/magnetic-encoders/l1/l1.SchDoc
electronics/magnetic-encoders/l2-l3/l2-l3-front.PcbDoc
electronics/magnetic-encoders/l2-l3/l2-l3-hind.PcbDoc
electronics/magnetic-encoders/l2-l3/l2-l3.PrjPcb
electronics/magnetic-encoders/l2-l3/l2-l3.SchDoc
electronics/motordriver/connectors.SchDoc
electronics/motordriver/driver1.SchDoc
electronics/motordriver/driver2.SchDoc
electronics/motordriver/drivers.SchDoc
electronics/motordriver/dsPIC.SchDoc
electronics/motordriver/motordriver.PcbDoc
electronics/motordriver/motordriver.PrjPCB
electronics/motordriver/motordriver_mnt.PcbDoc
electronics/motordriver/power.SchDoc
electronics/power/Connectors.SchDoc
electronics/power/CurrentSensor.SchDoc
electronics/power/dsPIC.SchDoc
electronics/power/Leds.SchDoc
electronics/power/Power_6V.SchDoc
electronics/power/Power_24V.SchDoc
electronics/power/Power_onboard.SchDoc
electronics/power/powerboard.PcbDoc
electronics/power/powerboard.PrjPcb
electronics/power/powerboard_4layer.PcbDoc
electronics/sbcp-master/dsPIC.SchDoc
electronics/sbcp-master/Power3.3V.SchDoc
electronics/sbcp-master/sbcp-master.PcbDoc
electronics/sbcp-master/sbcp-master.PrjPcb
electronics/sbcp-master/sbcp-master.SchDoc
