dpduanpu/OncillaHardware/(commit log)

2014-03-17 Imports original SBCPMaster schematics
    [MasterComm.PrjPcb, MasterComm.SchDoc, Power3.3V.SchDoc, RS485new2.PcbDoc, dsPIC.SchDoc]
2014-03-17 Renames MasterComm sbcp-master
    [MasterComm.PrjPcb, MasterComm.SchDoc, RS485new2.PcbDoc, sbcp-master.PcbDoc, sbcp-master.PrjPcb, sbcp-master.SchDoc]
2014-03-18 Put all output in a single documentation file
    [Power3.3V.SchDoc, dsPIC.SchDoc, sbcp-master.SchDoc]
2014-03-18 Adds L2 - L3 Magnetic encoder PCBs
    [l2-l3-front.PcbDoc, l2-l3-hind.PcbDoc, l2-l3.PrjPcb, l2-l3.SchDoc]
2014-03-18 Adds L1 (Hip) encoder
    [l1.PcbDoc, l1.PrjPcb, l1.SchDoc]
2014-03-18 Adds load cell PCB
    [load-cell.PcbDoc, load-cell.PrjPCB, load-cell.SchDoc]
2014-03-19 Adds motordriver PCB
    [connectors.SchDoc, driver1.SchDoc, driver2.SchDoc, drivers.SchDoc, dsPIC.SchDoc, motordriver.PcbDoc, motordriver.PrjPCB, motordriver_mnt.PcbDoc]
2014-03-23 Adds powerboard schematics
    [Connectors.SchDoc, CurrentSensor.SchDoc, Leds.SchDoc, Power_24V.SchDoc, Power_6V.SchDoc, Power_onboard.SchDoc, dsPIC.SchDoc, powerboard.PcbDoc]
2014-03-23 Adds Oncilla Mechanic blueprints
    [25mm-28mm-bush-misumi-10mm.SLDPRT, 60s.SLDPRT, ABS-l2_v2-55mm-v2.SLDPRT, AL-D4-L29-front.SLDPRT, AL-D4-L50-Hind.SLDPRT, AL-D4-L50-front.SLDPRT, ASS-spring-diag-front_Left.SLDASM, ASS-spring-diag-hind.sldasm]
2014-03-24 adds depreceated notice on powerboard schematics
2014-03-28 Mechanical model updated (Solidworks 2013)
    [ABS-l2_v2-55mm-v2.SLDPRT, ASS-spring-diag-front_Left.SLDASM, ASS-spring-diag-hind.sldasm, Assem1-knee-mod1-hind-mirror.SLDASM, Assem1-knee-mod1-hind.SLDASM, Assem1-knee-mod2-front-mirror.SLDASM, Assem1-knee-mod2-front.SLDASM, Assem1^ASS-spring-diag-front.SLDASM]
